Guiimartinho/open-power-profiler/hardware/README.md

# Hardware

The carrier board of the instrument: schematic, PCB layout and fabrication
outputs. The simulations of its circuits are a package of their own, in
[`../simulation/`](../simulation/README.md).

The instrument is two boards. A Raspberry Pi Pico 2, bought ready-made, is
the controller. It plugs into two rows of pin sockets on the carrier board
designed here, which holds everything else: power input, source meter, shunt
ladder, signal chain, side data and connectors. Sections 4.11 and 5 of the
[specification](../docs/specification.md) define the interface.

Rendered view of the carrier board, draft A2

The picture is a rendering from the KiCad files, with the Pico 2 on its
sockets. It is not a photograph: no board has been built.

## Status

Draft A2 with a reviewed layout, as of 2026-10-13. The KiCad project holds
the whole carrier board: the schematic with 428 parts on fifteen A4 pages
(the root sheet and fourteen sheets) and a four-layer board of
150 mm × 100 mm on which every connection is drawn. The board was placed by
a script and routed by an autorouter, which left 28 connections open. On
2026-10-10 its layout was reviewed with scripts: the open connections were
closed and the copper that an autorouter does not draw was drawn. Every
figure of the board in this guide is calculated from the drawn copper. On
the same day the circuits of the schematic were simulated from its netlist,
block by block; the central design figures of the specification come out
again ([Circuit Simulations](#circuit-simulations)). The simulations
raised four points, which the owner decided the same day: decisions D-95
to D-98 of the specification. Three of them are drawn since that day, as
changes of values, part numbers, fitted flags and texts: 10 nF at C32 to
C34 (D-95), the damper R14 and C5 fitted (D-98), and the text of the
position U9, which stays without a part (D-97). They changed no copper and
moved no part. The fourth is not drawn: a position for a capacitor at the
buffer U28 (D-96), which needs a footprint and copper. The simulations
were not run again, so their results describe the circuit before the
three changes
([Decisions That Follow the Simulations](#decisions-that-follow-the-simulations)).

On 2026-10-13 the owner opened the project in the KiCad editor, the
schematic and the board, and found both coherent. That was a look, not a
review item by item, and no edit was saved. The same day the footprints
and the placement were reviewed on a copy of the project, with scripts on
the board file, 3D renderings of every region of the board and the
datasheets. Five findings of that review were worked into the board, at
those points only and with no new routing: the pre-regulator U16 has the
land pattern of its own package, eleven vias were moved away from pads and
from under the wall of the shield can, reference texts stand at their own
parts, and the console header J1 has the names of its pins. The silkscreen
also carries the frames and names of the sixteen functional blocks now
([Review of Footprints and Placement](#review-of-footprints-and-placement-2026-10-13)).
Both rule checks report nothing on the present files (run on 2026-10-13).
Nobody has reviewed the board item by item in the KiCad editor, no board
is built, and nothing is measured.

Later that day the owner asked for the files that are needed to send the
board to fabrication. The fabrication outputs of draft A2 are filed in
[`fabrication/draft-a2/`](fabrication/draft-a2/README.md) for an order of
proof-of-concept boards. That is decision D-105 of the specification: the
items that the specification puts before an order are still open, boards
made from these files are draft A2 and not revision A, and those items
stay open
([Fabrication Outputs of Draft A2](#fabrication-outputs-of-draft-a2)).
No order is recorded: no board has been ordered or made as far as the
repository shows.

| What | State |
| --- | --- |
| Schematic | Every sheet drawn: 428 parts, 225 nets, 15 pages; not changed by the layout review. Three decisions of 2026-10-10 are drawn in it since that day, as changes of values, part numbers, fitted flags and texts: 10 nF at C32 to C34 (D-95), R14 and C5 fitted (D-98), the text of the position U9 (D-97). One is not drawn: the position for a capacitor at U28 (D-96). On 2026-10-13 one field changed and no connection: U16 on the Source Meter sheet, and its symbol in the project library, name the new project footprint |
| Electrical rules check | 0 errors, 0 warnings; run again on 2026-10-13, after the round that followed the review of footprints and placement |
| Netlist against datasheets | Checked independently, before the three decisions were drawn; no blocker and no major defect found |
| Symbols and footprints against libraries and datasheets | Compared on 2026-10-13: every footprint of the board equals its library footprint pad by pad, 55 of the 59 symbols of the parts are unchanged symbols of the KiCad library, and the four project symbols agree pin by pin with their datasheets ([list](#what-was-compared)). It closes no component check |
| Bill of materials | 151 lines for 370 parts, each line with a part number and a maker; three lines without stock on 2026-10-09; not changed by the layout review. Exported again on 2026-10-10: it holds 10 nF at C32 to C34 (D-95) and the two parts of the damper, R14 and C5 (D-98). Exported again on 2026-10-13: one line changed, the footprint of U16 |
| Component checks | 0 closed; every part is a candidate |
| Board, placement | 425 footprints placed by a script, all on the top side; 35 of them moved or turned in the layout review, none since. Reviewed on 2026-10-13 with scripts on the board file, 3D renderings and datasheets: no courtyard overlaps another, nothing stands under the module, 58 parts stand inside the shield can and none across its wall ([list](#what-was-compared)). Not reviewed item by item by a person in the KiCad editor |
| Board, routing | 984 of 984 connections, none open: 8.40 m of track in 3,743 segments, 694 vias, 42 copper zones. The round of 2026-10-13 routed nothing again: it moved eleven vias and added 27 short pieces of track, 15.9 mm in all, to the 3,716 segments that the board had (8.38 m), which are unchanged |
| Design rules check with schematic parity | 0 violations, 0 unconnected pads, 0 footprint errors, 0 differences between board and schematic, against a rule file that asks more than the one of the autorouted board; run again on 2026-10-13, after the round of that day |
| Layout review | Done on 2026-10-10 with scripts and checked by independent calculation |
| Look in the KiCad editor | On 2026-10-13 the owner opened the schematic and the board in the KiCad editor and found both coherent. A look, not a recorded review item by item; no edit was saved |
| Review of footprints and placement | Done on 2026-10-13 on a copy of the project, with scripts on the board file, 3D renderings of every region of the board and the datasheets. Five findings, each worked into the board the same day ([section](#review-of-footprints-and-placement-2026-10-13)) |
| Silkscreen | Since 2026-10-13: the frames and names of the sixteen functional blocks, the pin names of the console header J1, and 330 of the 425 reference texts visible, each at its own part; 95 are hidden, and every hidden reference is on the fabrication layer. Missing: the net names of the test points, the functions of the two jumpers and a frame for the serial number |
| 1 A path, copper only | 19.5 squares (10.4 mΩ at 40 °C) in source mode and 23.3 squares (12.3 mΩ at 40 °C) in ampere mode, against a limit of 30 squares; calculated from the drawn copper, again on 2026-10-13 with the same result |
| Surface leakage into the measured node | 5.1 nA against a budget of 10 nA; calculated from the drawn copper with the assumptions of section 10.3 of the specification, again on 2026-10-13 with the same result |
| Deviations from the words of section 10 | Seven, each recorded as a decision of the specification on 2026-10-10: D-87 to D-93 ([list](#decisions-of-the-layout-review-d-87-to-d-93)) |
| Open items of the layout | Eleven that need parts moved or another footprint, and five points that the layout review did not touch ([list](#open-items)). The round of 2026-10-13 worked on two of them, the vias at pads and the hidden reference texts; what it left is listed with it ([list](#still-open-after-the-round)) |
| Thermal check of the linear regulator | Open: the temperature rise of U18 at full dissipation is read on the first board (D-93) |
| Calculation scripts | In [`tools/board/`](../tools/board/README.md): they calculate the figures of the board again from the board file ([how](#reproducing-the-figures)) |
| Circuit simulations | Done on 2026-10-10 from the netlist of this schematic as it stood before the three drawn decisions, in [`../simulation/`](../simulation/README.md): 134 benches, 93 on the circuits of the board and 41 on the models; 1834 figures pass, 122 fail and 1206 carry no limit. Not run again since: the netlist snapshot holds the three changes, the results do not. The snapshot still matches the schematic on 2026-10-13; the round of that day did not change the circuit. Every active part is a model written from its datasheet; nothing is measured |
| Decisions that follow the simulations | Four, decided by the owner on 2026-10-10: D-95 to D-98. Drawn since that day: 10 nF at C32 to C34 of the rail monitor, the damper R14 and C5 fitted, and the text of the detector position U9, which stays without a part. Not drawn: a position for a capacitor at the buffer U28, which needs a footprint and copper ([list](#decisions-that-follow-the-simulations)) |
| PIO programs | Not written |
| Fabrication outputs | Filed on 2026-10-13 in [`fabrication/draft-a2/`](fabrication/draft-a2/README.md): eleven Gerber files of the four-layer board and two drill files, also as one archive, and two assembly files with the 360 surface-mount placements of the top side in 142 lines. Exported from the board file of this directory; the drill file and the coordinate frame were checked. No Gerber viewer has read the files back, and no manufacturer has reviewed them ([section](#fabrication-outputs-of-draft-a2)) |
| Order of proof-of-concept boards | Decided by the owner on 2026-10-13 (D-105): boards of draft A2 may be ordered with the items before an order still open; they are not revision A. The outputs are filed and the order is the owner's. None is recorded: no board has been ordered or made as far as the repository shows |
| Measurements | None: no board has been built |

What the draft has behind it:

- The schematic passes the electrical rules check of KiCad with no errors
  and no warnings. The netlist that KiCad exports equals the netlist the
  drawings were generated from (428 parts, 225 nets), and every symbol pin
  has a pad in its footprint (65 pairs of symbol and footprint). That
  comparison was made before the three decisions below were drawn; they
  changed fields of six parts and no connection.
- Three decisions that follow the simulations are drawn since 2026-10-10
  (D-95, D-97 and D-98), as changes of values, part numbers, fitted flags
  and texts on three sheets and on six footprints of the board. No wire,
  track, via, zone or pad changed, and no footprint moved. Both checks
  were run again on the changed files on 2026-10-12 and report nothing.
  The bill of materials, the PDF, the pictures of the three sheets and
  the two renderings of the board were exported again from them
  ([Decisions That Follow the Simulations](#decisions-that-follow-the-simulations)).
- The netlist was checked independently against the datasheets: symbol,
  footprint and ratings of every part type that is new in this draft, and
  six subsystems as a whole (power, source meter, ampere path, measuring
  chain, controller and logic, and the seams between the blocks). That
  check found no blocker and no major defect. It is not a component check:
  it closes no item of section 16 of the specification. Its notes are not
  filed in this repository, so the result can be read here but not
  inspected: it counts as a review, not as evidence.
- Every line of the bill of materials has a part number and a maker (151
  lines for 370 parts; section 17 of the specification).
- The board is fully connected: 984 of 984 connections. It passes the
  design rules check of KiCad with no rule violation, no unconnected pad
  and no difference between board and schematic ([Checks](#checks)).
- The layout was reviewed against the rules of section 10 of the
  specification: the 1 A path is drawn as pours, a guard surrounds the
  measured node, the Kelvin lines are drawn again, the 5 V rail is a pour
  and two layers carry ground fills. Each block was drawn with scripts and
  then calculated again by an independent check, and a final review of the
  whole board recorded 75 findings, of which 41 were open at its end
  ([Layout Review](#layout-review)).
- The figures of the board are calculated from the drawn copper: squares
  and resistance of a pour, surface leakage with an assumed sheet
  resistance, lengths of tracks and distances between copper. None is a
  measurement. The scripts that calculate the resistance of the 1 A path,
  the lengths of the pairs, the vias on the sense nets and the surface
  leakage are in [`tools/board/`](../tools/board/README.md), so those
  figures can be calculated again from the board file
  ([Reproducing the Figures](#reproducing-the-figures)).
- The seven points in which the board departs from the words of section 10
  of the specification are decisions of the specification, D-87 to D-93,
  accepted by the owner on 2026-10-10 on the recommendation of the layout
  review. Sections 10.3, 10.4, 10.6 and 10.8 of the specification say what
  the board has
  ([list](#decisions-of-the-layout-review-d-87-to-d-93)).
- The circuits of the schematic were simulated in ngspice from its
  netlist, block by block: a bench names parts by their reference
  designators and their elements are written from a snapshot of the
  netlist, so no part of the board is typed by hand. What stands around
  the parts is typed by the bench: sources, loads, cables, and in some
  benches a stand-in for a neighboring block. The central design figures
  of the specification come out again: the shunts and the burden, gain,
  zero and settling of the chain, the thresholds and the jump path, the
  drop of requirement R-07, the set-point and the head room of the
  source, the in-rush at the output, the order of the rails and the
  limits of the power input. The models are written from datasheets, and
  41 benches put them into the test circuits of those datasheets. The
  runs are those of 2026-10-10, on the circuit before the three drawn
  decisions ([Circuit Simulations](#circuit-simulations)).
- On 2026-10-13 the owner opened the project in the KiCad editor and found
  the schematic and the board coherent. It was the first time a person
  looked at the drawings there. It was a look: nothing was recorded item
  by item, and no edit was saved.
- The same day the footprints and the placement were reviewed on a copy of
  the project, with scripts on the board file, 3D renderings of every
  region of the board and the datasheets. Every footprint of the board
  equals the footprint of the same name in its library, the four project
  symbols agree pin by pin with their datasheets, and the terminal block,
  the USB-C receptacle, the socket strips and the 0.1 Ω shunt agree with
  the drawings of their makers. No courtyard overlaps another, and no part
  stands under the module. The five findings of that review are worked
  into the board: the land pattern of U16, vias at pads and under the wall
  of the shield can, reference texts, and the pin names of J1
  ([Review of Footprints and Placement](#review-of-footprints-and-placement-2026-10-13)).
- The fabrication outputs of the board are filed since 2026-10-13, for an
  order of proof-of-concept boards (D-105). Two things were checked on
  them: the drill file holds 787 plated holes, which are the 694 vias and
  the 93 holes of pads of the board, and every layer, the drill file and
  the placement file lie in one coordinate frame
  ([Fabrication Outputs of Draft A2](#fabrication-outputs-of-draft-a2)).
- The notes on the sheets were compared with the specification figure by
  figure and corrected where they differed, and the notes of the three
  sheets that the drawn decisions changed follow them. The six pictures of
  the board in [`doc/`](doc/README.md) were plotted again on 2026-10-13
  from the final board file, and the PDF was exported again that day. Its
  fifteen pages are the same as before: the one change of the schematic
  since 2026-10-10, the footprint field of U16, is hidden on its sheet.
  The pictures of the sheets are those of 2026-10-09 and 2026-10-10.

It is not a checked design, and it is not revision A. The owner decided on
2026-10-13 that proof-of-concept boards may be ordered from it as it
stands (D-105). Every point below holds for such boards too:

- Nothing has been built and nothing has been measured. Every figure in
  these documents is a datasheet value, a calculation, a simulation or an
  estimate; the specification says which.
- The parts are the candidates of the specification. No component check of
  [`docs/checks/`](../docs/checks/README.md) is closed, and the open checks
  of section 16 of the specification stand, the bench items among them.
- The layout review was done with scripts, and so was the review of
  footprints and placement of 2026-10-13. The owner opened the project in
  the KiCad editor that day and found it coherent, which was a look.
  Nobody has reviewed the board there item by item, as a person does
  before ordering boards.
- Eleven items of the layout are open because they need parts moved or
  another footprint, the loops of the converter capacitors among them, and
  five points of section 10 were not touched by the layout review. One of
  the eleven is done in part since 2026-10-13: nine vias were moved away
  from pads, and two still stand at one.
- The silkscreen is not finished. Since 2026-10-13 it has the frames and
  names of the functional blocks, the pin names of J1 and 330 of its 425
  reference texts at their own parts. 95 reference texts are hidden,
  those of the diodes D6, D11 and D17 among them, and the net names of
  the test points, the functions of the two jumpers and a frame for the
  serial number are missing.
- The temperature rise of the linear regulator U18 at its full dissipation
  is an open check of section 16 of the specification, to be read on the
  first board: the island of output copper on the top layer is smaller
  than the one the datasheet figure stands for (D-93).
- A simulation is not a measurement. Every active part in it is a model
  written from a datasheet, typical and at room temperature; the layout,
  leakage at the nanoampere level and temperature are not in it, and the
  range sequencer is a model of the firmware rules F-16 to F-18, because
  its program does not exist.
- One decision that follows the simulations is not drawn: a position for
  a capacitor at U28, which needs a footprint that the board does not
  have (D-96). Of the three that are drawn, the two that change the
  circuit, D-95 and D-98, are not simulated as drawn: the benches were
  not run again, and the results on file are those of the circuit before
  these changes
  ([Decisions That Follow the Simulations](#decisions-that-follow-the-simulations)).
- In fourteen places the simulation and the text of the specification
  differed. Twelve are corrected in the specification since 2026-10-10,
  two wait for the run of the benches on the drawn decisions, and seven
  questions are open in its section 16. One recommendation among them
  would change the hardware: one resistor in the divider of the 5 V
  monitor channel.
- The helpers that drew the layout are not in this repository. The board
  file is the record of what was drawn.
- The range logic and the sampling clock are programs for the PIO blocks of
  the controller. They are not written yet; until they are, the pin
  assignment of the controller is provisional.
- One position carries no part. It is marked "do not populate" and is
  left out of the bill of materials: a voltage detector at the enable pin
  of the boost converter (U9), drawn as the remedy for a bench item of
  section 16 (decision D-84). By decision D-97 it stays without a part,
  and since 2026-10-10 its text reads "Detector, ms time-out": the 803
  type with its time-out of 0.24 s is no longer the part meant for it.
  Draft A2 had drawn two more positions without parts, the damper on the
  module input (R14, C5); they are fitted since the same day (D-98).
- Three lines of the bill of materials had no stock at an authorized
  distributor on 2026-10-09: the 1.5 µH inductor of the pre-regulator
  (L2, Coilcraft XFL4020-152MEC; Würth 74438356015 fits the same pads)
  and the capacitors Samsung CL21A106KAYNNNE and CL31A226KAHNNNE. The
  first of the two capacitors is also C5 of the damper since D-98.
- The pre-regulator U16 stands on the land pattern of its own package
  since 2026-10-13, as a project footprint: a thermal land of
  1.58 mm × 2.85 mm, as the drawings of the manufacturer ask. Until then
  it stood on a library footprint for another package, with a thermal
  land of 1.70 mm × 3.30 mm. The finger lands that the drawing of the
  manufacturer shows at the two short ends of the package are not drawn.
- The KiCad installation that was used has no 3D model of five parts: the
  current limiters U3 and U4, the inductor L2, the frame SH1 of the
  shield can and the lever terminal block J4. The renderings show only
  their pads, and these parts were judged by numbers. For J4 the hole
  pattern, the housing and the side that the conductors enter from, the
  board edge, were compared with the datasheet of the manufacturer on
  2026-10-13.
- No drawing was found that shows the lower edge of the frame of the
  shield can: how the frame sits on its lands is not confirmed by a
  document of the maker.
- The standard packages (SOIC, SOT-23, TSSOP, MSOP and the chip sizes)
  were compared by the package code in the part number, not in each
  datasheet. The land pattern of every part against its datasheet is part
  of the component checks, of which none is closed.
- The fabrication outputs are as `kicad-cli` wrote them. No Gerber viewer
  has read them back, and no manufacturer has reviewed them. The two
  assembly files carry manufacturer part numbers only, with no check
  whether the assembler stocks a part, and their rotations are those of
  KiCad.

## Layout

| Path | Content |
| --- | --- |
| `kicad/` | KiCad 10 project: schematic sheets, board, design rules and library tables |
| `kicad/lib/` | Project symbol and footprint libraries |
| `doc/` | Pictures of every schematic sheet and of the board, the schematic as PDF, and the bill of materials of the draft as CSV |
| `fabrication/` | Fabrication outputs, one folder per draft or revision that has them: Gerber and drill files, bill of materials and placement for assembly. [`fabrication/draft-a2/`](fabrication/draft-a2/README.md) holds those of draft A2 since 2026-10-13, for proof-of-concept boards (D-105); `fabrication/rev-a/` is the folder that revision A will get |

The simulations are not in this directory. They are a package of their own
at the root of the repository, [`../simulation/`](../simulation/README.md),
by decision D-94: it reads a snapshot of the netlist of this schematic and
holds the models, the benches and their results.

## KiCad Project

Open `kicad/power-profiler-carrier.kicad_pro` with KiCad 10. To look at the
design without KiCad, see [`doc/`](doc/README.md): every sheet with a
description and the board as pictures, and
[`doc/schematic.pdf`](doc/schematic.pdf).

KiCad writes into the project when its editors open it. When the owner
opened the schematic editor on 2026-10-13, KiCad wrote its default `erc`
and `schematic` settings blocks into `power-profiler-carrier.kicad_pro`:
334 lines were added, and nothing was changed or removed. The severities
of the board checks and the net classes are as they were. KiCad 10 also
keeps a folder `.history/` beside the project, on the local disk; git
ignores it.

The board carries the name of the project: the silkscreen text at its
bottom edge reads "Open Power Profiler - Carrier Board   rev A2 draft",
and the title blocks of the board file and of the root page of the
schematic read "Open Power Profiler - Carrier Board". The schematic PDF and
the picture of its root page were exported again with that title. Later
on 2026-10-10 the PDF and the pictures of three sheets, Power Input,
Analog Rails and Rail Monitor, were exported once more, with the three
drawn decisions; the pictures of the other eleven sheets are those of
2026-10-09. The PDF was exported again on 2026-10-13: it carries the
fields of the symbols as data, and with them the footprint name of U16,
which changed on the Source Meter sheet. That field is hidden on the
sheet, and the fifteen pages are the same as in the export before.

### Schematic

| Page | Sheet | File | Content |
| --- | --- | --- | --- |
| 1 | Root | `power-profiler-carrier.kicad_sch` | One block per sheet and the wires between them |
| 2 | Controller | `controller.kicad_sch` | Raspberry Pi Pico 2 on its sockets, supply of the module, pull and series resistors of the SPI and acquisition lines, series resistors of the two status lines, reset button, console header |
| 3 | Power Input | `power_input.kicad_sch` | USB-C power connector, one current limiter per USB input, priority multiplexer that drives the 5 V rail |
| 4 | Logic Supplies | `logic_supplies.kicad_sch` | Supervisor of the 5 V rail, the two 3.3 V regulators, power LED, mounting holes, fiducials |
| 5 | Analog Rails | `analog_rails.kicad_sch` | +13.5 V boost, +12 V and −4 V rails with their clamps, 2.5 V reference |
| 6 | Rail Monitor | `rail_monitor.kicad_sch` | Four comparators that watch the analog rails and the reference: PWR_GOOD |
| 7 | Source Meter | `source_meter.kicad_sch` | Pre-regulator that tracks the output, linear regulator with its clamps, DAC and set-point amplifier |
| 8 | Path Switching | `path_switching.kicad_sch` | Source and ampere mode switches with their gate networks and interlock, VIN input and its protection |
| 9 | Shunt Ladder | `shunt_ladder.kicad_sch` | Four shunts, range switches with their drivers, ladder clamp, Kelvin multiplexer |
| 10 | Output Stage | `output_stage.kicad_sch` | Output switch with slow turn-on, DUT connectors and their suppressor, guard buffer |
| 11 | Signal Chain | `signal_chain.kicad_sch` | Instrumentation amplifier, pedestal, limiter on its own driver rail, filter, converter, shield can |
| 12 | Comparators | `comparators.kicad_sch` | Step up, over-current and jump thresholds |
| 13 | Side Data | `side_data.kicad_sch` | Two shift registers: status and logic inputs of every sample |
| 14 | Digital Inputs | `digital_inputs.kicad_sch` | Logic port, protection, series resistors and pull-downs, level translator |
| 15 | Monitors | `monitors.kicad_sch` | Eight slow channels and the temperature sensor |

Drawing conventions:

- Every page is A4.
- Connections inside a sheet are wires. Supply rails use power symbols.
- A signal that goes to another sheet ends on a hierarchical label, and the
  root sheet joins the sheets with wires.
- Reference designators are numbered as the annotation tool of KiCad does by
  default: one count per prefix (`R1`, `R2`, ... and `C1`, `C2`, ...), in the
  order of the sheets, and on a sheet by position (decision D-45).
- Each sheet carries notes with the design values of its block. In the
  notes, "range 0" to "range 3" are the four current ranges, so that they
  are not taken for resistors. On the Digital Inputs sheet, "D0" to "D7"
  are the logic inputs, named as on the logic port of the PPK2: they are
  not diodes.
- A part drawn with a cross is a position without a part.

Supply rails:

| Rail | Source | Feeds |
| --- | --- | --- |
| `+5V` | Priority multiplexer: the USB-C connector of the carrier through a 2.0 A limiter, or the USB connector of the Pico 2 through a jumper and a 0.76 A limiter | Every converter and regulator, the supervisor, and the Pico 2 through a diode |
| `+13V5` | Boost converter, running whenever `+5V` is present | +12 V_A regulator, control pin of the output regulator |
| `+12V_A` | Low-noise regulator | Amplifiers, multiplexer, gate drivers, buffers |
| `-4V_A` | Inverting charge pump with regulator | Amplifiers, multiplexer, buffers, minimum load of the output regulator |
| `+3V3_A` | Low-noise regulator | Converter, comparators, DAC, monitor, reference, buffer of the driver rail, tracking amplifier of the pre-regulator, temperature sensor |
| `+3V3_C` | Regulator | Logic of the carrier, rail monitor, power LED |
| `VREF` | 2.5 V reference, supplied from `+3V3_A` | Converter, DAC, monitor, thresholds, pedestal, driver rail |

A supervisor on `+5V` enables both 3.3 V regulators, the +12 V_A regulator,
the charge pump and, through a transistor, the pre-regulator: below 3.83 V
to 4.00 V on the rail (calculated) the carrier is off, with no firmware
involved (decision D-48). The power tree with its thresholds and its
start-up order is in section 3 of the specification.

The bill of materials is generated from the schematic, in which each of
its parts carries the fields `MPN` and `Manufacturer`: one line per part
number, 151 lines for 370 parts. The position without a part (U9), the
test points, the mounting holes, the fiducials and the solder jumpers are
not in it. The file was exported again on 2026-10-10, after the three
decisions were drawn. C32 to C34 moved to the line of the 10 nF C0G
capacitor (Murata GRM1885C1H103JA01D), and R14 and C5 joined the lines
of the 0.33 Ω resistor (Panasonic ERJ-6RQFR33V) and of the 10 µF 25 V
X5R capacitor (Samsung CL21A106KAYNNNE). All three part numbers were on
the list before, so it still has 151 lines; it has two parts more, 370
where it had 368. The list of this draft is filed as
[`doc/bom.csv`](doc/bom.csv); to make it again, from `kicad/`:

```sh
kicad-cli sch export bom --output ../doc/bom.csv --fields 'Reference,Value,Footprint,MPN,Manufacturer,${QUANTITY}' --group-by 'Value,Footprint,MPN,Manufacturer' --exclude-dnp power-profiler-carrier.kicad_sch
```

### Board

`power-profiler-carrier.kicad_pcb` is linked to the schematic: every
footprint has its nets and its symbol. All 984 connections are drawn. The
figures of this section are counted or calculated from the board file;
none is measured.

- Outline 150 mm × 100 mm with a corner radius of 3 mm and four M3 holes
  (decision D-85).
- Four copper layers, used as the table below says. All 425 footprints are
  on the top side. The schematic has 428 parts: the two sockets of the
  module (MP1, MP2) sit in the holes of the module footprint, and the cover
  of the shield can (MP3) snaps onto its frame, so these three have no
  footprint of their own.
- The stackup in the board setup is the build that section 10.1 of the
  specification assumes until a manufacturer is chosen: 1.6 mm, 35 µm
  outer and 17.5 µm inner copper, 0.2 mm of dielectric between each outer
  layer and the inner layer next to it, gold finish (ENIG).
- Back edge, on the left: the USB connector of the Pico 2, which lies along
  the top edge, and below it the USB-C power connector.
- Front edge, on the right, from the top: the logic port, the DUT pin header
  and the DUT lever terminal block, each with the names of its pins; the
  limits of VOUT and VIN are printed below the terminal block.
- The console header J1, below the module, has the names of its pins on
  the silkscreen since 2026-10-13: TX, RX and GND. The text beside it
  reads "PICO USB" over "DATA/POWER" and names the USB connector of the
  module.
- The areas of the sixteen functional blocks are on the silkscreen since
  2026-10-13, each as a frame with its name
  ([Block Frames on the Silkscreen](#block-frames-on-the-silkscreen)).
  Until then the same frames and names were on the documentation layer
  `User.Drawings`, which the board file and the plot commands call
  `Dwgs.User`; they are removed there. The areas follow section 10.1 of
  the specification: the switching converters in the left third, the
  front end right of center under the frame of a shield can, the 1 A
  branch of the ladder between the can and the terminal block.
- Net classes for the 1 A path, the supply inputs, the switch nodes, the
  rails, the sense and guard nets, the gate nodes and the clocked lines are
  defined in the project file, thirteen with the default class. The file
  `power-profiler-carrier.kicad_dru` adds the clearances that a net class
  cannot express ([Design rules check](#design-rules-check)). The classes
  are bound to the names of the nets: after a change to the schematic,
  check that the nets of the 1 A path still have their class.

Placement of the functional blocks

The picture is a plot of three layers of the board file, made again on
2026-10-13: the silkscreen with the frames and names of the blocks, the
fabrication layer with the outlines and the references of the parts, and
the courtyards.

#### Placement

The parts were placed by a script, from the netlist and from a table that
gives each part the pin it serves and its largest distance from it.
Connectors, mounting holes, fiducials and the frame of the shield can stand
at fixed coordinates. The result of the run that placed this board:

- Every part is inside the rectangle of its block, no courtyard overlaps
  another, and nothing stands under the controller module.
- Only the 58 parts of the front end are inside the frame of the shield
  can.
- 95.9 % of the 370 distances of the table are kept, taken as the copper
  gap between the two pads, and so are those of all 47 decoupling
  capacitors.

The layout review moved or turned 35 of the 425 footprints, 33 of them by
2.75 mm or less. Two moved farther: the test point of VOUT, TP38, by
11.2 mm onto the pour of VOUT, and the suppressor of VOUT, D21, by 8.6 mm.
No part was added or removed, and the round of 2026-10-13 moved none.

The reference designators of 95 parts are hidden on the silkscreen, where
no free place is left beside the part. They were 115 after the placing
run and 123 after the layout review; the round of 2026-10-13 showed 31 of
them again and hid three. Every hidden reference is on the fabrication
layer, which the picture above shows. That layer has the reference of
423 of the 425 footprints; the two that have none there are the solder
jumpers JP1 and JP2, whose references are visible on the silkscreen.

The placement was reviewed on 2026-10-13 with scripts on the board file,
3D renderings and datasheets
([Review of Footprints and Placement](#review-of-footprints-and-placement-2026-10-13)).
Nobody has reviewed it in the KiCad editor item by item, and several
[open items](#open-items) of the layout are placement changes.

#### Routing

The board was first routed automatically with FreeRouting 2.5.0, through a
Specctra export of the placed board and an import of the session file
(decision D-86), in several runs that each continued from the board of the
run before. That autorouted board connected 956 of the 984 connections and
left 28 open, 25 of which broke a function: the 5 V rail was in pieces,
neither mode had a complete current path, and one Kelvin sense line of the
0.1 Ω shunt had no track. Its power nets were tracks of 0.4 mm and 0.5 mm.

The layout review of 2026-10-10 continued from that board. It closed the 28
connections and drew the copper that an autorouter does not draw
([Layout Review](#layout-review)). On 2026-10-13 a round at single points
followed: eleven vias were moved, each with a short piece of track, and
U16 got other lands
([Review of Footprints and Placement](#review-of-footprints-and-placement-2026-10-13)).
The board in its three states:

| Item | Autorouted board | After the layout review of 2026-10-10 | Now, after the round of 2026-10-13 |
| --- | --- | --- | --- |
| Connections | 956 of 984, 28 open | 984 of 984, none open | 984 of 984, none open |
| Tracks | 7.83 m in 3,228 segments | 8.38 m in 3,716 segments | 8.40 m in 3,743 segments |
| Vias | 499, of which 26 of 0.8 mm with a 0.4 mm hole | 694: 594 of 0.6 mm with a 0.3 mm hole and 100 of 0.8 mm with a 0.4 mm hole; 336 of them on ground | The same counts; eleven of the vias stand at another place |
| Copper zones | 1, the ground plane | 42: the pours of the 1 A path, the pours of the converters, the 5 V rail, the guard, the ground fills | The same 42 |
| Ground plane | One piece | One piece of 14,205 mm², no track on its layer | One piece of 14,205 mm², no track on its layer |
| Ground fills | None | 10,891 mm² on the second inner layer and 12,108 mm² on the bottom layer, stitched to the plane with 41 added vias | 10,891 mm² on the second inner layer and 12,106 mm² on the bottom layer, filled again around the moved vias |
| 5 V rail | Tracks of 0.4 mm | A pour of 1,623 mm² on the second inner layer, in three pieces | The same pour, 1,622 mm² in three pieces |
| Reference designators hidden on the silkscreen | 115 | 123 | 95 |

The layers as they are used now:

| Layer | What it carries |
| --- | --- |
| `F.Cu`, top | All parts; the pours of the 1 A path and of the converters; the Kelvin lines; the guard ring and its pour; 3.77 m of track |
| `In1.Cu`, first inner layer | The ground plane: one piece, no track. The clearances of vias and through-hole pads open 787 mm² of it in all (593 mm² on the autorouted board, which had 499 vias) |
| `In2.Cu`, second inner layer | The pour of the 5 V rail; 2.84 m of track, among them rail trunks, 41 mm of the ladder output and 64.8 mm of the guard; a ground fill, which those tracks cut into 80 pieces |
| `B.Cu`, bottom | 1.79 m of track; the second layer of the supply band of the 1 A path; the output island of the linear regulator; the two pieces of the 1 A path that have no room on top; the output pour of the pre-regulator; four guard pours under the measured node; a ground fill |

The four copper layers

The picture shows the four copper layers side by side, plotted from the
board file: top, ground plane, second inner layer, bottom. Two details of
the top layer are in the next section: the measured node under the shield
can ([`board-front-end.png`](doc/images/board-front-end.png)) and the 1 A
path ([`board-1a-path.png`](doc/images/board-1a-path.png)). The rendered
views are in [`doc/`](doc/README.md); in the top view the gold line around
the front end is the guard under open solder mask.

#### Design Rules Check

The design rules check of KiCad, with schematic parity, reports on this
board 0 rule violations, 0 unconnected pads, 0 footprint errors and 0
differences between board and schematic. The commands are under
[Checks](#checks).

The rule file was rewritten in the layout review and has thirteen rules
now. It asks more than the file the autorouter ran against, so the result
above is not the same statement as "0 violations" on the autorouted board.
In plain words:

- Copper of different nets keeps 0.15 mm, except from pad to pad inside a
  footprint.
- The larger spacings (1 A path, switch nodes, measured node, gate nodes,
  VIN) still leave out a track that touches the courtyard of a footprint,
  because at the pins of a part the pad pitch decides. That exemption now
  applies on the top layer only. Before, it also freed copper on the other
  layers under a part, although every part is on the top side.
- The measured node keeps 0.5 mm from foreign nets on the bottom layer too,
  and there the rule also covers the ladder output.
- The copper fills of other nets keep 1.0 mm from the measured node on the
  two outer layers. On the inner layers a via of the measured node opens
  the ground plane by the normal clearance and not by a hole of 2.6 mm.
- The pours of the measured node keep 1.0 mm from ground and rail copper
  on the outer layers, pads included: a ground pad beside such a pour is a
  leakage path into the node.
- Gate nodes keep 0.5 mm from other nets on both outer layers.
- The VIN input keeps 1.0 mm from other nets on the outer layers and 0.5 mm
  on the inner layers. Section 10.4 of the specification says 1.0 mm from
  every other net.
- The guard may run 0.2 mm beside the measured node: it is driven to the
  potential of that node.

The rewritten rule file is decision D-87, the first of the
[decisions of the layout review](#decisions-of-the-layout-review-d-87-to-d-93).
Two things it does not check: no rule counts the vias on a sense net or on
a guarded net, and no rule spaces the measured node from other copper on
the inner layers, where 41 mm of the ladder output run with the ground fill
0.15 mm beside them. Both were checked by calculation instead.

The project ignores five checks of KiCad, the same five as on the
autorouted board: a footprint without a courtyard, a track end that is not
centered on a via, the tuning profiles, the footprint filters of the
symbols, and the component type of a footprint against its pads.

### Layout Review

The layout was reviewed on 2026-10-10 with scripts that work on the KiCad
board file, block by block. Each block was drawn against the rules of
section 10 of the specification and then checked by an independent check
that calculated every rule again. After that the whole board went through a
final review by rule group, with each finding checked by a second reviewer.
A repair round followed for the leakage paths into the measured node that
this review found, and a last pass calculated every finding again on the
final board.

The final review recorded 75 findings. On the final board of that review
15 of them are fixed, 16 are improved, 41 are open and 3 are not defects.
These counts are those of 2026-10-10. The round of 2026-10-13 worked on
two of the open ones, the vias at pads that get solder paste and the
hidden reference texts
([Review of Footprints and Placement](#review-of-footprints-and-placement-2026-10-13)).
The sections below group the findings: the results by rule, the seven
decisions that the review led to, the open items, and what the review did
not touch.

What the review is and is not:

- It is a drawn and calculated layout. Every figure below is calculated
  from the drawn copper with scripts; the level of evidence is a
  calculation, in a few places with stated assumptions.
- It is not a look at the board by a person. The owner opened the project
  in the KiCad editor three days later, on 2026-10-13, and found it
  coherent; nobody has reviewed the board there item by item.
- Nothing is built and nothing is measured. Every part is still a
  candidate.
- The scripts that calculate the figures are in this repository
  ([Reproducing the Figures](#reproducing-the-figures)). The helpers that
  drew the layout are not.

#### Reproducing the Figures

The package [`tools/board/`](../tools/board/README.md) calculates the
figures of the layout from the board file: the resistance of the copper of
a net between pads, a path on one layer alone, the lengths of the two lines
of a pair along their center lines, the vias on the sense and guarded nets,
and the surface leakage into the measured node. What is specific to this
board (the pieces of the 1 A path, the three pairs, the nets of the
measured node, the assumed voltages, the rectangle of the shield can) is in
`tools/board/carrier.toml`. The package is tested on small synthetic
boards with answers known by hand, without KiCad and without hardware.

Three steps, each described in the
[README of the package](../tools/board/README.md):

1. Install the package into an environment of its own, from `tools/board/`.
2. Dump the board file to JSON with `tools/board/kicad/dump_board.py`. This
   step runs under the Python that KiCad installs, because it reads the
   board with KiCad's own module. Fill the zones and save the board first.
3. Run `board-figures report` on the dump.

From the root of the repository:

```sh
"$KICAD_PYTHON" tools/board/kicad/dump_board.py hardware/kicad/power-profiler-carrier.kicad_pcb tools/board/board.json
cd tools/board
python -m venv .venv
.venv/Scripts/python -m pip install -e ".[dev]"
.venv/Scripts/board-figures report board.json
```

`KICAD_PYTHON` stands for the path of the Python interpreter of the KiCad
installation. On Linux and macOS the folder of the environment is
`.venv/bin/` in place of `.venv/Scripts/`. The report reads
`carrier.toml` from the working directory, which is why it runs in
`tools/board/`. On the board in this directory the report prints:

| Figure | Report |
| --- | --- |
| 1 A path, source mode | 19.5 squares, 10.4 mΩ at 40 °C, with its seven pieces |
| 1 A path, ampere mode | 23.3 squares, 12.3 mΩ at 40 °C, with its eight pieces |
| Surface leakage, top layer | 4.46 nA, of which 0.73 nA inside the shield can |
| Surface leakage, bottom layer | 0.67 nA, of which 0.00 nA under the can |
| Kelvin pair of range 3 | 46.31 mm and 45.42 mm, difference 0.89 mm |
| Kelvin pair of range 2 | 28.35 mm and 27.78 mm, difference 0.56 mm |
| Pair from the multiplexer to the amplifier | 17.01 mm and 17.89 mm, difference 0.88 mm |
| Sense and guarded nets | 10 of 11 without a via |

These are the figures of the board as it is since the round of 2026-10-13,
which moved eleven vias and changed the lands of U16. They are the same
as on the board of the layout review.

The report also gives the share of the track length at the class width,
the tracks near the mounting holes and the ground vias at the lands of the
shield can. The other figures of this guide (the loops of the converters,
the 5 V rail, the copper of the reference, distances between copper) are
calculated with the commands `squares` and `path` of the package, one net
at a time, or were calculated in the review and are not part of the report.

The limits of the calculation:

- The resistances are calculated on a grid of 0.1 mm. On a grid of 0.05 mm
  the two sums read about 2 % higher: 19.9 squares and 23.8 squares.
  Compare figures made with the same grid only.
- A via counts 1.7 squares for each step from one layer to the next. That
  overstates a via, so the figure errs to the high side.
- The resistances count copper only: the transistors, the shunt, the fuse
  and the terminal are not in them, nor are solder and the heating of the
  copper by its own current.
- The leakage figure is converged at its grid of 0.04 mm. It rests on an
  assumed sheet resistance of 10¹¹ Ω per square and on assumed voltages.
  It leaves out the solder mask, flux residue, moisture and dust, the
  leakage through the laminate to the inner layers, and the leakage of the
  parts themselves. A real surface can be orders of magnitude off the
  assumed value in either direction: the figure ranks layouts and shows
  where the current would come from, and it is not an error budget.
- Every figure compares one layout with another. None predicts what a
  bench will read, and a measurement replaces it.

The helpers that drew the layout (the routing and merging scripts of the
review) are not in this repository; the board file is their result. The
simulations of the circuits are filed and can be run again
([Circuit Simulations](#circuit-simulations)).

#### Results by Rule

The column "Autorouted board" gives the figure of the board before the
review where one was calculated. Where it says "at the final review", the
figure is that of the board after the blocks were drawn and before the
repair round.

The column "Now" was calculated on the board of the layout review. The
round of 2026-10-13 moved eleven vias and gave U16 other lands. The
figures that the report of `tools/board/` gives were calculated again on
the board after that round and are unchanged: the 1 A path, the leakage,
the pairs, the vias on the sense nets, the track widths, the mounting
holes and the vias at the lands of the can. The other rows are those of
2026-10-10. Among them the rows of the pre-regulator were calculated on
the lands of its earlier footprint; the new lands end 0.10 mm nearer to
the center of the part, and the thermal land is 0.06 mm narrower on each
side and 0.225 mm shorter at each end.

| Rule | Limit in the specification | Autorouted board | Now |
| --- | --- | --- | --- |
| 1 A path in source mode, output of the linear regulator to the VOUT terminal | 30 squares of 35 µm copper (10.4) | 397 squares, about 211 mΩ | 19.5 squares, 10.4 mΩ at 40 °C |
| 1 A path in ampere mode, VIN terminal to the VOUT terminal | 30 squares of 35 µm copper (10.4) | 217 squares, about 116 mΩ | 23.3 squares, 12.3 mΩ at 40 °C |
| Surface leakage into the measured node | Leakage budget of 10 nA (4.3, 10.3) | Not calculated; about 20 nA at the final review (top layer 11 nA, bottom layer 9 nA) | 5.1 nA: top layer 4.46 nA, bottom layer 0.67 nA |
| Sense and guarded nets without a via | No via (10.3) | Not counted; one sense line of the 0.1 Ω shunt had no track | 10 of 11 on the top layer without a via; the eleventh keeps two vias and 1.9 mm on the second inner layer |
| Kelvin pair of range 3, 0.1 Ω shunt to the multiplexer | Tracks of 0.2 mm at a gap of 0.2 mm, one layer, equal within 1 mm, no via (10.3) | One of the two lines open | 46.3 mm and 45.4 mm, 0.9 mm apart in length; side by side at 0.2 mm over 83 % of the run; one line has the two vias |
| Kelvin pair of range 2, 1 Ω shunt to the multiplexer | As above | Not calculated | 28.4 mm and 27.8 mm, 0.6 mm apart in length; top layer, no via; not side by side |
| Pair from the multiplexer to the amplifier | As above | Not calculated | 17.0 mm and 17.9 mm, 0.9 mm apart in length; side by side over about 4 mm only |
| Taps of range 0 (1 kΩ) and range 1 (33 Ω) | Sensed at the pads, the tap leaving the pad as its own track (10.3) | Not calculated | Each tap leaves its pad as its own track, then runs through a via and 12 mm and 10 mm on the second inner layer; not pairs |
| Guard | A closed track of 0.5 mm on the top layer, no solder mask over it (10.3) | None | One piece of copper: three arcs on the top layer, joined through 11 vias on the other layers; inside the can 109 mm at 0.5 mm, 24 mm at 0.25 mm and 7 mm at 0.15 mm; solder mask open over 160 of 190 mm (84 %); a guard pour of 227 mm² |
| Ground copper beside the pours of the measured node, outside the can | 1.0 mm (10.3) | Not calculated; 0.15 mm at the final review | None within 1.0 mm; the ground pad of the VOUT suppressor is 1.55 mm away |
| Gate node of the output switch to VOUT copper | 2 mm except at the gate pins (10.3) | Not calculated; 0.56 mm at the final review | 2.0 mm or more except at the two gate pins |
| Test point of VOUT, TP38 | 3 mm or more from any other pad (10.7) | Not calculated; 1.50 mm at the final review | On the VOUT pour, 3.03 mm from the nearest pad |
| Ground via at each land of the shield can | One beside each land (10.3) | Not counted | All 32 lands have a ground via within 1.5 mm |
| Pre-regulator, switch nodes and ground pad | Short pours from pad to pad; six vias in the power ground pad (10.5) | Tracks | Both switch nodes are pours without a via; six vias in the pad |
| Pre-regulator, feedback line | 20 mm or less (10.5) | Not calculated | 16.4 mm |
| Pre-regulator, copper from the output capacitors to the bead | 15 mΩ or less (10.5) | Not calculated | 13.4 squares, 7.1 mΩ, on the bottom layer through groups of vias |
| Pre-regulator, loops of its five capacitors | 5 mm or less on the top layer (10.5) | Not calculated | 8.2 mm to 17.1 mm: not kept |
| Pre-regulator, inductor to the switch pins | Within 3 mm (10.5) | Not calculated | 4.5 mm from its second pair of switch pins: not kept |
| Boost converter, loop of switch pin, diode, output capacitor and ground pin | Within 5 mm (10.5) | Not calculated | 6.8 mm through the 10 µF capacitor and 10.3 mm through the 100 nF capacitor: not kept |
| Boost converter, output to the filter resistor of the +12 V regulator | One track of 25 mm or more (10.5) | Not calculated | One track of 28.8 mm |
| Charge pump, capacitors to their pins | Within 2 mm (10.5) | Not calculated; two of its connections were open | Flying capacitor and supply sides 0.9 mm to 1.3 mm; the ground sides of two capacitors 3.4 mm and 4.4 mm: not kept |
| +12 V regulator | Output sense pin routed to the pad of the output capacitor; a guard track around the copper of the SET pin (10.5) | Not checked | Sense pin routed to the pad; +12 V copper faces 75 % of the contour of the SET copper and is open at the pins |
| 5 V rail, bulk capacitor to the input capacitors of the pre-regulator | 10 mΩ, a target of the layout review; the specification gives no figure (10.1) | Tracks of 0.4 mm, the rail in pieces | 2.7 mΩ and 3.0 mΩ |
| 5 V rail, bulk capacitor to the input capacitor of the boost converter | 25 mΩ, a target of the layout review; the specification gives no figure (10.1) | Tracks of 0.4 mm, the rail in pieces | 3.6 mΩ |
| Reference | The output pin is the star point; the branches share no track (10.5) | Not checked | Ten branches that share no track beyond the star copper; that copper, 5.7 mm long, is common to several: 2.2 mΩ between the branch of the ADC and the pedestal divider |
| Track widths | The width of the net class | Rails, guard nets and gate drivers 0.25 mm or less; power nets 0.4 mm and 0.5 mm | Share of the track length at the class width or wider: rails (0.4 mm) 62 %, gate drives (0.3 mm) 71 %, power input nets (1.0 mm) 34 %, sense nets (0.2 mm) 100 % |
| Thermal reliefs | Only on the ground pads of through-hole parts; none on a pad of the 1 A path (10.4, 10.6) | Not checked; 21 such pads joined solid into the plane at the final review | Reliefs on the through-hole ground pads of the connectors, the module sockets and the reset switch, in the plane and in the fills; the pads of the 1 A path joined solid |
| Mounting holes | No track on an outer layer within 4.0 mm of the center (10.1) | Not checked | Kept |

#### The 1 A Path

The 1 A path on the top layer

The picture is the top layer from the linear regulator at the bottom left,
along the supply band to the shunt branch, the output switch and the
terminal block on the right. The path is drawn as pours on the top layer.
The supply band, 38 mm from the source pair to the shunt branch, is doubled
on the bottom layer through groups of four to eight vias of 0.8 mm with a
0.4 mm hole. The linear regulator U18 stands on an island of output copper:
291 mm² on the bottom layer and 102 mm² on the top layer, joined by 22
vias.

The pieces, in squares of 35 µm copper, calculated from the drawn copper:

| Piece | Source mode | Ampere mode |
| --- | --- | --- |
| Output of the linear regulator to the source pair | 2.2 | |
| Common source of the source pair | 0.4 | |
| VIN terminal to the fuse | | 3.5 |
| Fuse to the ampere pair | | 8.0 |
| Common source of the ampere pair | | 0.3 |
| Supply node | 6.5 | 1.0 |
| Range 3 transistor to the 0.1 Ω shunt | 1.3 | 1.3 |
| Ladder output, from the shunt to the output switch | 5.6 | 5.6 |
| Common source of the output pair | 0.6 | 0.6 |
| VOUT to the terminal | 2.9 | 2.9 |
| Sum | 19.5 | 23.3 |
| Resistance at 40 °C | 10.4 mΩ | 12.3 mΩ |

The pieces are printed to one decimal. The pieces of ampere mode add to
23.25 squares before that rounding, which is 23.3 squares.

The figures count copper only: the transistors, the shunt, the fuse and
the contacts are not in them. They end at the poles of the terminal block,
where R-06 takes the path drop. The pin header is fed from the terminal
block through two tracks of 1.0 mm, 10.2 mΩ on VOUT and 11.2 mΩ on VIN
(calculated): a load on the pin header sees about 21 mΩ more copper than a
load on the terminal block.

The tracks of the 1 A net classes that remain on the board are taps and
links, not the path. In the last step of the review 1,069 tracks of the
board were widened toward the width of their net class where the copper
around them left room, and the 41 track ends that entered 19 pads wider
than the pad were necked down to the pad.

#### The Measured Node

The measured node under the shield can

The picture is the top layer under the shield can in red, with the
openings of the solder mask in pink: the guard ring, the guard pour, the
Kelvin lines from the multiplexer to the shunts, and the lane of the
range 3 pair outside the can.

Surface leakage. The figure of 5.1 nA is calculated with the assumptions
that section 10.3 of the specification uses: 10¹¹ Ω per square on a clean
surface, 5 V to ground and logic, 7 V to the +12 V rail and to gate nodes,
9 V to the −4 V rail. Solder mask, cleanliness and humidity are not
modeled. Of the 4.46 nA on the top layer, 0.73 nA are inside the shield can
and 3.73 nA outside; of the 0.67 nA on the bottom layer, 0.00 nA are under
the can. The largest shares:

| From | Share |
| --- | --- |
| Gate of the output pair | 1.35 nA |
| Ground | 1.32 nA |
| Copper of the VIN terminal | 0.98 nA |
| Gate of the range 3 transistor | 0.62 nA |
| +12 V at pin 14 of the multiplexer | 0.47 nA |
| −4 V at pin 2 of the guard buffer | 0.26 nA |

Almost all of it is the pitch of pads: the gate beside the source in the
transistor package, the poles of the two DUT connectors, neighboring pins
of the multiplexer and of the guard buffer. No track can change that; what
is left is another footprint or cleaning. An estimate made before the board
was drawn gave 1.3 nA to 2.9 nA; section 10.3 of the specification now
carries the figure calculated from the board and names that estimate.

Sense lines. Ten of the eleven sense and guarded nets are on the top layer
without a via. The eleventh is the high-side sense line of the 0.1 Ω shunt:
with the pin order of the multiplexer and the pad order of the
four-terminal shunt, the two lines of that pair have to cross once, and no
rotation of a part changes that. The lengths in the table are taken along
the center lines from pad edge to pad edge. The pair of range 2 is equal in
length but not side by side, because the pair of range 3 runs between its
two lines under the multiplexer. The pair to the amplifier is side by side
over about 4 mm only, because its pins are on opposite sides of both
packages.

Guard. The guard is the buffered ladder output and is one piece of copper.
On the top layer it is three arcs around the measured node inside the can.
They are cut where the measured node itself leaves through the wall: the
ladder output, the supply node and the range 3 pair. A guard track runs on
both sides of each exit, and along both sides of the range 3 pair outside
the can as far as the shunt. The arcs are joined through 11 vias, with
12.8 mm of track on the bottom layer and 64.8 mm on the second inner layer,
of which 53 mm are the feed of the monitor. Four guard pours on the bottom
layer surround the via pads of the measured node. The solder mask stays
closed over the guard at the six wall crossings and between pads on
purpose, and no bare guard lies within 0.3 mm of a land of the can. The
free top copper inside the ring is a guard pour, under solder mask except
at the ring. Inside the ring there is no ground pour, but 29 pads of 10
foreign nets stand there, the supply, address and enable pins of the
multiplexer and their parts, and 18 vias.

Off the top layer. The ladder output has no track on the bottom layer any
more (37 mm at the final review). It has 41 mm on the second inner layer:
the two taps and the load track of the 1 Ω shunt, with the inner ground
fill 0.15 mm beside them, which is laminate and not a surface. Its six via
pads on the bottom layer stand in guard pours; the nearest foreign copper
to one of them is 0.81 mm away.

#### Decisions of the Layout Review (D-87 to D-93)

The reviewed board departs in seven points from what section 10 of the
specification said before the review. The owner accepted the
recommendation of the layout review on all seven on 2026-10-10. They are
recorded in the decision log of the specification (section 15) as D-87 to
D-93, and sections 10.3, 10.4, 10.6 and 10.8 of the specification now
describe the board as it is drawn. The log has 105 decisions. The last
twelve are not of the layout: D-94 places the circuit simulations, D-95
to D-98 are the decisions that followed them, D-99 to D-101 bring the
text in line with the simulations, D-102 settles the license of the
simulation folder, D-103 and D-104 are decisions of 2026-10-12 on
the software, and D-105 files the fabrication outputs of this draft for
an order of proof-of-concept boards
([Fabrication Outputs of Draft A2](#fabrication-outputs-of-draft-a2)).

Each point below quotes the sentence that section 10 carried before the
review, says what the board has and why, and names the decision. The
figures in the reasons are calculated from the drawn copper; a decision
accepts a drawn layout, not a measured one.

1. **The rule file (D-87).** `kicad/power-profiler-carrier.kicad_dru` was
   rewritten, as [Design Rules Check](#design-rules-check) says rule by
   rule. Section 10.4 said of the VIN copper that it "keeps 1.0 mm from
   every other net"; the rule file asks 1.0 mm on the outer layers and
   0.5 mm on the inner layers. Reason: an inner layer has no surface that
   joins the two nets, and the larger spacing there only opens the ground
   plane. The other changes make the file stricter, or let the guard run
   0.2 mm beside the node it guards. A custom rule that matches replaces
   the clearance of a zone and of a net class, and the old exemption near
   pins had hidden 32 places where the measured node or the VIN input
   stood too close to other copper. The decision: the rule file states
   every spacing that the layout needs. The exemption near pins applies on
   the top layer only; the 0.5 mm of the measured node apply on the bottom
   layer too, there also to the ladder output; gate nodes keep 0.5 mm on
   both outer layers; the VIN input keeps 1.0 mm on the outer layers and
   0.5 mm on the inner layers; copper fills keep 1.0 mm from the measured
   node on the outer layers; the pours of the measured node keep 1.0 mm
   from ground and rail copper, pads included; the guard may run 0.2 mm
   beside the measured node.
2. **Vias on one sense line (D-88).** Section 10.3 said "No via on a
   sense net or on a guarded net." The high-side sense line of the 0.1 Ω
   shunt R110 has two, with 1.9 mm on the second inner layer at the shunt.
   Reason: the pin order of the multiplexer against the pad order of the
   four-terminal shunt forces the two lines of the pair to cross once, and
   no rotation of a part changes that. The decision: that line keeps its
   two vias and its 1.9 mm on the second inner layer, and its two via pads
   on the bottom layer stand in a guard pour. It is the one sense net with
   a via.
3. **Kelvin pairs (D-89).** Section 10.3 asked for "a tightly coupled pair
   from each shunt to the multiplexer U24 and from there to the amplifier
   U27: tracks of 0.2 mm with a gap of 0.2 mm, on one layer, equal in
   length within 1 mm, without a via." The lengths are equal within 1 mm
   in the three pairs. But the taps of ranges 0 and 1 run through a via
   each and on the second inner layer, the pair of range 2 is not side by
   side, and the pair to the amplifier is side by side over a quarter of
   its length. Reason: the pin order of the multiplexer nests the pairs
   under its package, so only the innermost pair can run side by side,
   and the two pins of a pair are on opposite sides of the multiplexer and
   of the amplifier. The decision: the pair of R110 runs side by side at
   0.2 mm; the pair of R107 and the pair from U24 to U27 are equal in
   length within 1 mm and run side by side only where the pins allow; the
   taps of R101 and R104 leave their pads as tracks of their own and run
   through one via each on the second inner layer.
4. **The guard is not a closed ring on one layer (D-90).** Section 10.3
   said "It is a closed track of 0.5 mm on the top layer" and "The guard
   is on the top layer only." The guard is open at the three exits of the
   measured node, its arcs are joined on the other layers, parts of it are
   0.25 mm and 0.15 mm wide, and guard pours exist on the bottom layer.
   Reason: the measured node has to leave the ring on the top layer, the
   bottom pours shield the via pads of the node from the ground fill, and
   bare guard beside a soldered land of the can would bridge to ground at
   assembly. The decision: the guard is one piece of copper, open on the
   top layer at the three places where the measured node leaves the shield
   can, with a guard track on both sides of each exit and of the range 3
   pair outside the can as far as the shunt. Its arcs are joined through
   vias with tracks on the bottom layer and on the second inner layer, and
   guard pours on the bottom layer surround the via pads of the measured
   node. The solder mask is closed over the guard at the wall crossings
   and between pads.
5. **Foreign nets inside the ring (D-91).** Section 10.3 said "no ground
   pour and no foreign net inside the ring." There is no ground pour, but
   the supply, address and enable pins of the multiplexer and their parts
   are inside. Reason: the pins of the multiplexer are inside by
   necessity, and moving their parts outside would lead their nets across
   the guard on the top layer. Their share of the calculated leakage is
   0.47 nA, at pin 14 of the multiplexer. The decision: the supply,
   address and enable pins of U24 and the parts at those pins stand inside
   the guard, and no ground pour lies inside it.
6. **Width and layer of the 1 A pours (D-92).** Section 10.4 asked for
   "pours on the top layer, 4 mm to 8 mm wide". The sums are under
   30 squares, but pieces are narrower: 1.2 mm on top at the source pair,
   where the bottom band is 4.9 mm, and 2.0 mm to 2.9 mm at the poles of
   the terminal block and at test points. Two pieces run on the bottom
   layer because parts stand in the way on top: the output of the linear
   regulator to the source pair, and the fuse to the ampere pair. Clearing
   them is a change of placement. The decision: the 1 A path is judged by
   its resistance, 30 squares or less in either mode (the drawn path has
   19.5 squares and 23.3 squares). Its pours are 4 mm to 8 mm wide where
   the parts leave room and narrower at pins, test points and connector
   poles, and the two pieces named above run on the bottom layer through
   groups of vias.
7. **Top island of the linear regulator (D-93).** Section 10.6 asked for
   "an island of output copper of at least 15 mm × 15 mm on the top layer
   and the same on the bottom layer". The bottom layer has 291 mm²; the
   top layer has 102 mm². Reason: parts stand around the regulator on the
   top layer. The decision: the island under U18 is 291 mm² on the bottom
   layer, joined by 22 vias to 102 mm² on the top layer. The datasheet
   figure of 65 K/W is for 225 mm² of top copper, so the temperature rise
   of U18 at its full dissipation is an open check of section 16 of the
   specification, to be read on the first board
   ([Close the Open Checks](#5-close-the-open-checks)).

Three things that the decisions do not do. They do not close an
[open item](#open-items): those are places where the board does not keep a
rule that still stands. They do not replace the review of the board by a
person in the KiCad editor, item by item. And they rest on calculations:
where a decision quotes a leakage or a resistance, a measurement on the
first board replaces the figure.

#### Open Items

These need parts moved or another footprint, and the review did not do
that. Every figure is calculated from the drawn copper. Each item says
what would close it.

- **Loops of the converter capacitors.** Pre-regulator: the loops of its
  five capacitors close on the top layer only over 8.2 mm to 17.1 mm
  (limit 5 mm), because their ground pads face away from the converter;
  each has a ground via 0.15 mm to 0.20 mm from its pad into the plane.
  Boost converter: 6.8 mm and 10.3 mm (limit 5 mm). Charge pump: the ground
  sides of two capacitors are 3.4 mm and 4.4 mm from the pin (limit 2 mm).
  To close: turn or place the capacitors again so that their ground pads
  face the ground pad of the converter. The other way is a decision that
  the return runs through the vias and the plane, with the ripple measured
  on the phase 1 prototype.
- **Inductor of the pre-regulator.** 4.5 mm from its second pair of switch
  pins (limit 3 mm). To close: turn or move the inductor so that its pad
  faces those pins.
- **Temperature sensor U39.** 5.1 mm from pad to pad and 7.7 mm from
  center to center from the linear regulator (limit 5 mm). To close: move
  it 0.2 mm toward the regulator, or have section 10.6 say between which
  points the 5 mm are taken.
- **Suppressor of VOUT, D21.** Its cathode copper is 93 mm² (1 cm² asked),
  and it stands 8.6 mm from the VOUT pole, where section 10.4 describes it
  between the poles at 4.3 mm. It was moved away from the poles to keep
  ground 1.0 mm from the VOUT pour. To close: enlarge the VOUT pour by
  7 mm², and have section 10.4 describe the part where it stands, or place
  it again.
- **Ladder clamps Q10 and Q11.** 21 mm² and 28 mm² of supply-node copper
  lie within 5 mm of their drains (1 cm² asked), and the strip to one
  clamp is 0.6 mm wide. To close: more copper at the drains, which needs a
  resistor and a gate track moved, or a sentence in section 10.6 that the
  1 cm² is the whole supply pour.
- **Drain pad of the ampere pair on the VIN side.** The pad of that
  transistor lies in no top pour: the whole current of ampere mode enters
  through four vias of 0.6 mm with a 0.3 mm hole in the pad. To close:
  move the parts that stand between the pour and the pad, and use vias of
  0.8 mm with a 0.4 mm hole. It is the piece from the fuse to the ampere
  pair, which decision D-92 lets run on the bottom layer.
- **Openings of the ground plane.** Where the clearances of a group of
  vias merge, the plane opens: up to 4.7 mm × 2.3 mm under the island of
  the linear regulator. With 694 vias instead of 499 the plane has 787 mm²
  of openings in all, against 593 mm² on the autorouted board. To close: a
  via pitch of 1.5 mm in the groups keeps webs of plane between the vias.
- **Star of the reference.** The branches should leave the output pad
  itself; two parts stand in the way, and 5.7 mm of copper with 2.2 mΩ are
  common to the branch of the ADC and the pedestal divider. To close: move
  one of the two parts, or record the common 2.2 mΩ as a decision.
- **Distance of the +12 V regulator.** It is 22 mm, courtyard to
  courtyard, from the diode and the capacitor of the boost converter;
  25 mm are asked and are kept from center to center only. To close: move
  the regulator, or have section 10.1 say that the 25 mm are from center to
  center.
- **Vias in or at pads that get solder paste.** The final review counted
  4 via holes on a pad edge and 14 via rings on a pad, and via holes in
  the drain pads of two transistors of the 1 A path. Done in part on
  2026-10-13: the nine vias whose hole reached into a pad or stood within
  0.05 mm of one were moved, and their holes stand 0.25 mm or more from
  the pad now
  ([finding 4](#findings-and-what-was-done)). Open: two vias that were
  left where no free place exists beside them, at pin 6 of U12 (the edge
  of the hole is at the edge of the pad) and at pad 1 of R67 (0.02 mm);
  five more that stand 0.07 mm to 0.10 mm from a pad; and the via holes
  in the drain pads of the two transistors, which that round did not
  touch. To close: move the vias clear of the pads, or accept them in
  writing with a line in the assembly notes (holes filled and capped, or
  a stencil that allows for them).
- **Pads entered by a wider track.** 19 pads were entered by a track wider
  than the pad. The 41 track ends were necked down in the last step of the
  review; the item stays on this list until a person has looked at those
  pads.

Smaller findings of the final review stay open beside these, among them:
the pour of the 5 V rail is in three pieces and the three 3.3 V regulators
hang on two single vias; the six vias in the power ground pad of the
pre-regulator are of 0.6 mm with a 0.3 mm hole, where section 10.1 gives
0.8 mm with a 0.4 mm hole for power; and five tracks have an acute corner.

#### Not Touched by the Review

The layout review left these points of section 10 of the specification as
they were on the autorouted board. One of them changed afterwards: the
round of 2026-10-13 worked on the reference texts of the silkscreen. The
others are as they were:

- 32 of the 40 signal test points have no probe ground within 5 mm
  (section 10.7).
- The net names of the test points and the function of the two solder
  jumpers are not on the silkscreen (section 10.2), and there is no frame
  for a hand-written serial number (section 10.7). Reference designators
  are hidden on the silkscreen: 123 after the layout review, 95 since the
  round of 2026-10-13, those of the diodes D6, D11 and D17 among them
  ([finding 2](#findings-and-what-was-done)).
- The three acquisition lines enter the shield can at three places on two
  layers instead of through one opening (section 10.1).
- 21 nets cross the wall of the can below the ground plane, where
  section 10.3 lets tracks cross only on the top layer. The second inner
  layer carries 2.84 m of track, so its ground fill is in 80 pieces.
- The two resistor pairs of the set-point path do not stand side by side
  (section 10.1).

### Circuit Simulations

On 2026-10-10 the circuits of this schematic were simulated in ngspice,
block by block. The work is in [`../simulation/`](../simulation/README.md),
a package of its own at the root of the repository (decision D-94). A
bench names parts of the schematic by their reference designators, and the
package writes their elements from `simulation/netlist/carrier.json`, a
snapshot of the netlist that KiCad exports: 428 parts with their values
and nets. No part of the board is typed by hand. What stands around the
parts is typed by the bench and named in its notes: sources, loads,
cables, and in some benches a stand-in for a neighboring block of the
board.

The snapshot and the results are not of the same state. The snapshot was
written again after the three decisions were drawn and holds them: 10 nF
at C32 to C34, R14 and C5 with their part numbers, the new text of U9.
On 2026-10-13 `circuit-sim netlist --check` says that it matches the
netlist of the schematic in this directory; the round of that day did not
change the circuit. The benches were not run
again. Every result below is of the run of 2026-10-10, on the circuit
before these changes, and the benches of the power input still leave R14
and C5 out.

Everything in this section is simulated. No board is built and nothing is
measured. A figure that passes says that the simulated circuit keeps its
limit with the models named beside the result; it does not say that a
built board will. Every active part is a model written for this project
from its datasheet, a typical part at room temperature. 41 benches put
these models into the test circuits of their datasheets; the multiplexer
U24, the gate drivers U20, U22 and U23, the BAV199 diode pairs and the
fit of the clamp transistors Q10 and Q11 have no such bench. The models
of the manufacturers may not be copied into the repository; where a copy
was present they gave a second value.

| Block | Sheets of the schematic | Benches | Pass | Fail | No limit |
| --- | --- | --- | --- | --- | --- |
| [Shunt ladder](../simulation/results/ladder/README.md) | Shunt Ladder | 2 | 20 | 0 | 6 |
| [Signal chain](../simulation/results/signal_chain/README.md) | Signal Chain | 11 | 113 | 8 | 111 |
| [Range control logic](../simulation/results/range_logic/README.md) | Comparators, with Shunt Ladder, Signal Chain and the output switch in the loop | 12 | 143 | 6 | 122 |
| [Source meter](../simulation/results/source_meter/README.md) | Source Meter | 12 | 176 | 3 | 247 |
| [Output stage](../simulation/results/output_stage/README.md) | Output Stage | 6 | 151 | 6 | 142 |
| [Path switching](../simulation/results/path_switching/README.md) | Path Switching | 15 | 288 | 19 | 235 |
| [Power input and logic supplies](../simulation/results/power_input/README.md) | Power Input, Logic Supplies | 13 | 190 | 27 | 113 |
| [Analog rails and rail monitor](../simulation/results/analog_rails/README.md) | Analog Rails, Rail Monitor | 10 | 105 | 25 | 108 |
| [Digital lines and monitors](../simulation/results/digital/README.md) | Controller, Side Data, Digital Inputs, Monitors | 10 | 145 | 11 | 49 |
| [Whole measuring path](../simulation/results/system/README.md) | Shunt Ladder, Signal Chain and Comparators as one circuit | 2 | 25 | 0 | 3 |
| Circuits of the board | Ten blocks | 93 | 1356 | 105 | 1136 |
| [Models against their datasheets](../simulation/results/models/README.md) | | 41 | 478 | 17 | 70 |
| All | | 134 | 1834 | 122 | 1206 |

A figure that fails is kept as it is. The
[simulation guide](../simulation/README.md#reading-the-failures) says what
the 122 are, block by block, and gives every statement below with the
bench that shows it.

What the simulations reproduce of this draft, each value beside the one
that the specification states. It is a second calculation with models,
not a measurement:

| Circuit | Simulated | Specification |
| --- | --- | --- |
| Shunts seen by the amplifier | 1 kΩ, 31.95 Ω, 999 mΩ, 99.99 mΩ | 1 kΩ, 31.95 Ω, 0.999 Ω, 0.1 Ω |
| Burden of range 3 at 1 A, typical parts | 104.3 mV | 105 mV to 107 mV (calculated) |
| Gain of the chain and code at zero current | 19.93 and 1313 | 19.93 and about 1313 |
| Settling after a jump to range 3, to 0.1 % of the range and to one code | 45.37 µs and 65.22 µs | About 45 µs and 65 µs |
| Thresholds at the shunt: step up, over-current, jump | 90.95 mV, 115 mV, 151.2 mV | 91 mV, 115 mV, 151 mV |
| Jump threshold to range 3 conducting, nominal and worst delays | 360.8 ns and 480.3 ns | 0.35 µs and 0.51 µs; target 0.55 µs |
| Drop on a step from 1 µA to 500 mA with 1 µF, nominal and worst case (R-07) | 301.9 mV and 388.2 mV; 400.3 mV with the amplifier at half the bandwidth of its model, an assumption | 312 mV and 422 mV; limit 500 mV |
| The same with 10 µF | 168.3 mV and 179.2 mV; 180.8 mV with the amplifier at half its bandwidth | 169 mV and 186 mV; limit 250 mV |
| Output of the source at codes 616 and 3893, and its ceiling | 799.5 mV, 5 V, 5.259 V | 0.80 V, 5.00 V, 5.26 V |
| In-rush into 2200 µF when the output switch closes | 856.1 mA | 0.85 A |
| Drop at 1 A from the feeding point to the output terminal, with 20 mΩ of copper and contacts, ampere and source mode (R-06) | 155.7 mV and 141.7 mV | 158 mV and 144 mV; limit 200 mV |
| Over-voltage detector of VIN, trip and release | 5.465 V and 5.345 V | 5.46 V and 5.35 V |
| +13.5 V rail and −4 V_A at the tolerance limits | 13.02 V to 14.06 V; −3.913 V to −4.041 V | 13.0 V to 14.1 V; −3.91 V to −4.05 V |
| Current limits of the module input and of the USB-C input | 758.5 mA and 2.006 A | 0.76 A and 2.0 A |
| Resistance from the USB-C receptacle to the 5 V rail, typical and largest | 125.9 mΩ and 170.1 mΩ | 0.126 Ω and 0.170 Ω |

#### Decisions That Follow the Simulations

The simulations raised four points for a decision before boards are
ordered. The owner decided them on 2026-10-10, on the recommendation of
the simulations: decisions D-95 to D-98 of the specification. Three of
them are drawn since that day, D-95, D-97 and D-98, as changes of values,
part numbers, fitted flags and texts. Nothing else changed with them: the
wires of the schematic, and the tracks, vias, zones, pads and the position
of every footprint of the board, stayed as they were. The schematic and the
board in `kicad/`, the PDF, the pictures of the three sheets, the two
renderings and the bill of materials in `doc/`, and the netlist snapshot
of the simulations hold the three decisions. D-96 is not drawn: it needs
a footprint and copper.

What the drawn state rests on, as of 2026-10-13:

- The electrical rules check reports no message, and the design rules
  check with schematic parity reports 0 violations, 0 unconnected pads,
  0 footprint errors and 0 differences between board and schematic
  ([Checks](#checks)).
- `circuit-sim netlist --check` says that the netlist snapshot of the
  simulations matches the netlist of the schematic.
- The three decisions changed no copper. Copper changed three days later,
  in the round of 2026-10-13, which has nothing to do with them: eleven
  vias were moved and U16 got other lands. The figures of the 1 A path
  and of the leakage were calculated again after that round and are
  unchanged
  ([Review of Footprints and Placement](#review-of-footprints-and-placement-2026-10-13)).
- The simulations were not run again. The second column of the table
  gives the reasons for the decisions, from the run of 2026-10-10. The
  circuit of that run had 1 nF and no damper, as it was drawn then. Two
  cases in it anticipate the drawn state, because a bench set them on
  purpose: one crossing of a rail with 10 nF, and the data cable plugged
  again with the damper. Nothing else is simulated with the new parts:
  not the fast crossings and the edges of PWR_GOOD at power-up and at
  power-off with 10 nF, and no other bench of the power input with the
  damper, because those benches still leave R14 and C5 out. Bringing the
  benches in line with the snapshot and running the blocks that the
  changes touch is the first item of [Still to Do](#still-to-do).
- Nothing is built and nothing is measured. The owner opened the project
  in the KiCad editor on 2026-10-13 and found it coherent; nobody has
  reviewed the board there item by item.

| Decision | What the simulation shows | What changes here | State |
| --- | --- | --- | --- |
| D-95: the capacitors C32 to C34 of the rail monitor are 10 nF, not 1 nF (changes the value of D-54) | With 1 nF, the value drawn until this decision, and a comparator at its least hysteresis of 1 mV, an edge of PWR_GOOD moves its own threshold and a rail that crosses at 20 V/s or 400 V/s gives a burst of edges. With 10 nF and 1 pF the threshold moves by 525 µV, where 1 nF gives 3.149 mV to 3.606 mV; the one run made with 10 nF, at 2 V/s, shows one edge. The capacitance between the pins of the package, 0.5 pF to 1 pF, is an assumption | A value and a part number on three capacitors: the schematic, the board, the bill of materials, no copper | Drawn on 2026-10-10: C32, C33 and C34 are `10n 50V C0G`, Murata GRM1885C1H103JA01D, on their 0603 pads, and the note of the Rail Monitor sheet states 10 nF with the time constants of about 0.09 ms, 0.25 ms and 0.36 ms (calculated). Not simulated again: the crossings at 20 V/s and at 400 V/s and the edges of PWR_GOOD at power-up and at power-off have no run with 10 nF |
| D-96: a position for a capacitor from the non-inverting input of the buffer of the driver rail, U28, to ground; its value is chosen on the bench, and the position may stay empty | 41.92° of phase margin as drawn, not the 54° that the specification stated, because R126 (10 kΩ) works against the input capacitance of the amplifier. The loop is stable and a load step does not ring. The model of the manufacturer gives 68.99°, with input capacitances that are not those of its datasheet. No run with the capacitor exists | One position more on the Signal Chain sheet and one footprint more on the board, so the board changes | Not drawn: it needs a footprint and copper, and with them a new run of the checks and of the board figures |
| D-97: the position U9 at the boost converter stays without a part, and the 803 type with its time-out of 0.24 s is no longer the part meant for it; a remedy, if the test of phase 1 asks for one, is a detector with a time-out of milliseconds (changes D-84) | As drawn the boost converter starts in one go from an input limited to 0.67 A to 0.85 A. With a detector of 0.24 s the start would be stopped and, with 1 mA of load, repeated four times in the 1.1 s of the run without completing; with 0.1 mA the second attempt completes it. The result rests on a model of the converter below 2.7 V, where its datasheet says nothing, on a source with a flat current limit and on the assumed load | No copper. The text of the position, in the schematic and in the value of its footprint on the board | Drawn on 2026-10-10: the position reads "Detector, ms time-out" in the schematic and on the board, where it read "803 type, 3.08 V", and the note of the Analog Rails sheet follows. U9 stays without a part |
| D-98: the damper R14 (0.33 Ω) with C5 (10 µF) on the module input is fitted (changes D-84) | When the data cable is plugged again on a port at 5.5 V behind a short cable while USB-C supplies the rail, input 2 of the multiplexer U5 reaches 5.941 V with a limiter of typical reaction and 6.002 V with one assumed to react in 15 µs, against a rating of 6.0 V. With the damper fitted, its capacitor at half its value, the peak is 5.502 V in the runs made, after gaps of 2 ms to 2.6 ms; the damped input falls far less in those gaps, and the longer gap that matches was not run. The recharge pulse at a change of input was not simulated with the damper fitted; without it that pulse is 4.103 A through U5, against a pulse rating of 4 A | Two parts with their part numbers in the schematic, on the board and in the bill of materials, on pads that exist | Drawn on 2026-10-10: R14 is `0.33R 1%`, Panasonic ERJ-6RQFR33V, and C5 is `10u 25V X5R`, Samsung CL21A106KAYNNNE, both on pads of size 0805 and no longer marked "do not populate"; both are in the bill of materials, and the note of the Power Input sheet follows. Not simulated again: the benches of the power input still leave the two parts out |

#### Where the Text Differs, and What Stays for the Bench

In fourteen places the simulation and the text of the specification
differed: the time for which the over-current comparator stays high, the
ladder clamp in a short circuit, the capacitor advised at the VIN
terminals, the times at power-off, the opening time of the output switch
at 0.8 V, and others. They are listed, with their figures and their
state, in the
[simulation guide](../simulation/README.md#where-the-simulation-and-the-text-differed).
Twelve are corrected in the specification since 2026-10-10, three of them
by decisions: the trip counts its time in range 3 only (D-99), the advice
on a capacitor at the VIN terminals is limited to what was simulated
(D-100), and the range of a logic input is 0 V to 5.5 V (D-101). None of
the corrections changes a part. The times at power-off and the figures of
the power input wait for the run of the benches on the drawn decisions,
and seven questions are open in section 16 of the specification. The
fourteen are not every difference: the guide also names the figures that
fail against a rating of a datasheet, most of them in a fault case.

Some questions about this hardware stay for the bench, whatever the
simulations say:

- The linear range of the amplifier U27 near the −4 V rail with the output
  below 0.2 V: two readings of its datasheet end it at 130 mV or at
  214 mV across the shunt. It is an open check of section 16.
- The loop of the pre-regulator U16 at its low end, and the linear
  regulator U18 at light load with 22 µF: the models extrapolate there.
- A supply that reverses or jumps to 20 V while the ampere pair is closed:
  a transistor of the pair then has to block 34.44 V to 65.74 V against a
  rating of 30 V. Whether a part survives is a pulse test.
- The clamp levels of the rail diodes D8 and D9, 296.4 mV and −292.8 mV
  with the largest forward voltage of the datasheet, and 394.2 mV and
  −391.4 mV at −40 °C, against pin ratings of 0.3 V.
- Leakage at the nanoampere level, the multiplexer U24 at +12 V and −4 V,
  the programs of the controller, coupling through the copper and
  temperature. No model here gives a figure for any of them.

### Review of Footprints and Placement (2026-10-13)

Two things happened to the drawings on 2026-10-13.

The owner opened the project in the KiCad editor, the schematic and the
board, and found both coherent. It was the first time a person looked at
the drawings there. It was a look and not a review: nothing was recorded
item by item, and no edit was saved. When the schematic editor opened,
KiCad wrote its default settings into the project file
([KiCad Project](#kicad-project)).

And the footprints and the placement were reviewed, on a copy of the
project. The review had three sources: measurements by scripts from the
board file, 3D renderings of every region of the board, read one by one,
and the datasheets and drawings of the makers. It led to five findings.
The owner asked for all five to be worked into the board, at those points
only and with no new routing, and for the frames and names of the
functional blocks on the silkscreen. Both were done the same day.

What the review is and is not:

- It is a comparison of the drawings with their libraries and with the
  documents of the makers, and a set of distances calculated from the
  board file. The level of evidence is a comparison or a calculation.
- It is not a review in the KiCad editor, and nothing was measured on a
  built board: no board exists.
- It is not a component check. No record is filed in
  [`docs/checks/`](../docs/checks/README.md), and every part is still a
  candidate.
- Five parts have no 3D model in the KiCad 10 installation that was used:
  U3, U4, L2, the frame SH1 of the shield can and the terminal block J4.
  The renderings do not show their bodies, so these five were judged by
  numbers.
- The scripts of the review and of the round are not in this repository.
  The board file is the record of what was drawn.

#### What Was Compared

Footprints and symbols:

- At the review all 425 footprints of the board equaled the footprint of
  the same name in their library, pad by pad: 423 from the library that
  KiCad 10 installs and the two project footprints of that day. Since the
  round U16 stands on a third project footprint, so the board has 422
  footprints of the KiCad library and three of the project.
- Of the 59 symbols that the parts of the schematic use, power symbols
  not counted, 55 are symbols of the KiCad library with unchanged pins.
- The other four are the symbols of the project library. Each agrees pin
  by pin with the datasheet of Texas Instruments: `ADS8860xDGS` with
  SBAS569B, `MUX509xPW` with SBAS758C, `TPS2116DRL` with SLVSFG1A and
  `TPS63020DSJ` with SLVS916I.
- Three part types are drawn with a symbol of the KiCad library that is
  not their own, and each symbol agrees with the datasheet of the part
  that is fitted. The ESD arrays TPD4E1U06DBVR use the symbol `SRV05-4`
  (SLVSBQ9D): pin 5 is "NC" on the part and is left open. The current
  limiters TPS259621DDAR use the symbol `TPS2596xx` (SLVSET8A): pin 8 is
  OVCSEL and has 402 kΩ to ground. The diode pairs BAV199 use the symbol
  of a series double diode: its pinning was read in the datasheet of
  Nexperia, while the bill of materials names the part of Diodes
  Incorporated.
- The symbol of the transistors CSD17577Q3A of the 1 A path agrees with
  the top view of the datasheet: pins 1 to 3 source, pin 4 gate, pins 5
  to 8 drain.
- The standard packages (SOIC, SOT-23, TSSOP, MSOP and the chip sizes)
  were compared by the package code in the part number, not in each
  datasheet.

Parts against the drawings and datasheets of their makers. Each agrees
with its footprint; one point is open, at the frame of the shield can:

| Part, with the document that was read | What was found |
| --- | --- |
| J4, lever terminal block WAGO 2601-1104; datasheet, version of 29.04.2026 | The hole pattern: a pitch of 3.5 mm, two rows 5 mm apart, holes of 1.2 mm. The housing is 14.5 mm × 15.5 mm, and the conductors enter from the side of the board edge. The tips of the levers overhang the edge by 0.6 mm at a height of 12 mm |
| J2, USB-C receptacle GCT USB4125; drawing, revision A6 | The mouth of the receptacle is flush with the board edge. The suffix 0190 of the part number means shell stakes of 1.90 mm, which is right for a board of 1.6 mm |
| MP1 and MP2, socket strips Würth 61302011821 | 8.5 mm high. The recommended hole is 1.02 mm; the board has holes of 1.0 mm. With the body of the pin headers of the module, 2.5 mm, the module stands 11 mm above the carrier |
| C11, capacitor Würth 865060343004 | 6.3 mm × 5.5 mm |
| Resistor arrays Bourns CAY16-J4 | 3.2 mm × 1.6 mm, with a pitch of 0.8 mm |
| R110, shunt Ohmite LVK12 | The land pattern of the maker (1.75 mm, 1.10 mm, 1.00 mm and 0.30 mm) equals the footprint. Both current terminals are on one long side and both sense terminals on the other, as the symbol and the footprint have it |
| SH1, frame of the shield can Laird BMIS-210; item page of 2009, a copy at a distributor | 44.02 mm × 30.50 mm × 3.00 mm, from sheet of 0.20 mm. No drawing was found that shows the lower edge of the frame |

Placement, calculated from the board file:

- Every part is on the top side, and no courtyard overlaps another.
- No pads of two different parts are closer than 0.45 mm, and the
  smallest gap between the bodies of two fitted parts is 0.62 mm.
- No part stands under the module, and no part but the connectors stands
  within 2 mm of the board edge.
- 58 parts stand inside the shield can and none across its wall. The
  tallest is 1.75 mm high, under a frame of 3.0 mm.
- Bare guard copper keeps 0.30 mm from the lands of the frame and 0.80 mm
  from its wall line: decision D-90 holds.
- The pin names that are printed at J3, J4 and J5 agree with the nets of
  their pins.

Assembly, counted from the board file. 364 footprints are surface-mount
placements: 361 parts and the three fiducials; the position U9, which
carries no part, is not counted. Six footprints are through-hole: J1, J3,
J4, J5, the reset button SW1 and the module footprint U1, whose holes
take the two socket strips. Eleven parts have no visible leads or have
terminations under the body, and need reflow or hot air: Q4, Q5, Q8, Q9,
Q14, Q15, Q16, U5, U11, U16 and U18. The frame of the can goes on last.

#### Findings and What Was Done

1. **Land pattern of the pre-regulator U16.** The TPS63020DSJR stood on a
   footprint of the KiCad library that is drawn for another package, the
   DE14 package of Linear Technology: a thermal land of 1.70 mm × 3.30 mm
   and lands of 0.70 mm × 0.25 mm at ±1.45 mm. It now has the land
   pattern of its own package, the DSJ package of Texas Instruments
   (R-PVSON-N14), from the drawings 4208212-3/C, 4208549-3/G and
   4210895-2/E in the datasheet SLVS916I: a thermal land of
   1.58 mm × 2.85 mm, fourteen lands of 0.60 mm × 0.24 mm at ±1.40 mm, and
   eight paste openings of 0.60 mm × 0.50 mm, which cover 53 % of the
   thermal land. The six vias under the part are all inside the smaller
   land. It is a new project footprint,
   `PowerProfiler:Texas_R-PVSON-N14_3x4mm_P0.5mm_EP1.58x2.85mm`
   ([Libraries](#libraries)). The Source Meter sheet, the symbol
   `TPS63020DSJ` of the project library, the board and one line of the
   bill of materials name it. Not drawn: the finger lands that the
   drawing of Texas Instruments shows at the two short ends of the
   package.
2. **Reference texts on the silkscreen.** 302 texts were visible and 123
   hidden. Visible texts stood at another part of the same package (D10
   at U39, D19 at Q7, D18 at Q3) or far from their own part (U21 and D17
   by 7 mm, U16 and U18 by 5 mm). Now 330 are visible and 95 hidden: 61
   texts were moved to their own part, 31 hidden ones are shown again and
   three were hidden. One of the three is D17: its text stood 7 mm away,
   at TP32, and no place beside D17 is free. A text stands only where its
   own part is the nearest part it could be taken for. The 95 hidden
   texts are those of 52 resistors, 36 capacitors, four test points (TP7,
   TP17, TP36 and TP44) and three diodes (D6, D11 and D17). Every hidden
   reference is on the fabrication layer, which the
   [placement picture](doc/images/board-placement.png) shows.
3. **Console header J1.** It had no pin names, and the text "USB
   DATA/POWER" stood beside it. Now its pins read TX, RX and GND: pin 1
   is GP0, the transmit line of UART0, pin 2 is GP1, its receive line,
   and pin 3 is ground. The text reads "PICO USB" over "DATA/POWER".
4. **Via holes at pads.** Solder can drain into a via hole that reaches a
   pad. Five vias had the edge of their hole inside a pad (pad 1 of R84,
   pin 1 of U14, pin 6 of U27, pad 2 of D7 and pad 2 of C78), and four
   more stood within 0.05 mm of one (pad 1 of Q2, of R53, of R48 and of
   R49). These nine vias were moved by 0.2 mm to 1.6 mm, each with a
   short piece of track on the layers that it joins; their holes now
   stand 0.25 mm or more from the pad. Two were left as they were,
   because no free place exists beside them: at pin 6 of U12 the edge of
   the hole is at the edge of the pad, and at pad 1 of R67 it is 0.02 mm
   away. Five more stand 0.07 mm to 0.10 mm from a pad (pad 1 of C34, pad
   2 of C72, pin 1 of Q8, pad 2 of R118 and pin 1 of U21) and were not
   part of the round.
5. **Vias under the wall of the shield can.** Two tented vias stood under
   the wall line of the can: one of `+3V3_A` at the left wall and one of
   `AMP_RAW` at the top wall. Both were moved inside, the first to
   0.66 mm and the second to 0.80 mm from the wall line. Only the two
   ground vias in the corner lands of the frame are under the wall now.
   Tracks of thirteen nets cross under the wall on the top layer, between
   the lands and under solder mask, as before.

No part was added, removed or moved in the round, and no connection of
the schematic changed. Nothing was routed again either. The 3,716 track
segments that the board had before the round are all there unchanged. 27
short pieces of track were added at the eleven moved vias, 15.9 mm in
all: 15 pieces on the top layer, 5 on the second inner layer and 7 on the
bottom layer. The other 683 vias stand where they stood, and the outline
of every copper zone is the same.

#### Block Frames on the Silkscreen

The owner asked for the blocks on the board with their names, as the
placement picture shows them. The silkscreen now carries the frames and
the names of the sixteen placement blocks: Controller, Monitors, Side
data, Logic inputs, Reference, Comparators, Power input, Pre-regulator,
Analog rails, Source meter, Front end, Gate drivers, 1 A branch, Output
switch, Mode switches and VIN entry.

- The lines are 0.15 mm wide. A line is cut wherever a pad, an opening of
  the solder mask, a part or a text is in the way, so between 53 % and
  93 % of each frame is drawn, in 141 straight pieces in all.
- The names are 1.2 mm high, and 1.0 mm where 1.2 mm did not fit, which
  is the case for five of them. Three stand upright: Source meter, 1 A
  branch and VIN entry.
- Until that day the same frames and names were on the documentation
  layer of the board, `User.Drawings`. They were removed there: the
  silkscreen is the one place now.

The rendered [top view](doc/images/board-top.jpg) shows the frames as
they would be printed.

#### Figures After the Round

All figures are counted or calculated from the board file. Nothing is
measured.

| Figure | Before the round | After the round |
| --- | --- | --- |
| Connections | 984 of 984 | 984 of 984 |
| Tracks | 8.38 m in 3,716 segments | 8.40 m in 3,743 segments |
| Tracks on the top layer | 3.76 m | 3.77 m |
| Tracks on the second inner layer | 2.84 m | 2.84 m |
| Tracks on the bottom layer | 1.79 m | 1.79 m |
| Vias | 694 | 694, of which eleven stand at another place |
| 1 A path, source mode | 19.5 squares | 19.5 squares |
| 1 A path, ampere mode | 23.3 squares | 23.3 squares |
| Surface leakage into the measured node | 5.1 nA | 5.1 nA: 4.46 nA on the top layer, of which 0.73 nA inside the can, and 0.67 nA on the bottom layer |
| Ground fill of the bottom layer | 12,108 mm² | 12,106 mm² |
| Pour of the 5 V rail | 1,623 mm² | 1,622 mm² |
| Reference texts on the silkscreen | 302 visible, 123 hidden | 330 visible, 95 hidden |
| Project footprints on the board | 2 | 3 |

The ground plane and the ground fill of the second inner layer have the
area that they had, 14,205 mm² and 10,891 mm². The report of the package
in [`tools/board/`](../tools/board/README.md) prints the same figures on
the board after the round as before it
([Reproducing the Figures](#reproducing-the-figures)). The other figures
of the layout review in this guide are those of 2026-10-10.

#### Checks After the Round

Run on 2026-10-13 on the files of this directory
([Checks](#checks)):

- Electrical rules check: no message.
- Design rules check with schematic parity: 0 violations, 0 unconnected
  pads, 0 footprint errors.
- `circuit-sim netlist --check`: the netlist snapshot of the simulations
  still matches the schematic. The simulations were not run again: the
  circuit did not change.
- The bill of materials was exported again. One line changed, the
  footprint of U16.
- The six pictures of the board in [`doc/`](doc/README.md) were plotted
  again from the final board file: the two renderings, the copper layers,
  the front end, the 1 A path and the placement.
- The schematic PDF was exported again. Its fifteen pages are the same as
  before: the one field that changed is hidden on its sheet.
- The Hardware workflow was not started.

#### Still Open After the Round

- A review of the board item by item in the KiCad editor. The look of
  2026-10-13 is not that review. It is a condition of revision A; the
  proof-of-concept boards of draft A2 may be ordered without it (D-105).
- 95 reference texts are hidden on the silkscreen, among them those of
  the diodes D6, D11 and D17.
- Two vias still stand at a pad: at pin 6 of U12 and at pad 1 of R67.
- The lower edge of the frame of the shield can is not confirmed in a
  drawing of the maker.
- The finger lands of U16 are not drawn.

Everything else that was open before the round is open as it was, because
the round did not touch it:

- The [open items](#open-items) that need parts moved: the capacitor
  loops of the converters, the temperature sensor U39, the suppressor
  D21, the ladder clamps and the others.
- The probe grounds at the test points, the net names of the test points,
  the functions of the jumpers and the frame for the serial number
  ([Not Touched by the Review](#not-touched-by-the-review)).
- The thermal check of decision D-93.
- Decision D-96, which is not drawn, and the benches, which were not run
  on the drawn decisions D-95 and D-98
  ([Still to Do](#still-to-do)).

### Fabrication Outputs of Draft A2

On 2026-10-13, after the round above, the owner asked for the Gerber
files, the bill of materials and the rest that is needed to send the
board to fabrication at JLCPCB. The outputs were exported the same day
from the board file of this directory, with `kicad-cli` of KiCad 10.0.0,
into [`fabrication/draft-a2/`](fabrication/draft-a2/README.md). They are
the first content of `fabrication/`.

This is decision D-105 of the specification. The fabrication outputs of
draft A2 are filed for an order of proof-of-concept boards while the
items that section 16 lists under "Before the board is ordered" are still
open. Boards made from these files are draft A2, as their silkscreen says
("rev A2 draft"), and not revision A. The open items were named to the
owner before the request; none of them is closed by it, and they remain
conditions of revision A. That is why the folder is `draft-a2/`, beside
the `rev-a/` that revision A will get.

What the repository records: the outputs are filed. It records no order.
No board has been ordered or made as far as the repository shows.

| File in `fabrication/draft-a2/` | Content |
| --- | --- |
| `open-power-profiler-carrier-a2-gerbers.zip` | The eleven Gerber files and the two drill files in one archive, ready to upload |
| `gerbers/` | The same thirteen files one by one. The eleven Gerber files of the four-layer board are the four copper layers, the two solder masks, the two paste layers, the two silkscreens and the outline. Beside them, for reference: the drill maps, the drill report and the job file |
| `jlcpcb-bom.csv` and `jlcpcb-cpl.csv` | The parts for machine assembly and their positions and rotations, in the column layout of JLCPCB: the 360 surface-mount placements of the top side in 142 lines |
| `README.md` | The order data of the bare board, what the two assembly files hold and lack, how the files were made, and the checks |

The board has four copper layers; eleven is the number of Gerber files.
The bottom paste layer is empty, and the bottom silkscreen has no print:
every part is on the top side.

What the assembly files hold. The 360 placements are the 361
surface-mount parts of the board without the frame SH1 of the shield can;
the three fiducials are not in the files. Fitted by hand, and not in the
files: the two socket strips at U1, the pin headers J1, J3 and J5, the
terminal block J4, the reset button SW1, and the frame SH1 with its
cover, which goes on last. The position U9 stays empty (D-97). The full
bill of materials, with the parts fitted by hand, is
[`doc/bom.csv`](doc/bom.csv).

Checked on the outputs on 2026-10-13:

- The drill file holds 787 plated holes, which are the 694 vias and the
  93 holes of pads of the board, and no unplated hole.
- Every layer, the drill file and the placement file lie in one
  coordinate frame.
- The electrical rules check and the design rules check with schematic
  parity report nothing on the files that the outputs were made from
  ([Checks](#checks)).

Not done:

- No Gerber viewer has read the files back, and the positions and
  rotations were not laid over the copper in a viewer.
- No manufacturer has reviewed the files.
- The column of LCSC part numbers in the assembly bill of materials is
  empty. The project knows manufacturer part numbers only, and whether
  the assembler stocks a part was not checked.
- The rotations are those of KiCad. They were not converted to the zero
  from which the assembler counts.

The smallest features of the board against the limits of the
manufacturer. The values are taken from the board file, and the limits
from the capabilities page of JLCPCB as it was read on 2026-10-13; the
manufacturer's own check of the files stays the judge:

| Item | Board | Limit |
| --- | --- | --- |
| Smallest track | 0.15 mm | 0.09 mm |
| Smallest clearance | 0.127 mm between pads, 0.15 mm elsewhere | 0.09 mm |
| Smallest via | 0.6 mm with a hole of 0.3 mm, a ring of 0.15 mm | 0.25 mm with a hole of 0.15 mm |
| Slots | Four of 0.6 mm × 1.2 mm | 0.35 mm |
| Silkscreen | Lines of 0.15 mm, text 1.0 mm high | Both at the limit |

What the order still needs from the owner; the
[README of the folder](fabrication/draft-a2/README.md) has the detail:

- The surface finish ENIG in the order form. The guard copper around the
  measured node is bare by design, and a tin finish would leave it with
  an uneven surface.
- A word on the order number that the manufacturer prints on the
  silkscreen: where to put it, or to leave it out. No place is reserved
  for it.
- The rotation of every part with a polarity, checked in the preview of
  the assembler before the order is confirmed.
- The parts matched by their manufacturer part numbers, because the files
  carry no part numbers of the assembler.
- Five thermal pads hold open vias (U11, U16, U18, Q5 and Q8): they are
  covered vias, not filled ones, and part of the solder under these parts
  can drain into them.

The outputs are those of the board file as it stood on 2026-10-13. After
any change of the board they are exported again; the commands are in the
README of the folder.

### Connectors

Someone who faces the front edge reads the pins from left to right in the
order of the Nordic PPK2 (Figure 4 of its user guide, v1.0.1).

| Connector | Type | Pins |
| --- | --- | --- |
| DUT, pin header | 1×4, 2.54 mm, straight | GND, VIN, VOUT, GND |
| DUT, terminal block | Lever-operated, 3.5 mm (candidate: WAGO 2601-1104) | GND, VIN, VOUT, GND |
| Logic port | 1×10, 2.54 mm, straight | VCC, GND, D7 down to D0 |

The carrier also has the USB-C power connector at the back edge (power
only) and a 3-pin console header, J1 (TX, RX and GND at 3.3 V). The
silkscreen names its three pins since 2026-10-13.

The two DUT connectors carry the same nets. VOUT delivers 0.8 V to 5.0 V in
source mode. VIN is the external supply of ampere mode: 0.8 V to 5.0 V in
use, and −20 V to +20 V withstood while the ampere switch is open
(simulated; decision D-60). The VCC pin of the logic port is used only when
the solder jumper beside the level translator (JP2) is moved: as built,
the logic inputs follow the output voltage of the instrument, and they are
valid for logic levels of 1.65 V to 5.5 V (R-10). The limits of every
terminal are in section 4.9 of the specification.

### Libraries

| Library | Item | Description |
| --- | --- | --- |
| `PowerProfiler` | Symbol `ADS8860xDGS` | 16-bit converter, from the datasheet SBAS569B |
| `PowerProfiler` | Symbol `MUX509xPW` | Dual 4:1 multiplexer, from the datasheet SBAS758C |
| `PowerProfiler` | Symbol `TPS63020DSJ` | Buck-boost converter, from the datasheet SLVS916I; since 2026-10-13 it names the project footprint of its package |
| `PowerProfiler` | Symbol `TPS2116DRL` | Priority power multiplexer, with the pin numbers of the KiCad symbol `Power_Management:TPS2116DRL`; its second output pin is passive |
| `PowerProfiler` | Footprint `TerminalBlock_WAGO_2601-1104_1x04_P3.50mm_Horizontal_Pad1.9mm` | Lever terminal block: the library footprint with pads of 1.9 mm × 2.3 mm |
| `PowerProfiler` | Footprint `RaspberryPi_Pico_Common_THT_NoKeepout` | Controller module: the library footprint without its antenna keep-out |
| `PowerProfiler` | Footprint `Texas_R-PVSON-N14_3x4mm_P0.5mm_EP1.58x2.85mm` | Pre-regulator U16, since 2026-10-13: the land pattern of the DSJ package of Texas Instruments (R-PVSON-N14), from the drawings 4208212-3/C, 4208549-3/G and 4210895-2/E in the datasheet SLVS916I. The finger lands at the two short ends of the package are not drawn |
| `PowerRails` | Power symbols | One symbol per supply rail of the table above, and the ground symbol |

The symbols are in `kicad/lib/PowerProfiler.kicad_sym` and
`kicad/lib/PowerRails.kicad_sym`, the three footprints in
`kicad/lib/PowerProfiler.pretty`: the terminal block and the module by
decision D-85, the land pattern of U16 since the round of 2026-10-13
([finding 1](#findings-and-what-was-done)). Every other symbol and
footprint, the symbol of the Pico 2 among them, comes from the library that
KiCad 10 installs. On 2026-10-13 the footprints of the board and the
symbols of the schematic were compared with these libraries
([What Was Compared](#what-was-compared)).

### Controller Module

The carrier takes a Raspberry Pi Pico 2 with its pin headers fitted, on two
1×20 pin sockets 17.78 mm apart (MP1, MP2). The sockets are soldered
into the holes of the module footprint (U1) and the module is plugged
into them; an RP2350 of stepping A3 or A4 is preferred (decision D-82). A
Pico 2 W fits the same sockets, but the firmware does not support it. The
pin map is in section 5 of the specification; every GPIO of the headers is
in use.

- Either USB connector powers the whole instrument, and USB-C is used
  whenever it is present. Each input has its own current limiter, and
  neither connector is fed back from the other. Cut the solder jumper on
  the Controller sheet (JP1) to keep the carrier off the USB port of the
  computer.
- With the data cable alone the instrument stays inside what a default USB
  port offers: the input current allowed is 0.45 A, about 1.5 W at the
  output (estimate). The whole current curve of R-08 needs a USB-C source
  that offers 1.5 A or more (section 4.1 of the specification, decision
  D-49).
- Every line that the module drives, except the console output, has a
  resistor to a rail on the carrier, and series resistors limit what a pin
  can push into an input whose supply is absent. With the module in reset,
  in its boot loader or out of its sockets every switch is open and the
  pre-regulator is off (section 5).
- Firmware is loaded through the USB connector of the Pico 2: hold its
  BOOTSEL button and press the reset button of the carrier.

### Checks

Run them from `kicad/`. The Hardware workflow runs the same commands when it
is started, by hand only (decision D-22). It fails on any error of the
electrical rules check, on any rule violation of the board (warnings
count), on any footprint error and, since the layout review, on any
unconnected pad. The results below are from local runs.

```sh
kicad-cli sch erc --severity-all power-profiler-carrier.kicad_sch
kicad-cli pcb drc --schematic-parity --severity-all power-profiler-carrier.kicad_pcb
```

Results on the files of this draft, with KiCad 10.0.0 on 2026-10-13, after
the round that followed the review of footprints and placement. The runs
of 2026-10-10 on the reviewed board and of 2026-10-12 after the three
drawn decisions gave the same four results:

| Check | Result |
| --- | --- |
| Electrical rules check | 0 errors, 0 warnings |
| Design rules check, rule violations | 0 |
| Design rules check, footprint errors (difference between board and schematic) | 0 |
| Design rules check, unconnected pads | 0 |

The design rules check compares the board with its rules and with the
schematic. Before a board is ordered it must report no rule violation, no
difference between board and schematic and no unconnected pad. It reports
that now, against the rule file that the layout review rewrote
([Design Rules Check](#design-rules-check) says what the file asks and
which five checks the project ignores). On the autorouted board the same
check listed 28 unconnected items. The six footprints whose fields
changed with the three drawn decisions agree with their symbols, and so
does U16 on its new footprint: the check reports no difference between
board and schematic.

Two more results of 2026-10-13, on the same files. The command
`circuit-sim netlist --check` says that the netlist snapshot of the
simulations still matches the schematic. And the bill of materials,
exported again, differs from the one before in one line, the footprint of
U16. The Hardware workflow was not started.

Three corrections stood behind the result of the autorouted board. The
autorouter had left five pairs of vias
0.493 mm to 0.499 mm apart; each pair was moved apart by less than 0.01 mm.
The pattern that binds one net to its net class was corrected. And the
stackup of the board file was set to the build of section 10.1 of the
specification.

Both checks were run with `kicad-cli`. The owner opened the project in the
KiCad editor on 2026-10-13, looked at the schematic and the board and
saved no edit. The checks above ran on the files as they are since that
day, the project file with the settings that KiCad wrote into it among
them. The checks say that the files are consistent and
that the copper keeps the rules of the rule file. They do not say that the
layout is good: a rule file holds spacings, not the length of a converter
loop, the squares of a pour or the leakage into a node. Those were
calculated in the [layout review](#layout-review), and what that review
left open is listed there.

### Still to Do

This is the hardware part of the next steps that the
[README](../README.md#project-status) of the repository puts in order:
first what is left of the decisions that follow the simulations (item 1
here), then the decisions of the owner that are still open and the order
of proof-of-concept boards, which is decided (item 2), then
the board (items 3 and 4), then the software, which the
[firmware guide](../firmware/README.md) and the
[host guide](../host/README.md) list. The checks that need parts or a
bench (item 5) and the work that waits for firmware (item 6) belong to the
phases that follow.

Eight steps of the earlier lists are done. The 28 connections that the
autorouter had left open were closed in the layout review of 2026-10-10;
this guide no longer carries their list and their map. The seven
deviations of the reviewed board are decided
([D-87 to D-93](#decisions-of-the-layout-review-d-87-to-d-93)). The
scripts that calculate the figures of the board are filed in
[`tools/board/`](../tools/board/README.md). The simulations of the
circuits are filed in [`../simulation/`](../simulation/README.md), made
again from the netlist of the schematic as it stood on 2026-10-10; this
guide no longer carries the list of what had to be filed. The four points
that the simulations raised are decided
([D-95 to D-98](#decisions-that-follow-the-simulations)). Three of
those four decisions are drawn, D-95, D-97 and D-98. And on 2026-10-13
the footprints and the placement were reviewed, and the five findings of
that review were worked into the board
([Review of Footprints and Placement](#review-of-footprints-and-placement-2026-10-13)).
That review is not the review of item 3: it was not made in the KiCad
editor. Last, the question whether proof-of-concept boards are ordered on
this state is decided (D-105), and the fabrication outputs of draft A2
are filed
([Fabrication Outputs of Draft A2](#fabrication-outputs-of-draft-a2)).
The order itself is the owner's and is not recorded here.

#### 1. Finish the Decisions That Follow the Simulations

Three of the four decisions are drawn since 2026-10-10. Done, in the
files of `kicad/` and `doc/`:

- D-95, Rail Monitor sheet: C32, C33 and C34 are 10 nF, with the part
  number of the new value in their fields. The pads stayed: the board
  changed only in the fields of three footprints.
- D-98, Power Input sheet: R14 (0.33 Ω) and C5 (10 µF) are no longer
  marked "do not populate" and carry their part numbers. Their pads were
  on the board.
- D-97, Analog Rails sheet: U9 stays without a part, and its value reads
  "Detector, ms time-out" where it read "803 type, 3.08 V". A part is
  named only if the test of phase 1 asks for a remedy.
- The notes of the three sheets; the electrical rules check and the
  design rules check with schematic parity, which report nothing; the
  bill of materials, the PDF, the pictures of the three sheets and the
  two renderings of `doc/`, exported again.
- The netlist snapshot of the simulations, written again from the
  changed schematic.

Open:

- D-96, Signal Chain sheet: a position for a capacitor from the
  non-inverting input of U28, the node of R126, to ground, and its
  footprint on the board. It is the one change of copper: the board has
  425 footprints, and this is one more. The position may stay without a
  part; its value is chosen on the bench. After it come both checks, the
  bill of materials, the PDF and the pictures of `doc/` exported again,
  the snapshot written again, and the figures of the layout that the new
  footprint touches
  ([Reproducing the Figures](#reproducing-the-figures)).
- The simulations of the three drawn decisions. The benches were not run
  again: their results still describe the circuit before the changes.
  First the benches have to be brought in line with the new snapshot:
  the bench of the rail monitor names its cases by the value that was
  drawn before, and the benches of the power input leave R14 and C5 out.
  Then the blocks that the changes touch have to be run again, the rail
  monitor with the power-up and the power-off and the input from the
  module. The
  [simulation guide](../simulation/README.md#when-the-schematic-changes)
  says which benches hold the changed parts.

#### 2. Decide What Is Still Open

- Seven questions that the corrections of the specification leave are
  the owner's: section 16 of the specification gives each with its
  options and one recommendation. Two concern this hardware: the divider
  of the 5 V monitor channel, which is at full scale from about 5.44 V of
  the rail with its resistors at their limits (recommended: one resistor
  changed with the next change of the schematic), and a withstand
  voltage of the logic inputs beyond 0 V to 5.5 V (recommended: none for
  revision A).
- Decided on 2026-10-13: proof-of-concept boards of draft A2 may be
  ordered on this state (D-105). The fabrication outputs are filed, and
  the order is the owner's. What it still needs from the owner: the
  surface finish ENIG in the order form, a word on the mark of the order
  number, the rotations checked in the preview of the assembler, and the
  parts matched by their manufacturer part numbers
  ([Fabrication Outputs of Draft A2](#fabrication-outputs-of-draft-a2)).
  No order is recorded. Items 3 to 5 stand as they are: the decision
  closes none of them, and they remain conditions of revision A.

#### 3. Review the Board in KiCad

- Done on 2026-10-13: the owner opened the project in the KiCad editor and
  found the schematic and the board coherent. That was a look. Nothing
  was recorded item by item, and no edit was saved.
- Open: a person reviews the board in the KiCad editor item by item. It
  is a condition of revision A; the proof-of-concept boards of draft A2
  may be ordered without it (D-105). Every check so far ran from the
  command line, and every figure comes from a script.
- That review reads the placement and the copper against the rules of
  section 10 of the specification, and compares a 1:1 print with the
  module on its sockets, the USB-C connector, the terminal block, the frame
  of the can and one of the 1 A transistors (section 10.8). The review of
  2026-10-13 compared the terminal block, the USB-C receptacle, the
  socket strips and the frame of the can with the documents of their
  makers, by numbers
  ([What Was Compared](#what-was-compared)); the print against the parts
  in hand is not done.

#### 4. Close the Open Items and Finish the Silkscreen

- The [open items](#open-items) that the owner wants closed are placement
  changes with a local redraw: the capacitors of the three converters and
  the inductor of the pre-regulator, the temperature sensor, the suppressor
  of VOUT, the ladder clamps, the drain pad of the ampere pair, the star of
  the reference, the via groups over the ground plane, the vias at pasted
  pads. Of those vias nine were moved on 2026-10-13; two still stand at a
  pad, at pin 6 of U12 and at pad 1 of R67.
- The points that the layout review
  [did not touch](#not-touched-by-the-review): probe grounds at the test
  points, the net names of the test points and the functions of the
  jumpers on the silkscreen, a frame for the serial number, one opening
  for the acquisition lines, the resistor pairs of the set-point path.
- The silkscreen after the round of 2026-10-13. Done: the frames and
  names of the functional blocks, the pin names of J1, and the reference
  texts at their own parts. Open: the 95 reference texts that are hidden,
  those of the diodes D6, D11 and D17 among them.
- What the review of 2026-10-13 left beside these: the lower edge of the
  frame of the shield can, which no drawing of the maker confirms, and
  the finger lands of U16, which are not drawn
  ([list](#still-open-after-the-round)).
- Calculate again, after each change, the figures that the change touches
  ([Reproducing the Figures](#reproducing-the-figures)), and run both
  checks. A renamed net or a renumbered part also changes
  `tools/board/carrier.toml`. Revision A can be ordered only when the
  design rules check reports no violation, no difference between board and
  schematic and no unconnected pad, and when a person has reviewed it.
  The outputs of draft A2 were filed with the three counts at zero and
  without that review (D-105).

#### 5. Close the Open Checks

Section 16 of the specification, tracked in
[`docs/checks/`](../docs/checks/README.md):

- Close the component checks, part by part, each with the comparison of
  pin numbers and land pattern with the datasheet. None is closed.
- Before revision A is ordered, without a carrier board (proof-of-concept
  boards of draft A2 may be ordered ahead of these, D-105): the risk
  prototypes of phase 1 (reaction of the range sequencer, pre-regulator
  with its tracking amplifier, start of the boost converter from a supply
  limited to 0.7 A),
  the linear range of the amplifier near full scale with the output below
  0.2 V, and on loose parts the leakage of the VOUT suppressor, the leakage
  of the range and clamp transistors and the on-resistance of the
  multiplexer.
- Find stock for the three lines of the bill of materials that had none,
  and order the parts with long lead times first.
- On the first board, before a DUT is connected: every gate at or below
  0.3 V in the states that section 16 lists, then the gate ramp of the
  output switch and the in-rush with a capacitor in place of the DUT.
- On the first board, the thermal check of decision D-93: the temperature
  rise of the linear regulator U18 at its full dissipation. Its island of
  output copper is 291 mm² on the bottom layer and 102 mm² on the top
  layer, and the datasheet figure of 65 K/W is for 225 mm² of top copper,
  so the figure has to be read on the board.
- On the bench, what the four decisions leave to check: one edge of
  PWR_GOOD per event at start and at stop with 10 nF (D-95); the step
  response of the driver rail with the position at U28 empty and with a
  capacitor in it, whose value is chosen there (D-96); the start of the
  boost converter from a supply limited to 0.7 A, which says whether a
  detector with a time-out of milliseconds is needed at U9 (D-97); the
  data cable plugged again with the damper fitted, and the recharge
  pulse at a change of input, which was not simulated (D-98).
- Measure what the simulations leave to the bench
  ([list](#where-the-text-differs-and-what-stays-for-the-bench)).

#### 6. With the Firmware

- Write the PIO programs of the range sequencer, of the over-current trip
  (a program of its own in PIO 2, D-104) and of the acquisition, and
  test them in an emulator. Until they exist the pin assignment of the
  controller is provisional, and a change of it changes the Controller
  sheet and the board.
- The firmware rules that guard hardware (F-1 to F-36, section 6.6 of the
  specification) are part of this design: several limits of the carrier
  hold only with them. None is implemented; the
  [firmware guide](../firmware/README.md) says what exists.

#### After Every Change

- Plot the pictures of `doc/` again after every change to the schematic or
  the board; the commands are at the end of [`doc/README.md`](doc/README.md).
  Export the bill of materials again after a change to the schematic.
- After a change to the schematic, check that the nets of the 1 A path
  still have their net class, and run both checks.
- After a change to the schematic, export its netlist, write the snapshot
  of the simulations again and run the benches of the blocks that the
  change touches. The results describe the netlist of the snapshot from
  which they were run, and no check compares the two by itself: the
  [simulation guide](../simulation/README.md#when-the-schematic-changes)
  has the steps. For the change of 2026-10-10 the snapshot is written
  and the benches are not run yet.
- After the project was open in the KiCad editor, look at what KiCad
  wrote into `kicad/power-profiler-carrier.kicad_pro` before the change
  is recorded: the editors add settings blocks to the project file
  ([KiCad Project](#kicad-project)).
- After a change to the board, export the fabrication outputs again: the
  files in `fabrication/draft-a2/` are those of the board file of
  2026-10-13, and they no longer match a board that changed. The commands
  are in the [README of that folder](fabrication/draft-a2/README.md).

## Design References

In the [specification](../docs/specification.md):

- Section 3: system architecture and power tree.
- Section 4: analog hardware design, from the power input to the error
  budget, and the controller module.
- Section 5: pin map.
- Section 6.6: firmware rules that guard hardware.
- Section 10: PCB and mechanical guidelines. Section 10.8 has the state
  of the board after the layout review and after the round of
  2026-10-13, and what stands before the fabrication of revision A.
- Section 15: decisions, D-23 onwards for the drafts, D-47 to D-86 for
  draft A2, D-87 to D-93 for its layout review, D-94 for the place of
  the circuit simulations, D-95 to D-98 for the decisions that followed
  them (D-95, D-97 and D-98 are drawn, D-96 is not), D-99 to D-101 for
  the text brought in line with the simulations, D-102 for the license
  of the simulation folder, D-103 and D-104 for the software, of which
  the second makes the over-current trip a program of its own in PIO 2
  and changes no pin, and D-105 for the fabrication outputs of draft A2,
  filed for an order of proof-of-concept boards with the items before an
  order still open.
- Section 16: open checks. The first item of "Before the board is
  ordered" says what is drawn of the four decisions and what is open,
  and the end of the section has the open points of the circuit
  simulations. By D-105 the items of that list are conditions of
  revision A, and proof-of-concept boards of draft A2 may be ordered
  before them.
- Section 17: bill of materials summary, with the parts that the drawn
  decisions fitted or changed.

## Revisions

Board revisions are named with letters. Drafts A0, A1 and A2 are review
drafts; A2 is the one in this directory. Revision A is the carrier board
of phase 5, fabricated when the open checks that precede it are closed,
and revision B corrects the issues found on it (phase 7). Draft A2 is the
first state with fabrication outputs: by decision D-105 proof-of-concept
boards may be made from it before revision A, and such boards are
draft A2, as their silkscreen says. Fabrication outputs are stored per
draft or revision: `fabrication/draft-a2/` exists, and
`fabrication/rev-a/` is the folder that revision A will get.

- Draft A1 changed, against draft A0, the controller (a Raspberry Pi Pico 2
  in place of the ESP32-S3 development board and of the programmable logic
  device), the connectors of the DUT, the reference designators and the
  board (decisions D-39 to D-46).
- Draft A2 is draft A1 after a review of every part and every block, which
  recorded 432 findings, six of them blockers. The power input has a
  current limiter per USB input and a priority multiplexer in place of the
  fuse and the diode OR-ing, and a supervisor of the 5 V rail gives the
  carrier one off state. Four comparators make PWR_GOOD, the pre-regulator
  follows the output of the linear regulator, the switches of the path
  close slowly behind gate networks, the two mode switches cannot be closed
  together, and VIN withstands −20 V to +20 V. Clamps, pull resistors and
  series resistors protect the ladder, the terminals, the converter input
  and the lines of the controller. The schematic grew from 278 parts on
  13 pages to 428 parts on 15 and was numbered again, and every line of
  the bill of materials has a part number. Where the specification asked
  for more than an instrument of this class delivers, the requirement was
  restated (R-04, R-06 to R-10 and R-14). The board grew from
  130 mm × 100 mm to 150 mm × 100 mm and is placed and routed
  automatically, where draft A1 had placed footprints and no tracks
  (decisions D-47 to D-86).
- The layout of draft A2 was reviewed on 2026-10-10. The autorouted board
  had 956 of its 984 connections and 28 open. The review closed them and
  drew the pours of the 1 A path, the guard, the Kelvin lines, the pour of
  the 5 V rail and the ground fills, with scripts and with an independent
  check of every rule. The schematic and the bill of materials did not
  change, and the draft keeps its name. The board departs from the words
  that section 10 of the specification had in seven points; the owner
  accepted them the same day, and they are decisions D-87 to D-93. The
  review left a list of open items ([Layout Review](#layout-review)). The
  scripts that calculate its figures are in
  [`tools/board/`](../tools/board/README.md), and the silkscreen and both
  title blocks carry the name "Open Power Profiler - Carrier Board".
- The circuits of draft A2 were simulated on 2026-10-10, from the netlist
  of its schematic. The central design figures come out again
  ([Circuit Simulations](#circuit-simulations)). The simulations are in
  [`../simulation/`](../simulation/README.md) by decision D-94. They
  raised four points, which the owner decided the same day (D-95 to
  D-98). In fourteen places the simulations differed from the text of
  the specification; twelve are corrected there, and none of the
  corrections changes a part.
- Three of those four decisions were drawn into draft A2 on 2026-10-10,
  after the simulations: 10 nF at C32 to C34 (D-95), R14 and C5 fitted
  (D-98), and the text of the position U9 (D-97). Values, part numbers,
  fitted flags and texts changed, in the schematic and on six footprints
  of the board. No copper changed, no part was added or moved, and the
  draft keeps its name. The bill of materials went from 368 to 370 parts
  on its 151 lines. The simulations were not run again on the changed
  circuit, and D-96, a position for a capacitor at U28, is not drawn.
- On 2026-10-13 the owner opened draft A2 in the KiCad editor and found
  it coherent, and the footprints and the placement were reviewed with
  scripts on the board file, 3D renderings and the datasheets. Five
  findings of that review were worked into the board the same day: U16
  on the land pattern of its own package, a third project footprint;
  nine vias moved away from pads and two from under the wall of the
  shield can; reference texts at their own parts, 330 visible and 95
  hidden; and pin names at J1. The silkscreen got the frames and names of
  the sixteen functional blocks, which were on a documentation layer
  before. No part was added or moved, the circuit did not change, and the
  draft keeps its name. The figures of the 1 A path and of the leakage
  are unchanged
  ([Review of Footprints and Placement](#review-of-footprints-and-placement-2026-10-13)).
- The fabrication outputs of draft A2 were exported on 2026-10-13, after
  that round, and filed in `fabrication/draft-a2/` for an order of
  proof-of-concept boards: eleven Gerber files of the four-layer board,
  two drill files and two assembly files. The owner asked for them with
  the items before an order still open, which is decision D-105. Boards
  made from them are draft A2 and not revision A. No order is recorded
  ([Fabrication Outputs of Draft A2](#fabrication-outputs-of-draft-a2)).

## License

Copyright (c) 2026 Luiz Guilherme Ito.

The design files in this directory are licensed under the CERN Open Hardware
Licence Version 2 - Permissive (CERN-OHL-P v2). See [LICENSE](LICENSE). They
are provided without any warranty, as stated in section 5 of the license.
