Guiimartinho/open-power-profiler/docs/specification.md

# System Specification: Open Power Profiler (Raspberry Pi Pico 2)

Target Performance: 100 kSPS Sampling Rate | Range: 100 nA to 1 A | Dual-Mode:
Source Meter & Ampere Meter.

## 1. Purpose, Scope & How to Use This Document

Goal: an open-source instrument in the class of the Nordic PPK2, built around
the RP2350 microcontroller of the Raspberry Pi Pico 2. The project started on
the ESP32-S3; decision D-39 changed the controller. It was inspired by
<https://github.com/Gedankenn/power_profiller> (ESP32 + INA226 over I2C, about
50 Hz, single range, WiFi dashboard). That design is the starting idea only;
this specification replaces its architecture.

The instrument is built from two boards. The controller is a Raspberry Pi
Pico 2, bought ready-made. The instrument's own electronics are on a carrier
board, designed in this project, that the Pico 2 plugs into through its two
pin headers (sections 4.11 and 5).

This is the architecture and planning baseline. It fixes the structure, the
interfaces, the budgets and the order of work. It does not replace the
schematic, the simulations or the bench measurements.

- Work phase by phase (section 13). A phase is finished only when its exit
  criteria are met with recorded measurements, filed as a report in
  [`reports/`](reports/).
- Part numbers marked "candidate" are proposals that no check record has
  accepted. Section 16 lists what must be confirmed before the schematic is
  frozen; each check is filed as a record in [`checks/`](checks/). No value
  in this document has been measured: each figure is a datasheet value, a
  calculation, a simulation or an estimate, and says which. The figures of
  the board that are marked "calculated from the drawn copper" are
  produced by the scripts in [`../tools/board/`](../tools/board/)
  (section 16).
- The figures marked "simulated" were taken from simulations made while
  draft A2 was designed, with circuits typed by hand, whose files are not
  filed. On 2026-10-10 the circuits were simulated again, from the netlist
  of the final schematic: the package, the models, the benches and their
  results are in [`../simulation/`](../simulation/) (D-94), and a reader
  can run them again. Those simulations give the central design figures
  of this document again, block by block; their result pages show the
  distance from the value stated here beside every figure. A figure that
  this document takes from them is marked "simulated on 2026-10-10". They
  raised
  four points for a decision before boards are ordered, which the project
  owner decided on 2026-10-10: decisions D-95 to D-98, with the sections
  that they change. In fourteen places the simulations differed from a
  figure or a rule that this document stated, or showed something that
  it did not state. Twelve of them are corrected in the text since
  2026-10-10, three of them by decisions D-99 to D-101; two wait for the
  run of the benches on the drawn decisions; and the questions that the
  corrections leave are listed as open at the end of section 16. A
  simulation is not a measurement: every active
  part in it is a model written from a datasheet, a typical part at room
  temperature.
- The schematic in [`../hardware/kicad/`](../hardware/kicad/) is draft A2. Every
  sheet is drawn, 14 below the root sheet (D-83), so the design can be reviewed
  as a whole. It passes the electrical rules check, and an independent review of
  its netlist against the datasheets found no defect that blocks the draft; that
  review closes no check of section 16. Its parts are the candidates of this
  document, no check of section 16 is closed (D-37), and nothing has been built
  or measured.
- Three decisions of 2026-10-10 that follow the circuit simulations are
  drawn since the same day, as changes of values and of fitted parts
  that move no copper: 10 nF at the capacitors C32 to C34 of the rail
  monitor (D-95), the damper R14 with C5 fitted (D-98), and the text of
  the position U9, which stays without a part (D-97). The schematic, the
  board, the bill of materials and the netlist snapshot of the
  simulations hold them, and the electrical rules check and the design
  rules check report nothing. A fourth is not drawn: the position for a
  capacitor at the input of the buffer U28 (D-96), which needs a
  footprint and copper. The circuit simulations were not run again:
  their results are those of the circuit before these changes
  (section 16).
- The board of the draft was placed by a generator and routed automatically
  (D-86), which left 28 of its 984 connections open. Its layout was reviewed
  on 2026-10-10, with scripts and checked by independent calculation: every
  connection is closed, the design rules check reports nothing, and the
  copper that an autorouter does not draw is drawn. Two figures, both
  calculated from the drawn copper and not measured: the copper of the 1 A
  path has 19.5 squares (10.4 mΩ at 40 °C) in source mode and 23.3 squares
  (12.3 mΩ) in ampere mode, against the limit of 30 squares, and the surface
  leakage into the measured node is 5.1 nA on a clean board, against the
  10 nA of the budget. Seven points in which the drawn board departs from
  section 10 are recorded as decisions (D-87 to D-93). On 2026-10-13 the
  project owner opened the schematic and the board in the KiCad editor
  and found both coherent, which was a look and not a review item by
  item. The same day the footprints and the placement were reviewed with
  scripts on the board file, 3D renderings and the datasheets, and five
  findings of that review were worked into the board: the land pattern of
  U16, vias at pads and under the wall of the shield can, reference texts
  of the silkscreen and the pin names of J1. The two figures above are
  unchanged by that round. Nobody has reviewed the board item by item in
  the KiCad editor, and some open items need parts moved: section 10.8
  gives the state, and [`../hardware/README.md`](../hardware/README.md)
  the detail. It is a review draft and not revision A.
- The fabrication outputs of draft A2 are filed since 2026-10-13 in
  [`../hardware/fabrication/draft-a2/`](../hardware/fabrication/draft-a2/)
  for an order of proof-of-concept boards (D-105): eleven Gerber files of
  the four-layer board, two drill files and two assembly files. The
  project owner asked for them while the items that section 16 lists
  under "Before the board is ordered" were still open. Boards made from
  these files are draft A2 and not revision A; those items stay open and
  remain conditions of revision A. No order is recorded: no board has
  been ordered or made as far as the repository shows.
- Names that look alike: R0 to R3 are the four current ranges and D0 to D7
  the logic inputs, as on the PPK2. The parts of the drawings are numbered
  as KiCad numbers them (D-45), so the drawings also hold resistors R1 to
  R3 and diodes D1 to D7. Where this document means one of those parts, it
  says so or gives the value of the part.
- The firmware in [`../firmware/`](../firmware/) builds for the Pico 2 with
  the Pico SDK since 2026-10-12. Its hardware-independent code was not
  affected by D-39; no adapter and no PIO program is written yet
  (section 6).
- Every deviation from this document is recorded as a new entry in the
  decision log (section 15), with the reason.

Out of scope for the first hardware revision: galvanic isolation, voltages
above 5 V, currents above 1 A, four-quadrant (sinking) operation, WiFi
streaming and battery emulation.

## 2. Requirements

| ID | Item | Requirement |
| --- | --- | --- |
| R-01 | Sampling rate | 100 kSPS delivered to the host, hardware-timed |
| R-02 | Data integrity | Zero lost samples in a 10 minute capture; any loss is reported |
| R-03 | Current range | 100 nA to 1 A, automatic range switching |
| R-04 | Resolution | 100 nA or better in the lowest range at full bandwidth; RMS noise in that range at most 5 nA in ampere mode from a quiet supply and at most 40 nA in source mode (D-59) |
| R-05 | Accuracy | ±1 % of reading ±0.1 % of range after calibration (target) |
| R-06 | Burden voltage | Shunt drop 100 mV maximum; total path drop 200 mV at 1 A (D-64) |
| R-07 | Range change | On a 1 µA to 500 mA step the instrument adds at most 0.5 V of drop between its supply node and VOUT with 1 µF (effective) at the output terminals, more than 0.2 V for at most 1 µs, and at most 0.25 V with 10 µF; no oscillation between ranges (D-65) |
| R-08 | Source mode | 0.8 V to 5.0 V in 1.3 mV steps; output current, design figure: 1.0 A up to 2.0 V, falling in a straight line to 0.6 A at 5.0 V (0.83 A at 3.3 V); beyond that curve the output may sag by up to 0.6 V and an overload is reported (D-56) |
| R-09 | Ampere mode | External supply 0.8 V to 5.0 V passed through the shunts; the VIN terminal withstands −20 V to +20 V while the ampere switch is open (D-60) |
| R-10 | Digital inputs | 8 channels, 1.65 V to 5.5 V logic at the supply of the level translator, sampled with the current (D-79) |
| R-11 | Host link | Native USB Full-Speed, CDC ACM, binary protocol |
| R-12 | Calibration | Per-range gain and offset stored on the device |
| R-13 | Protection | Over-current trip, reverse polarity, over-voltage, thermal |
| R-14 | Power input | USB-C 5 V on the carrier board, or the USB connector of the controller alone; input current limited to what the source in use offers (0.45 A, 1.4 A or 1.7 A); operation with 4.25 V or more on the 5 V rail (D-49) |
| R-15 | Host software | Capture, live view, statistics, export, on Windows/Linux/macOS |
| R-16 | Openness | Sources published: firmware and host software under MIT, hardware under CERN-OHL-P v2 |
| R-17 | Software quality | Automated tests with coverage gates, static analysis and continuous integration for firmware and host software (section 18) |

Seven requirements carry the figure that the architecture delivers, each
with the decision that set it. None of the figures is a measurement: each
is a datasheet value, a calculation, a simulation or an estimate, as
stated, and section 11 holds the test that has to confirm it. The yardstick
is the PPK2 User Guide v1.0.1.

- R-04 (D-59). The 100 nA resolution holds in both modes; the noise figure
  depends on the mode. From a quiet supply the signal chain alone gives
  about 2.1 nA RMS in R0, the lowest range (simulated with typical
  datasheet figures). In source mode the output noise of the linear
  regulator (125 nV/√Hz, a typical datasheet figure without a maximum)
  stands across the 1 kΩ shunt above 1.6 kHz, the corner of the shunt with
  the 100 nF at VOUT: 26 nA to 27 nA RMS at full bandwidth, 1.1 nA after a
  mean of 100 samples (simulated). The limit of 40 nA leaves room for a
  figure that is typical only. The PPK2 states a resolution of 0.2 µA in
  its lowest range and measurement down to about 200 nA.
- R-06 (D-64). At 1 A the current passes five switch transistors, the
  0.1 Ω shunt, copper, two contacts and, in ampere mode, the fuse of the
  VIN terminal. From the VIN terminal to the VOUT terminal that is 158 mV
  with typical parts and 181 mV at the bounds; from the regulator output
  144 mV and 161 mV (calculated from the on-resistance of the datasheet at
  50 °C; the tolerance of the fuse and 20 mΩ to 25 mΩ for copper and
  contacts are allowances without a source). The shunt limit of 100 mV is
  unchanged. The PPK2 guide states no burden voltage.
- R-07 (D-65). The requirement is the drop that the instrument adds between
  its supply node and VOUT. The jump comparator acts at 151 mV across the
  ladder and range 3 conducts 0.35 µs later (0.20 µs to 0.51 µs,
  section 4.4); until then the capacitor at the DUT supplies the step.
  Simulated drop: 312 mV nominal and 422 mV in the worst case with 1 µF,
  169 mV and 186 mV with 10 µF. The limits hold only if the range sequencer
  reacts within 100 ns (rule F-16 of section 6.6), which phase 1 measures
  (section 13). A limit of 0.2 V would need about 8 µF behind the shunts,
  whose leakage and charging current would be measured as DUT current. The
  PPK2 guide states no limit for a range change.
- R-08 (D-56). The curve follows from the dropout voltage of the linear
  regulator and from the 5.5 V at which the output of the pre-regulator
  ends (section 4.2). At the tolerance limits the head room exceeds the
  dropout limit by 2 mV at 5.0 V and 0.6 A, 15 mV at 3.3 V, 25 mV at 2.0 V
  and 85 mV at 0.8 V (calculated; the dropout limit is interpolated
  between the two points the datasheet guarantees). Typical parts deliver
  1 A at every set-point (calculated). The curve is a design figure until
  the test of section 11 has confirmed it on the first boards. It needs
  4.3 W at the input with typical parts and 4.9 W at the limits. The PPK2
  states 600 mA in source mode and a rated power of 5 W; the curve is at
  or above it at every voltage.
- R-09 (D-60). The range in use is that of the PPK2. The withstand figure
  holds while the ampere switch is open: without a request, with a request
  that hardware refuses, and without supply. Both transistors of the pair
  block, and less than 1 mA flows at the terminal (simulated). A detector
  refuses to close the switch above 5.46 V (5.41 V to 5.51 V, calculated).
  While the switch is closed the supply has to stay between 0.8 V and
  5.0 V. Above 22 V the suppressor of the terminal is lost; the fuse does
  not protect it (section 4.9). The PPK2 guide states no withstand
  voltage.
- R-10 (D-79). The level translator is specified from 1.65 V (datasheet
  value). With the supply jumper as built its supply is up to 10 mV below
  the output voltage, so the logic channels are valid for an output of
  1.67 V or more (calculated). The PPK2 states 1.65 V to 5.5 V for its
  logic port.
- R-14 (D-49). The budget is an input current for each source (section 4.1):
  0.45 A through the carrier on the USB port of a computer or on a USB-C
  source that advertises the default current, 1.4 A on a 1.5 A source and
  1.7 A on a 3 A source. Current limiters hold each input below 0.67 A to
  0.85 A and 1.81 A to 2.17 A (calculated from datasheet limits). The 5 V
  rail may fall to 4.25 V, which the −4 V rail still regulates from
  (calculated on typical curves); below 3.9 V a supervisor switches the
  carrier off. From 4.5 V at the receptacle, the lower limit of the PPK2
  supply, the instrument delivers 5 V at 0.6 A with 4.34 V on the rail
  (calculated). 5 V at 1 A needs 6.7 W to 7.6 W at the input and a 3 A
  source.

## 3. System Architecture

```text
USB-C 5 V ────► limiter ─┐
                         ├► multiplexer ─► 5 V rail ─► supplies of the carrier
Pico 2 VBUS ──► limiter ─┘

5 V rail ──► pre-regulator ──► LDO (source mode) ◄── DAC ◄── SPI
                                    │
VIN (ampere mode) ──► protection ──►├── mode switch
                                    │
                         shunt ladder + range FETs ◄── range logic
                                    │         │ Kelvin sense   ▲
                         output switch     in-amp ──┬──► comparators
                                    │               └──► ADC ──► Pico 2
                                  VOUT ──► DUT          D0..D7 ──► level shift
```

Everything in the diagram except the controller is on the carrier board. The
controller is a Raspberry Pi Pico 2 on sockets. Its USB connector carries the
measurement stream and the commands, and firmware is loaded through it. It
is also the second power input of the instrument (Power Tree, below).

Design principles:

- Timing belongs to hardware. The sampling clock and the up-range reaction
  never depend on firmware latency: both are state machines in the PIO
  blocks of the controller, which run from the system clock whatever the
  processors do (D-40).
- Protection has three levels, and each fault is assigned to one of them.
  Firmware may request, hardware may refuse (D-43).
  - Hardware, with no program involved: an over-voltage on VIN holds the
    ampere switch open through one transistor (D-43), and a source-mode
    request holds it open through a second one, so the two mode switches
    cannot be closed together (D-62). A supervisor switches the supplies of
    the carrier and the pre-regulator off when the 5 V rail collapses
    (D-48). Each USB input has a current limiter (D-47). Fuses, clamps and
    the limits inside the regulators belong here too, and so do the pull
    resistors that open every switch when the pins of the controller are
    released (section 4.11).
  - State machines of the PIO: the up-range path and the over-current trip.
    They work with both processors halted, as long as the analog rails are
    valid. PWR_GOOD reports that 3V3_A, +12 V_A, −4 V_A and the reference
    are present and that the supervisor of the 5 V rail has released the
    carrier.
  - Firmware, guarded by the hardware watchdog of the RP2350 (D-81):
    everything else. Section 6.6 lists the firmware rules that protect
    hardware.
- The device sends raw data. Conversion to amperes happens on the host with
  the calibration table, which keeps the real-time path short.
- Every sample carries its own context (range, validity, fault, logic bits),
  so a capture can be interpreted without side channels.

### Power Tree

The carrier board has its own USB-C power connector, and the Pico 2 has its
USB connector. Each of the two inputs passes a current limiter, and a
priority power multiplexer connects one of them to the 5 V rail of the
carrier (D-47). Either cable therefore powers the whole instrument; USB-C
is used whenever it is present. A diode feeds the VSYS pin of the Pico 2
from the 5 V rail. Sections 4.1 and 4.11 have the details.

```text
USB-C VBUS ──────────────► limiter 2.0 A ──► damper ──┐ input 1 (priority)
(carrier)                  clamp 5.45 V               ├─► multiplexer ─► 5 V rail
Pico 2 VBUS ─► jumper ───► limiter 0.76 A ─► damper ──┘ input 2
(pin 40)                   clamp 5.45 V

5 V rail ─┬─► diode ──► VSYS of the Pico 2 (pin 39)
          ├─► supervisor, 3.9 V and 0.3 s ──► 5V_OK
          ├─► boost (runs from the rail itself) ──► +13.5 V
          │        ├─► 0.47 Ω ─► LDO [5V_OK] ─► +12 V_A (in-amp, mux, gate
          │        │                            drivers, buffers)
          │        └─► VCONTROL of the output LDO
          ├─► 2.2 Ω ─► inverter with regulator [5V_OK] ─► −4 V_A (in-amp, mux,
          │                                    buffers, minimum load)
          ├─► low-noise LDO [5V_OK] ─► 3V3_A (ADC, comparators, DAC, monitor)
          │        ├─► 10 Ω ─► reference ─► VREF 2.5 V (ADC, DAC, monitor,
          │        │                        thresholds)
          │        └─► buffer ─► VDRV = 1.091 × VREF (ADC driver and its clamp)
          ├─► LDO [5V_OK] ─► 3V3_C (carrier logic, rail monitor)
          └─► buck-boost, tracking [SMU_ON and 5V_OK] ─► V_PRE ─► LDO IN
                   V_PRE = output of the LDO + 0.45 V to 0.64 V

[5V_OK]: enabled by the supervisor of the 5 V rail
```

Input stage:

- Each limiter is an electronic fuse (candidate: TPS259621, U4 at the USB-C
  connector and U3 behind the jumper of the Pico 2). It withstands 21 V at
  its input, limits the current and clamps its output at 5.28 V to 5.61 V when
  the input rises above 5.54 V to 5.83 V (datasheet values). The limit is 2.0 A
  on USB-C and 0.76 A on the input of the controller module, the Pico 2
  (calculated from the datasheet equation).
- The multiplexer (candidate: TPS2116, U5) blocks reverse current on both
  inputs, so neither connector is fed back from the rail (1 nA typical,
  datasheet value). It selects USB-C while the output of that limiter is above
  2.15 V to 2.59 V (calculated), which is below every other threshold of the
  rail: the input changes only while the carrier is held off.
- The 5 V rail carries about 74 µF, of which 47 µF is an electrolytic
  capacitor (C11); about 62 µF remain at 5 V (estimate from the bias
  curves of the ceramic parts).
- The damper at input 2 in the drawing above is decision D-98. It is
  fitted in the schematic since 2026-10-10; draft A2 had drawn its two
  positions without parts (section 4.1).

Supervisor (D-48). A voltage supervisor on the 5 V rail (candidate:
TPS3808G01, U6) drives the open-drain signal 5V_OK:

- 5V_OK falls when the rail passes 3.83 V to 4.00 V and returns 0.18 s to 0.42 s
  after the rail is back above 4.12 V at most (calculated from datasheet limits
  and the 0.1 % divider R21, R22; nominal 3.91 V and 0.30 s).
- 5V_OK enables the two 3.3 V regulators, the +12 V_A regulator and the
  charge pump of −4 V_A, the last one through the divider R27,
  R28. Through a transistor it also gates the enable of the
  pre-regulator (section 4.11). The carrier has one off state, and it is
  reached without firmware.
- The boost converter is not gated. It runs from the rail itself, so
  +13.5 V and with it the VCONTROL pin of the output LDO are present while
  the supervisor holds everything else off.

Analog rails (D-51):

- The boost converter (candidate: LMR62014, U10) makes +13.5 V from the 5 V
  rail, 13.0 V to 14.1 V with the tolerances (calculated). Its inductor L1
  is 10 µH with a saturation current of 3 A (datasheet value), and 10 µF in 1210
  stands on its output (C27).
- R37, 0.47 Ω, and C29, 10 µF, stand between the boost output and the
  regulator of +12 V_A (candidate: LT3042, U13). R38 sets 12.0 V; C30
  at the same pin sets the noise and the slow approach of the last volt (step 6
  of the table below).
- The charge pump of −4 V_A (candidate: LM27761, U11) takes the 5 V rail
  through R30, 2.2 Ω, with C21, 22 µF. Its feedback resistors R34 and
  R36 are 0.1 % parts: the rail is −3.91 V to −4.05 V (calculated).
- The two 3.3 V regulators are of one type (candidate: LP5907): U7 for 3V3_C
  and U8 for 3V3_A.

Order of the rails at power-up (simulated, with datasheet delays):

| Step | Rail | Time |
| --- | --- | --- |
| 1 | 5 V rail | Ramp of 1.7 ms, about 1 ms after the limiter has turned on |
| 2 | +13.5 V | With the 5 V rail; charged about 3 ms after the start |
| 3 | Hold-off | 0.18 s to 0.42 s; only the 5 V rail and +13.5 V are present |
| 4 | 3V3_C and 3V3_A | 0.04 ms after 5V_OK |
| 5 | −4 V_A | 0.3 ms after 5V_OK |
| 6 | +12 V_A | Above 9.85 V after 8 ms to 17 ms; settles in about 0.8 s |
| 7 | VREF | Above 2.245 V after 24 ms; within 0.1 % after about 80 ms |
| 8 | PWR_GOOD | High about 24 ms after 5V_OK, 0.2 s to 0.46 s after power |
| 9 | V_PRE | When firmware raises SMU_ON (F-28, section 4.2) |

- No rail of a 12 V part is present before the 3.3 V rails, and the
  reference is never present without the rail of its loads: it is supplied
  from 3V3_A through R31, and the diode D7 keeps VREF within one Schottky
  drop of 3V3_A while the rails fall (D-53).
- Schottky diodes clamp −4 V_A to ground (D8) and ground to +12 V_A
  (D9), so that neither rail can be pulled to the wrong polarity
  through its loads while the other one is absent: −4 V_A stays below
  +0.24 V and +12 V_A above −0.23 V (simulated, D-52).
- At power-off, or when the supervisor trips, 3V3_C is below 3.0 V after
  0.02 ms, PWR_GOOD is below 0.8 V after 0.3 ms, 3V3_A is below 1.0 V
  after 4 ms to 6 ms and +12 V_A is below 3.6 V after about 14 ms
  (simulated). For about 10 ms +12 V_A is therefore still above 3.6 V
  while 3V3_A is below 1 V; the series resistors and clamps between the
  12 V parts and the 3.3 V parts bound the current in that interval
  (section 4.5).

Rail monitor (D-54). Four open-drain comparators in one package (candidate:
MCP6569, U14) share the line PWR_GOOD, which R51 pulls up to 3V3_C and
R52 pulls down to ground. Both thresholds of the monitor are fractions
of 3V3_C (R41, R43, R44). A 10 nF capacitor from each threshold node and
from the sense node of −4 V_A to ground (C32 to C34, D-95) keeps an edge
of the line from moving its own threshold: in the package every output
pin is the neighbor of an inverting input. The value was 1 nF until D-95,
and the drawings hold 10 nF since 2026-10-10. With 10 nF the three nodes
follow their dividers with time constants of about 0.09 ms, 0.25 ms and
0.36 ms (calculated from the resistor values, each node alone; a tenth of
that with 1 nF). The figures of this document for the edges of PWR_GOOD
at power-up and at power-off were simulated with 1 nF; the run with
10 nF is open (section 16). PWR_GOOD is low when any of
these holds (calculated from the resistor values; the bands include the
tolerances and the drift of the parts):

| Rail | PWR_GOOD low when | Band |
| --- | --- | --- |
| 3V3_A | Below 2.97 V (90 % of 3V3_C) | 2.89 V to 3.05 V |
| +12 V_A | Below 9.85 V | 9.25 V to 10.48 V |
| −4 V_A | Above −2.57 V | −2.29 V to −2.86 V |
| VREF | Below 2.245 V | 2.14 V to 2.35 V |
| 3V3_C | Absent (no pull-up) | — |
| 5 V rail | 5V_OK low: every rail above is off | 3.83 V to 4.00 V |

- The flag reports presence, not tolerance. Firmware checks the tolerance of +12
  V_A, −4 V_A and the 5 V rail with the monitor converter (F-12, section 4.11).
- PWR_GOOD does not watch the level of 3V3_C: its thresholds and its
  pull-up follow that rail, so a 3V3_C that stands low still reads as
  good. Only a missing 3V3_C is detected.
- The line can show a burst of edges for up to about 1 ms while a slow rail
  crosses its threshold (estimate; the hysteresis of the comparators is 1 mV to
  5 mV, datasheet value). Firmware therefore counts PWR_GOOD as valid only after
  10 ms of uninterrupted high (F-2).
- PWR_GOOD goes to GP28 of the controller through R4 and to a side
  bit of every sample (section 4.7). TP17 is its test point.

## 4. Analog Hardware Design

### 4.1 Power Input

- The power connector is on the carrier board, separate from the USB
  connector of the Pico 2. That one is a micro-USB receptacle without CC
  pins, good for what a default USB port offers. Its VBUS pin (pin 40)
  feeds the second input of the multiplexer through a solder jumper
  (JP1, closed as built) and a current limiter, so the data cable
  alone is enough while the DUT draws little. USB-C is used whenever it
  is present (D-47).
- USB-C receptacle (J2) as a sink, power only: 5.1 kΩ pull-down on CC1 and
  CC2 (R7, R11). Both CC voltages are read through the monitor ADC to
  classify the source. An ESD array (candidate: TPD4E1U06, U2) sits on the
  two CC pins (D-50); its leakage of 10 nA at most (datasheet value at 2.5 V)
  moves a CC reading by 51 µV (calculated), against windows that are 90 mV
  apart.
- 4.7 µF (C2), 100 nF and a transient suppressor with a stand-off
  voltage of 10 V (D2) are at the connector, ahead of every current
  limit. There is no fuse: a short of one of these parts is limited by
  the source alone.

Input stage (D-47):

- Limiter of the USB-C input: an electronic fuse (candidate: TPS259621, U4).
  Input rated 21 V absolute; current limit 2.0 A, set by R15 (1.81 A to 2.17
  A with the tolerances, calculated from datasheet limits); output clamped at
  5.28 V to 5.61 V once the input is above 5.54 V to 5.83 V (datasheet values;
  R12 selects that level). The enable divider R9, R10 turns it on at
  2.92 V to 3.09 V and off at 2.67 V to 2.87 V at the connector (calculated).
  C4 sets the output ramp to 13 V/ms after a turn-on delay of about 0.25 ms
  (datasheet, typical).
- Damper: 2 × 22 µF behind 0.33 Ω (C9, C10, R20) and 1 µF at
  the output of that limiter, which is input 1 of the multiplexer.
- Limiter of the module input: the same part (U3) with a limit of 0.76 A,
  set by R13 (0.67 A to 0.85 A with the tolerances, calculated). It has the
  same enable thresholds, no ramp capacitor and a turn-on delay of about 0.08 ms
  (datasheet, typical). 1 µF and 100 kΩ (R17) are at its output, input 2 of
  the multiplexer; the resistor defines that node when the jumper is open.
- Damper of the module input (D-98): 10 µF behind 0.33 Ω (C5, R14) at
  the output of that limiter. D-84 had left the two positions without
  parts; they are fitted in the schematic since 2026-10-10.
- A Schottky diode lies across each limiter, anode on its output (D4,
  D3). When a cable is pulled it returns the charge behind the limiter, so
  that the output stays within 0.3 V of the input, which is the rating of the
  part (datasheet). It does so for the milliamperes of an unplug, not for an
  input that is shorted while the rail is charged.
- Multiplexer (candidate: TPS2116, U5) in priority mode: inputs rated 6 V
  absolute and 5.5 V in operation, reverse current 1 nA typical, soft start of
  1.7 ms after a delay of 1 ms (datasheet values). The divider R18, R19
  puts the priority threshold at 2.15 V to 2.59 V on input 1 (calculated), and
  C8 delays it by 0.19 ms. Its status output SRC_ST is open while USB-C
  supplies the rail and low while the input of the module does.
- Path from either connector to the 5 V rail: 0.126 Ω typical and 0.170 Ω at
  most (calculated from the datasheet on-resistances up to 85 °C; contacts and
  copper not counted). At 1.7 A the limiter dissipates 0.33 W and the
  multiplexer 0.16 W, a rise of 18 K each (calculated).
- Not reported to the controller: the limiters regulate the current in an
  overload and switch off only in thermal shutdown, with another attempt after
  cooling (datasheet). Their fault outputs are not connected; firmware learns of
  such an event through the 5 V rail and PWR_GOOD only.

Limits of the USB-C input:

- Supply range in operation: 4.5 V to 5.5 V at the connector, the range
  that the PPK2 states for its USB supply.
- A continuous input up to 10 V is tolerated: the limiter then regulates the
  rail at its clamp level and cycles thermally under load. From 11.1 V the
  suppressor conducts (datasheet value), and a source that delivers amperes
  destroys it.
- A source between 5.5 V and 5.83 V can reach the rail without being
  clamped in the worst unit. The charge pump of −4 V_A is rated for 5.8 V
  and the low-noise regulators for 6 V; the charge pump sits behind 2.2 Ω
  and 22 µF, which take the edges (section 16).
- Hot plug of a live cable: the connector node peaks at up to 11.4 V with
  a 5.25 V source and 12.2 V with 5.5 V, because the ceramic capacitor
  loses capacitance with voltage; the suppressor conducts for
  microseconds. Behind the limiter the voltage stays at 5.51 V or below
  and the rail never rises above the source (simulated with behavioral
  models of the parts).
- A contact that opens and closes again: the inputs of the multiplexer
  come within 25 mV to 85 mV of their 6 V rating in the worst simulated
  corners, with a 5.5 V source and a short cable. No rating is passed,
  but the margin is smaller than the uncertainty of the models. The
  module input therefore has a second damper, R14 with C5, fitted by
  D-98. The simulations of 2026-10-10 give a margin of the same size and
  one case beyond it: while USB-C supplies the rail, a contact that closes
  2 ms to 2.6 ms after it opened takes input 2 to 5.941 V with a limiter
  of typical reaction and to 6.002 V with one that reacts in 15 µs, which
  is an assumption (a 5.5 V port behind a short cable). With the damper,
  its capacitor at half its value, the same gaps give 5.502 V. In those
  gaps the damped input has fallen far less than the undamped one, and
  the longer gap that matches was not run. The measurement stays an open
  check. The recharge pulse at a change of input was not simulated with
  the damper fitted; without it that pulse is 4.103 A through the
  multiplexer, against a pulse rating of 4 A (simulated on 2026-10-10;
  section 16).
- In-rush on a computer port with the single cable: after the spike of the
  module itself the carrier draws 0.71 A to 0.87 A and the port stays at 4.94 V
  or above (simulated, port behind a 1 A switch). The charge drawn above 100 mA
  is 0.44 mC to 0.96 mC, of which the module alone draws 0.12 mC (simulated),
  more than the 50 µC of the USB in-rush test, which is not met.
- The boost converter has no under-voltage lock-out and no soft start
  (datasheet). On the module input the limiter delivers less than the converter
  asks for while its output charges; whether it starts cleanly there is an open
  check (section 16). The position at its enable pin (U9, D-84) stays
  without a part (D-97). The 3.08 V detector of the 803 type for which it
  was drawn has a time-out of 0.24 s and is no longer the part meant for
  it: as drawn the converter starts in one go on an input limited to
  0.67 A to 0.85 A, and with that part fitted the rail falls to the level
  of the detector, which stops the converter for its time-out. With 1 mA
  drawn from the +13.5 V rail in that time, which is an assumption, the
  next attempt starts from an output that has lost its charge (simulated
  on 2026-10-10 with a source of flat current limit; below 2.7 V the
  converter is outside its datasheet). A remedy, if the test of phase 1
  asks for one, is a detector with a time-out of milliseconds.

Thresholds of the 5 V rail, from the top:

| Level | What happens | Evidence |
| --- | --- | --- |
| 5.28 V to 5.61 V | Output of a limiter while it clamps a higher input | Datasheet |
| 5.50 V | Highest rail in operation | Supply range |
| 4.25 V | Firmware opens the output switch after 10 ms (F-14) | D-49 |
| 4.12 V | Highest release level of the supervisor | Calculated |
| 3.83 V to 4.00 V | Supervisor: 5V_OK low, supplies of the carrier off | Calculated |
| 2.92 V to 3.09 V | A limiter turns on (at its connector side) | Calculated |
| 2.67 V to 2.87 V | A limiter turns off | Calculated |
| 2.36 V to 2.58 V | Internal under-voltage lock-out of a limiter | Datasheet |
| 2.15 V to 2.59 V | The multiplexer leaves USB-C for the module input | Calculated |

The order is the design: the supervisor sheds the load first, while a
source in current limit can still recharge the rail through a limiter that
never turned off, and the multiplexer changes its input only after the
carrier has been off since 3.83 V. In an estimate of a load step beyond
what the source delivers (6.3 W on a source limited to 0.75 A to 1.6 A,
96 cases) the rail reaches a minimum of 2.99 V to 3.97 V, VSYS of the
module stays at 3.46 V or above and the controller is not reset.

Power budget (D-49). The curve of R-08 needs 4.3 W typical and 4.9 W with every
part at its limit on the 5 V rail: 0.99 A at 5.0 V and 1.16 A at 4.25 V. 5 V at
1 A, which typical parts deliver beyond that curve, needs 6.7 W to 7.6 W
(calculated, section 4.2). A default USB port does not deliver either, so the
budget follows the source. It is an input current through the carrier, which
firmware computes with a model of the input from the rail voltage and the output
that it reads (F-14):

| Source in use | CC voltage | Input current allowed | Hardware limit | At the output |
| --- | --- | --- | --- | --- |
| Input of the module | Any | 0.45 A | 0.67 A to 0.85 A | About 1.5 W (estimate) |
| USB-C, default port | Below 0.61 V | 0.45 A | 1.81 A to 2.17 A | About 1.5 W (estimate) |
| USB-C, 1.5 A | 0.70 V to 1.16 V | 1.4 A | 1.81 A to 2.17 A | The whole curve of R-08; 5 V at 1 A with typical parts and 5.0 V on the rail |
| USB-C, 3 A | 1.31 V to 2.04 V | 1.7 A | 1.81 A to 2.17 A | The whole curve of R-08; 5 V at 1 A while the rail is above 4.5 V |

- The two entries for 5 V at 1 A are calculated: 6.7 W at 5.0 V is
  1.34 A, and 7.6 W at 1.7 A is 4.47 V.
- With no USB-C source both CC voltages read near zero, and the budget is that
  of a default USB port. A budget above the default is granted only while USB-C
  supplies the rail, whatever CC reads (F-14).
- The firmware limit of the rail is 4.25 V. The charge pump of −4 V_A
  needs 4.19 V on the rail at its deepest set-point (calculated on
  typical curves, with 0.1 % feedback resistors; section 16). The limit
  is read through a divider of 1 % resistors, so a reading of 4.25 V is a
  rail of 4.20 V to 4.30 V before calibration (calculated).
- Compared with the PPK2: its user guide states a USB supply of 4.5 V to
  5.5 V and recommends a second supply that delivers 1 A or more when the
  DUT draws more than 400 mA. With 4.5 V at the USB-C connector this
  instrument delivers 5 V at 0.6 A with 4.34 V on the rail at the largest
  path resistance (calculated), which leaves 85 mV for contacts and
  copper. 5 V at 1 A needs about 4.53 V at the connector (calculated).

What firmware reads:

- CC1 and CC2 on two channels of the monitor converter, at 100 SPS. The class
  changes only after three consecutive samples in the same window, so a lower
  advertisement is followed within 60 ms; a reading above 2.04 V is invalid
  (F-13).
- The 5 V rail on one channel, whose scale also tells which input supplies the
  rail (D-80). The divider is R142 over R151; SRC_ST adds R143 in
  parallel with the lower resistor while the input of the module supplies. The
  channel reads 0.4545 × the rail on USB-C (1.93 V to 2.50 V for 4.25 V to 5.50
  V) and 0.2524 × the rail on the module input (1.07 V to 1.39 V); the threshold
  between the two is 1.67 V (calculated). A reading below it that would mean a
  rail above 5.7 V is inconsistent and is treated as a rail below the limit
  (F-11).
- PWR_GOOD (sections 3 and 4.11).
- The monitor converter runs from 3V3_A. While the supervisor holds the
  carrier off, firmware reads none of these channels and sees only
  PWR_GOOD low.

Enforcement:

- Firmware averages the input current of the budget and the rail voltage over 10
  ms. Above the budget, or with the 5 V rail below 4.25 V, it opens the output
  switch and reports a power-limit fault (F-14).
- Hardware, without firmware: the two limiters (0.76 A and 2.0 A) and the
  supervisor, which switches the supplies of the carrier and the pre-regulator
  off below 3.83 V to 4.00 V. The pre-regulator is off within 0.1 ms of the rail
  passing that level (estimate from typical datasheet delays). The carrier comes
  back 0.2 s to 0.45 s after the rail has recovered; the controller and the USB
  link stay up and report the loss of the carrier supply (F-7). Any dip of the
  rail below that level for more than about 30 µs has the same effect.
- Samples are marked as not valid for 5 ms when the input in use changes or the
  rail steps by more than 0.3 V (F-35).
- The USB configuration descriptor declares 500 mA (F-14).

When a cable is pulled or plugged:

- USB-C pulled, data cable in: the rail falls, the supervisor switches the
  carrier off and the DUT loses its supply. The multiplexer changes to the
  module input when the output of the USB-C limiter has decayed to 2.15 V to
  2.59 V, up to about 0.2 s later at idle (estimate). It does so without soft
  start, because the rail is above 1 V (datasheet); the recharge is a pulse of
  several amperes for some microseconds, until the limiter of the module input
  acts (simulated). The carrier restarts after the delay of the supervisor: the
  output is off for about 0.3 s to 0.7 s (estimate), or longer, because the
  priority input has no hysteresis. The controller keeps running throughout and
  reports the loss of PWR_GOOD.
- USB-C plugged while the module input supplies: the multiplexer opens the
  module input and closes USB-C when the rail has fallen to that input. The rail
  dips to 4.0 V to 4.5 V (simulated: 4.54 V with the typical ramp of the
  limiter, 4.28 V with the slowest ramp inside its datasheet limits, 4.02 V
  with a ramp slower still and a cold bulk capacitor), against a highest
  supervisor threshold of 4.00 V: the carrier keeps running, with little
  margin (section 16).
- Data cable pulled, USB-C in: nothing changes on the rail. The Pico 2
  stays supplied through its VSYS pin; the host link is lost.
- USB-C pulled, no data cable: the instrument is off. The VBUS pins of
  the connector follow the damper down through the diode D4 and are below
  0.8 V about 0.4 s after the unplug (estimate).
- A USB-C source that stands between about 3 V and 4.1 V keeps the
  instrument off although the computer port is good, because USB-C has
  priority from 2.59 V at most and the carrier needs up to 4.12 V. The
  remedy is to unplug it; firmware cannot read the cause.

For bring-up: test points on the USB-C input (TP1), on both inputs of the
multiplexer (TP2, TP4), on the 5 V rail (TP6), on SRC_ST (TP5)
and on 5V_OK (TP9). TP3 shows the current of the USB-C input, 0.297 V
per ampere behind 10 kΩ (calculated from the datasheet gain). With TP9 held
to ground only the 5 V rail and +13.5 V are up.

### 4.2 Source Meter Block (SMU)

- Main Regulator: LT3080 (candidate, U18; 1.1 A, low noise, output
  follows the SET pin down to 0 V). The MIC29302 is not suitable: its minimum
  output is about 1.24 V, above the 0.8 V requirement.
  - IN pin from the tracking pre-regulator (D-30, D-55); VCONTROL pin from
    the +13.5 V output of the boost converter, ahead of the +12 V_A
    regulator, so its load-dependent current stays off the clean rail
    (D-31). Feeding both pins from one rail 1.5 V above the output would
    dissipate 1.5 W, too much for the DFN package.
  - Dissipation on the current curve of R-08 (calculated; 40 °C ambient, 64 K/W
    to 68 K/W from the datasheet): highest at 0.8 V and 1.0 A, 0.82 W typical
    and 1.02 W worst case, junction 93 °C and 110 °C; lowest at 5.0 V and 0.6 A,
    0.34 W and 0.45 W.
  - Short circuit: the pre-regulator follows the collapsed output down to about
    0.8 V (simulated 0.84 V), so the regulator takes 1.5 W to 2.0 W with its
    control current counted (calculated) and not the full input voltage times
    its current limit. The over-current trip of section 4.4 opens the output
    switch. In a short that lasts ahead of that switch the regulator runs at its
    own thermal limit, which its datasheet allows for an indefinite time.
  - Clamps (D-57). The datasheet rates the IN pin and the VCONTROL pin at −0.3 V
    relative to the output. D11, a Schottky diode from the output to the IN
    pin, holds the IN pin 0.15 V to 0.18 V below the output while the
    pre-regulator is disabled and the output is alive (simulated). One diode of
    D10 sits in the VCONTROL feed behind R61 (10 Ω), with C47 (1 µF) at
    the pin: at power-off the capacitor keeps the pin at least 0.88 V above the
    output while the +13.5 V rail falls (simulated). D12, a Schottky diode
    from ground to the output, holds the output at about −0.2 V (estimate) in
    the states in which the minimum load would pull it below ground: VCONTROL
    absent while −4 V_A is present, or the SET pin driven below ground.
  - Minimum load: R69, 1.3 kΩ in 0805 from the regulator output to −4 V_A,
    draws 3.7 mA at 0.8 V and 6.9 mA at 5.0 V (calculated). The datasheet asks
    for 0.5 mA at 10 V and 1 mA at 25 V; the rest absorbs the leakage of D11,
    up to 2 mA at 100 °C (datasheet value), which flows into the output where
    the regulator cannot take it away. The resistor sits before the shunts, so
    it is not measured. Without −4 V_A a 0.8 V set-point gives 0.8 V with a
    typical regulator and 0.87 V to 1.17 V at the limits (calculated); PWR_GOOD
    watches that rail (section 4.11) and firmware opens the output on its loss
    (F-7).
  - Output capacitor at the regulator, before the shunts: C53, 22 µF (13.6 µF
    at 5 V, typical bias curve of the maker), with C54 (100 nF). It sets how
    fast a released output falls: 0.7 V/ms to 0.8 V/ms at 5 V (calculated), slow
    enough that the pre-regulator returns 0.12 W to 0.20 W to the 5 V rail for
    about 5 ms (simulated). That is less than the instrument takes from the rail
    in source mode without load (0.54 W to 0.60 W, estimate); the condition is
    0.25 W or more and is an open check of section 16. After the shunts keep the
    capacitance on VOUT at or below 100 nF (C0G, C71), because its charging
    current is measured as DUT current.
  - Noise: in source mode the noise of the regulator, divided by the shunt, is
    measured as current. In R0 that is 26 nA to 27 nA RMS at full bandwidth with
    a typical regulator, against about 2.1 nA from a quiet external supply in
    ampere mode (both simulated with typical datasheet figures). Section 11
    states the pass level of R-04 per mode (D-59).
- Pre-regulator: buck-boost converter (candidate: TPS63020, U16) from the 5 V
  rail with L2 (1.5 µH), in forced PWM at 2.4 MHz (datasheet value). The
  tracking is analog, with no firmware in the loop, and it follows the output of
  the linear regulator, not the set-point (D-55). A difference amplifier (U19
  with the 0.1 % resistors R63 to R68) drives the feedback pin
  with 0.200 × V_PRE + 0.146 × VREF − 0.191 × V_LDO, where V_LDO is the output
  of the linear regulator, and the converter holds that at its 0.5 V reference
  (calculated):

  ```text
  V_PRE = 0.672 V + 0.956 × V_LDO
  ```

  - Reason for following the output: the linear regulator cannot sink
    current. When the set-point falls with a light load, or a DUT holds the
    output up, the output stays high; a pre-regulator that followed the
    set-point would pull the IN pin volts below the output. With this law
    the IN pin stays at least 0.44 V above the output on a full-scale
    set-point step down (simulated).
  - Sense path: R65 (6.65 kΩ) and C55 (100 nF), with R64 (93.1 kΩ) as
    their load, are a low-pass of 0.62 ms (calculated), and one diode of
    D13 lies across R65. The pre-regulator therefore follows a rise of
    the output at once and a fall slowly. The slow fall keeps the
    converter from returning the charge of its output capacitors to the
    5 V rail when a short circuit empties the regulator output; the fast
    rise does the same when a charged DUT lifts the output.
  - Loop: C52 (10 pF) across the feedback resistor R63 gives the
    amplifier a phase margin of 73° to 77° (simulated with the model of its
    maker). The loop of the converter with this amplifier shows 55° or
    more (simulated with a behavioral model whose compensation is an
    assumption): a risk prototype settles it before revision A is ordered
    (sections 13 and 16; proof-of-concept boards of draft A2 may be
    ordered ahead of it, D-105).
  - Range: the converter output covers 1.2 V to 5.5 V and its over-voltage
    protection starts between 5.5 V and 7 V (datasheet values). The law reaches
    5.5 V at an output of 5.05 V (calculated), which limits the set-point to
    5.0 V; firmware enforces 0.80 V to 5.00 V (F-30).
  - Output: C42, C45 and C50 (three times 22 µF, 38 µF left at 5.5 V by
    the typical bias curve) and the bleeder R62 (1 kΩ). A converter in
    forced PWM that is enabled with its output capacitors charged above
    its target returns that charge to the 5 V rail, and the input stage of
    section 4.1 cannot absorb it. The bleeder empties the capacitors in
    about 0.2 s after the converter is disabled (calculated; no rise of
    the 5 V rail after 100 ms off in simulation).
  - Filter toward the regulator: the ferrite bead FB1 (1.6 mΩ maximum,
    datasheet value), C46 (10 µF) and the damper C43 (22 µF) in series
    with R59 (0.33 Ω) at the IN pin. The source impedance at the IN pin is
    0.27 Ω to 0.37 Ω with the damper (simulated). The LDO rejects the remaining
    ripple. The copper from the converter capacitors to the bead is held to
    15 mΩ or less (section 10): every 10 mΩ more costs 6 mV of headroom at
    0.6 A.
- Enable: the enable pin of the pre-regulator has R53 (1 kΩ) to ground and is
  driven by the controller line SMU_ON through Q1, whose gate is the output
  5V_OK of the supervisor of section 4.1 (D-48). The converter runs only while
  the controller asks for it and the 5 V rail is valid, so a collapsing rail
  sheds the source without firmware. With the rail at 4.25 V the pin still
  reaches 2.36 V, and 1.96 V at the lowest supervisor threshold (calculated; the
  gate threshold of the transistor is an estimate), against a threshold of 1.2 V
  (datasheet value). After its hold-off of 180 ms to 420 ms (datasheet values)
  the supervisor enables the converter again if the controller still asks for
  it; the bleeder has emptied the capacitors by then. The linear regulator has
  no enable: with the pre-regulator off it runs from VCONTROL alone, follows the
  set-point and supplies only the milliamperes of its control path (simulated).
- Voltage Control (DAC): MCP4921-E/SN (U15, 12-bit, SPI) at gain 2, with its
  reference input in buffered mode on VREF / 2 = 1.25 V from the divider R55,
  R56 (2.00 kΩ, 0.1 %) (D-58). Its output spans 0 V to 2.5 V. A buffer
  amplifier with gain 2.1 (U17, R57, R58), powered from +12 V_A and
  −4 V_A, drives the SET pin through R60 (1 kΩ). The output is the SET drive
  plus about 10 mV, the SET pin current in that resistor (datasheet value):
  0.03 V to 5.26 V in 1.28 mV steps, nominal codes 616 for 0.80 V and 3893 for
  5.00 V (calculated; code 0 gives 30.96 mV, because the swing of the DAC
  ends above ground, simulated on 2026-10-10). R60 also limits the current of the
  clamp between the SET pin and the output of the regulator when a DUT
  holds the output above the set-point: 3.453 mA with 5.0 V on a set-point
  of 0.80 V, against 10 mA at the most (simulated on 2026-10-10; datasheet
  value).
  - Ceiling: the DAC cannot deliver more than twice its reference input,
    so no SPI frame can command more than 5.26 V nominal and 5.39 V at
    the tolerance limits (calculated); a wrong gain bit halves the output.
    The ceiling is below the 5.5 V that the level translator of
    section 4.8 accepts. The DAC and its reference run from 3V3_A and
    VREF, so the range does not depend on the 5 V rail.
  - Set-point filter: R54 (10 kΩ) with C41 (1 µF), 10 ms. After a
    full-scale step the set-point moves at 0.52 V/ms at most (calculated).
    A set-point step then makes the pre-regulator return at most 0.27 W
    to the 5 V rail for some milliseconds (calculated bound; 0.06 W
    simulated), and a DUT of up to 2300 µF cannot reach the over-current
    trip through a set-point step (calculated).
  - Temperature: the two resistor pairs R55, R56 and R57, R58 are
    25 ppm/K parts; if a pair drifts apart the output moves by up to 5 mV per
    pair at 5 V over 40 K (calculated). The parts of a pair are placed side by
    side. The set-point calibration uses nine points or more at room temperature
    (F-30).
  - After a hold-off of the supervisor the DAC wakes with a high-impedance
    output and C41 still holds 44 % to 70 % of the last value (calculated).
    Firmware writes the DAC before anything else when PWR_GOOD returns (F-3).
- Output current (R-08, D-56): 1.0 A up to 2.0 V, falling in a straight line to
  0.6 A at 5.0 V. The limit is the headroom at the IN pin: the converter ends at
  5.5 V, and the dropout of the regulator rises with the current. Its datasheet
  guarantees two points, 200 mV at 100 mA and 500 mV at 1.1 A; the need in
  between is taken on the straight line 170 mV + 0.300 Ω × I, which is an
  estimate. All other figures of the table are calculated; the margin counts
  every tolerance, 25 ppm/K over 40 K, and the line and load regulation of the
  converter.

| Output | Current of the curve | V_PRE, nominal | Headroom, nominal | Dropout need | Margin, worst case |
| --- | --- | --- | --- | --- | --- |
| 0.8 V | 1.00 A | 1.437 V | 637 mV | 470 mV | 85 mV |
| 2.0 V | 1.00 A | 2.584 V | 584 mV | 470 mV | 25 mV |
| 3.3 V | 0.83 A | 3.827 V | 527 mV | 418 mV | 15 mV |
| 5.0 V | 0.60 A | 5.452 V | 452 mV | 350 mV | 2 mV |

- Up to about 1.9 V the curve also holds against the guaranteed 500 mV
  (55 mV to spare at 0.8 V, 5 mV short at 2.0 V, calculated); above that
  it rests on the interpolation. The curve is therefore a design figure
  until the sweep of section 11 is done on several boards. A typical
  regulator delivers 1 A at every set-point with nominal headroom; with
  the lowest headroom it delivers 0.99 A at 5.0 V and 125 °C (calculated).
  The curve needs 4.3 W typical and 4.9 W at the limits from the 5 V rail,
  and 5 V at 1 A needs 6.7 W to 7.6 W (calculated; section 4.1 has the
  budget per source). The PPK2 states 600 mA in source mode and 5 W; the
  curve is at or above that at every voltage.
- Beyond the curve the regulator is in dropout and the output sags by 10 to 22
  times the missing headroom, up to 0.6 V, because the pre-regulator follows the
  sagging output (simulated on 2026-10-10: 4.729 V into 5 Ω at a 5.0 V
  set-point with a regulator at the guaranteed dropout, 4.858 V with a
  typical regulator). With a
  constant-power DUT the state feeds itself: the output collapses and restarts.
  Firmware reports an overload and opens the output switch when the VOUT monitor
  reads more than 0.3 V below an unchanged set-point for 20 ms (F-32).
- Voltage changes are ramped by firmware (default 1 V/ms). The protection
  against in-rush does not rest on that ramp: the set-point filter bounds the
  slope in hardware and the output switch closes with its own ramp. A set-point
  counts as settled when three consecutive monitor readings are inside the band
  (F-30), not after a fixed time: without load the output falls only as fast as
  the minimum load empties the output capacitor.
- Output sag: the regulator senses its own output, ahead of the shunts and
  switches, so the DUT sees up to 200 mV less at 1 A (R-06; 144 mV typical
  in source mode, calculated). A slow firmware loop (about 10 Hz, using
  the VOUT monitor) may trim the set-point; it is optional and off by
  default.
- Start and stop of the source (F-28 and F-29 of section 6.6). Start, with
  PWR_GOOD high, every switch open and SMU_ON low: DAC to the 0.80 V code;
  200 ms, in which the regulator runs from VCONTROL alone and brings the
  capacitors of the pre-regulator to its output voltage; SMU_ON high; 5 ms; DAC
  to the working value, 80 ms; range 3 and the source pair; after 60 ms the VOUT
  monitor within 100 mV of the set-point, else a fault; the output switch last.
  Stop: output switch, source pair, SMU_ON low, DAC to zero. SMU_ON never goes
  low while a path from the regulator to a DUT is closed.
- Mode switch: back-to-back N-MOSFET pairs select the LDO (source mode, Q4,
  Q8) or the VIN input (ampere mode, Q5, Q9); both off at reset. The
  text names each back-to-back pair by its function: the source pair and the
  ampere pair are the two mode switches, and the output pair is the output
  switch. Each pair closes as a source follower behind its gate network, 100 kΩ
  and 100 nF (D-61): the gate rises with 10.7 ms (calculated) and the supply
  node of the ladder with about 0.9 V/ms (simulated); a pair counts as closed
  40 ms after its request (F-24). It opens through a diode within 1 µs
  (simulated: the current is below 10 % after 0.1 µs to 0.3 µs), and a
  transistor at its gate holds it open while its common source is below ground.
  A transistor driven by the source-mode request holds the input of the ampere
  driver low, so both pairs can never be closed together (D-62).
  Break-before-make follows from the slow closing and the fast opening; firmware
  leaves 5 ms between lowering one request and raising either, and changes mode
  with the output switch open (F-23). Section 4.9 describes the gate networks
  and the interlock.
  - The gate lines are separate from the gate line of the output switch,
    so the selected pair closes without the output switch: the zero
    calibration then runs with the ladder at its real voltage and no load
    (D-29).
  - With the output switch open the supply node of the ladder keeps its voltage
    after a pair opens and falls with 0.57 s only (R90, 100 kΩ, with the
    5.7 µF of section 4.3; calculated). Closed onto a lower voltage, the ampere
    pair would push that charge into the supply of the user: 3.1 V on a 0.8 V
    supply with 4.7 µF (calculated). Firmware therefore raises the ampere
    request only when the VOUT monitor reads below the VIN monitor plus 0.1 V,
    or below 0.3 V, and reports a fault after 3 s without that (F-25).
- Output switch: back-to-back N-MOSFET pair at VOUT (Q15, Q16), off at
  reset, opened by hardware on a fault (D-71). It closes as a source follower
  behind R117 (2.2 MΩ) and C74 (10 nF): the output rises with 0.44 V/ms,
  falling to 0.21 V/ms near 5 V, and reaches 90 % after about 20 ms at 5.0 V
  (simulated). With 100 µF it is at 10 % of its voltage 6.458 ms after the
  request at 5 V and 5.381 ms at 0.8 V; over the corners the start spans
  from 3.888 ms, the first 50 mV at 0.8 V in the fast corner, to 10.03 ms,
  10 % at 5 V into 2200 µF in the slow corner (simulated on 2026-10-10).
  That limits the
  in-rush in both modes, with the trip armed and no blanking: 0.39 A into
  1000 µF and 0.85 A into 2200 µF at 5 V, and about 2200 µF nominal is the
  largest DUT capacitance that starts without a trip (simulated); 1800 µF is the
  figure for a capacitor with a tolerance of 20 % (section 11). The output
  switch is the last switch to close and the first to open (F-23). It opens
  through one diode of D20 and R116 (220 Ω): the gate is below 2 V within
  7 µs at 5 V, 6.258 µs to 6.833 µs over the runs, and after 7.274 µs to
  8.109 µs at 0.8 V (simulated on 2026-10-10), slowly enough for the pair
  to absorb the energy of the
  supply leads at a trip. After the turn-off the gate rests at a diode drop and
  decays with 31 ms (calculated), and a transistor with a low threshold passes
  microamperes meanwhile (simulated): readings with the output open are taken
  200 ms or more after it opened (F-36). R120 (10 Ω) at the gate pins damps
  the follower phase, and R115 (100 kΩ) on the driver side holds the gate low
  while the driver has no supply. No resistor goes from the gate to ground or to
  the common source: it would divide the gate voltage with the 2.2 MΩ.
  - For 250 ms after the switch closes the samples read low by the
    charging current of the gate (0.5 µA at 30 ms, 4 nA at 200 ms,
    simulated). The host marks these samples (sections 8 and 9).
- Slow monitors: an external 8-channel, 12-bit SPI converter (candidate:
  MCP3208, U40) on the SPI bus of the DAC, with VREF as its reference, reads
  eight channels at 100 SPS (D-80, F-10). The internal ADC of the controller is
  not used: an external converter is the more accurate one, has eight channels
  and shares the SPI bus of the DAC (section 5). All scale factors are
  calculated from the nominal resistor values.

| Channel | Signal | Scale at the converter |
| --- | --- | --- |
| 0 | Ladder output, buffered (VOUT monitor) | × 0.4545 |
| 1 | VIN, behind the fuse | × 1/44, for −20 V to +20 V at the terminal |
| 2 | 5 V rail, with the source tag | × 0.4545 on USB-C, × 0.2524 on the module input |
| 3, 4 | CC1, CC2 | × 1 behind 10 kΩ |
| 5 | Board temperature sensor U39, next to the LDO | × 1 behind 1 kΩ |
| 6 | +12 V_A | × 0.1754 |
| 7 | −4 V_A, against VREF | 0.333 × V + 1.667 V |

- The status output of the input multiplexer of section 4.1 switches a resistor
  into the divider of channel 2, so one channel reads the rail and tells which
  input supplies it: the bands are 1.93 V to 2.50 V with USB-C in use and 1.07 V
  to 1.39 V with the module input in use, and firmware separates them at 1.67 V
  (calculated; F-11). With the resistors at their limits the bands are
  1.911 V to 2.527 V and 1.057 V to 1.409 V (simulated on 2026-10-10): on
  USB-C the channel is at the full scale of the converter, 2.5 V, from
  about 5.44 V of the rail (calculated from that figure), which is an
  open point of section 16.
- The inputs of the monitor converter leak 1 nA typical and 1 µA at the
  most (datasheet value). At that maximum the reading of channel 0 is off
  by 120 mV, that of channel 1 by 430 mV and that of channel 2 by 120 mV
  (simulated on 2026-10-10). The limits of F-26 and F-28 do not hold these
  errors, which is an open point of section 16.
- The VOUT channel has a source resistance of 54.5 kΩ and a filter of 5.5 ms
  (calculated); at 100 SPS the charge step of the converter costs 0.97 LSB,
  1.3 mV at VOUT, and at 1 kSPS 4.9 LSB (calculated). Rule F-33 for an external
  voltage on the source output (section 4.9) asks for a reaction within 0.5 ms.
  While the source output is on, firmware therefore reads this channel more
  often, as the exception of F-10 allows; those readings carry the larger error
  and serve the comparison with 5.3 V alone. The filter of 5.5 ms stays in front
  of them: the rule covers a voltage that rises slowly and not a step.

### 4.3 Shunt Ladder

Two shunts cannot cover seven decades: 10 mA in a 100 Ω shunt drops 1 V and
saturates a fixed-gain amplifier. Use four ranges, each limited to 100 mV,
with a fixed gain of 20 into a 2.5 V ADC full scale (23 % headroom: with the
gain of 19.93 and the pedestal of section 4.5 the converter reads full scale
at 122.9 mV across the shunt, calculated).

| Range | Shunt | Full scale | Resolution (1 LSB) | Switch up above | Switch down below |
| --- | --- | --- | --- | --- | --- |
| R0 | 1 kΩ | 100 µA | 1.9 nA | 91 µA | (lowest range) |
| R1 | 33 Ω | 3 mA | 60 nA | 2.85 mA | 60 µA |
| R2 | 1 Ω | 100 mA | 1.9 µA | 91 mA | 1.8 mA |
| R3 | 0.1 Ω | 1 A | 19 µA | 1.15 A (trip) | 60 mA |

The resolution and the switch-up levels are calculated from the gain, the
step-up threshold of 90.95 mV and the trip threshold of 115 mV (section
4.4). R0 stays in parallel with the active shunt: R1 measures with 31.95 Ω,
which the figures of its row include. The switch-down levels are firmware
thresholds.

- Shunt resistors (D-68), all candidates. R0 R101: 1 kΩ thin film, 0.1 %,
  25 ppm/°C, 0805. R1 R104: 33 Ω thin film, 0.1 %, 25 ppm/°C, 0805, rated
  0.1 W. R2 R107: 1 Ω thin film, 0.5 %, 25 ppm/°C, a two-terminal 1206
  chip on a four-pad Kelvin land pattern; each end cap bridges the force
  pad and the sense pad of its end. R3 R110: 0.1 Ω, 0.25 %, 50 ppm/°C, a
  four-terminal part with a single source. Tolerances and temperature
  coefficients are datasheet values.
  - The tolerance is removed by the per-range gain calibration (R-12,
    section 8); the temperature coefficient is what the error budget
    counts. For R3 that is 0.10 % over 20 K (calculated) plus 0.055 % of
    self-heating at 1 A (estimate).
  - The end caps of R2 are inside its measurement: about 0.1 % of 1 Ω with
    the drift of copper, about 4 ppm/°C of the range (estimate).
  - Dissipation (calculated): 23 mW in R2 at the jump level of 151 mV and
    0.14 W in R3 at 1.19 A, against ratings of 0.27 W and 0.5 W (datasheet
    values).
- Topology: parallel branches between the supply node and the node after
  the shunts, which the output switch connects to VOUT. Each switched
  branch is a MOSFET on the supply side followed by its shunt; the junction
  between them is the sense node. R0 has no switch and is always in
  circuit. The supply node has the test point TP33.
- Supply node: 1 µF C62 and a damped branch of 4.7 µF C63 in series
  with 0.47 Ω R87, ahead of the shunts (D-63). They take the current of
  the supply leads when the trip opens the output in ampere mode, so that
  the node stays below 11.5 V, under the +12 V_A supply of the multiplexer
  (simulated). Behind 0.5 µH to 1 µH of supply lead they also limit the sag
  of the node after a 500 mA step to 0.17 V to 0.21 V (simulated).
- Idle level: 100 kΩ R90 from the supply node to ground, the only resistor
  from that node to ground (D-63). With every path switch open the ladder
  rests at 0 V, below 0.3 V with every blocking MOSFET at its leakage limit
  (calculated), and the amplifier inputs have their bias return. The resistor
  is ahead of the shunts: its current, 50 µA at 5 V, is not measured; in
  ampere mode it comes from the external supply. Once the path switches are
  open the node falls with a time constant of 0.57 s (calculated); the rule
  for closing the ampere switch that follows from it is in section 4.2
  (F-25).
- Node after the shunts: it carries the 100 nF C0G capacitor C71 and
  the 10 kΩ resistor R114 into the buffer of D-32, and nothing resistive
  to another potential (section 4.2).
- One-hot selection: only one switched branch is on at a time. The current
  through R0 in parallel is then about 3 % in R1 and is part of the
  calibrated gain. A thermometer scheme (all lower branches on) is rejected:
  the current split would depend on the MOSFET on-resistance and drift with
  temperature.
- Make-before-break: when changing range the new branch turns on about 1 µs
  before the old one turns off, so the DUT is never left on R0 alone (F-17).
- Range switches: N-channel MOSFETs, Q12 for R1 and Q13 for R2 in
  SOT-23 and Q14 for R3 in a 3.3 mm power package (candidates). Switch
  and shunt of R3 together drop 105 mV to 107 mV at 1 A (calculated). The
  gates are driven from +12 V_A by the gate drivers U22 and U23
  through 47 Ω (R102, R105) and 10 Ω (R108); test points TP34 to
  TP36 are on the gates.
  - There are no gate-to-source resistors: on a branch that is off such a
    resistor would draw its current through a shunt. Each range gate has
    100 kΩ to ground instead (R103, R106, R109; D-67): it holds the switch
    open without a driver and draws its 120 µA from the driver, not through
    a shunt.
  - Each driver input has 1 kΩ in series at the driver (R96 to R99) and
    1 kΩ to ground on the controller side (R88, R89, R93, R94). The inputs are
    rated for the driver supply plus 0.3 V (datasheet value); the series
    resistor limits the current to 2.7 mA, 2.9 mA at the tolerance limits,
    when a line is high while +12 V_A is absent (calculated).
  - The IRLML6402 P-MOSFET driven by a GPIO does not work here: with the
    rail at 0.8 V there is no gate drive to turn it on, with the rail at
    5 V a 3.3 V GPIO cannot turn it off, and its 65 mΩ is comparable to
    the 0.1 Ω shunt.
- Kelvin sensing: the amplifier measures across the shunt element only. A
  low-leakage dual 4:1 analog multiplexer U24 (candidate: MUX509)
  selects both sense taps of the active shunt, the positive and the
  negative one (D-27). The switch resistance and the copper between the
  shunts therefore add burden but no measurement error.
  - Address 0 selects R0, sensed between the supply node and the node
    after the shunts; address 1 the sense node of R1 and the node after
    the shunts; addresses 2 and 3 the two Kelvin pads of R2 and of R3.
  - The multiplexer runs from +12 V_A and −4 V_A. Its enable input is
    pulled up to +12 V_A through 10 kΩ R113, so it never stands above its
    own supply (D-67); the multiplexer is therefore on whenever its rails
    are.
  - Each address input has 1 kΩ in series at the multiplexer (R112,
    R111) and 5.1 kΩ to ground on the controller side (R95, R91):
    range 0 is selected while the controller pins float or the sockets are
    empty (D-67).
  - The on-resistance at +12 V and −4 V is not in the datasheet, which gives
    125 Ω typical at ±15 V and 235 Ω typical, 340 Ω at most at 12 V
    (datasheet values). The simulations sweep 125 Ω to 430 Ω (estimate); the
    resistance sets the delay of the sense path (section 4.5).
- Ladder clamp (D-66): two MOSFETs of the type of the R1 switch in
  parallel, Q10 and Q11, each with its gate tied to its drain on the
  supply node through 22 Ω (R92, R100) and its source on the node
  after the shunts. They conduct when the ladder voltage passes their
  threshold: 1.3 V to 2.3 V at 25 µA (datasheet value), 2.5 V to 3.5 V at
  amperes (read from a typical curve). They carry the surge of a hot plug
  or a short circuit until range 3 conducts and bound the ladder at about
  4 V, so that the shunts stay inside their pulse ratings; below the
  threshold each is an off MOSFET like the range switches. Their body
  diodes carry the pulse when a charged DUT is connected to a lower output
  voltage.
  - Hot plug of 100 µF or a short circuit, worst delays (simulated on
    2026-10-10): 7.235 A in each part with both at the same threshold,
    12.16 A in one part when their thresholds are at opposite limits, and
    19.26 A in the worst combination, a short circuit at 5.5 V through
    20 nH with the thresholds at opposite limits; ladder at most 3.822 V.
    A hot plug holds a part above 5 A for 285.6 ns at the most. In a short
    circuit from a supply that holds its voltage, a part with a low
    threshold carries more than 5 A until the trip has opened the output,
    for up to 14.79 µs. The pulsed rating is 21 A (datasheet value). The
    spread of the clamp at amperes is an assumption, and in source mode,
    where the regulator limits its current, these figures are an upper
    bound.
  - A capacitor charged to 5.0 V to 5.5 V connected to an output at 0.8 V:
    10.8 A to 12.5 A in each body diode for about 2 µs, against the same
    21 A. These figures are estimates: the simulation had less capacitance
    behind the source switch than the board.
  - R3 carries up to 29.52 A for microseconds in the same events, and
    32.33 A with a short circuit across the terminals (5 mΩ and 50 nH),
    above the 14.1 A and 20 A its datasheet gives for 10 ms. That is
    accepted on the energy, 1.36 mJ in a hot plug and 2.609 mJ with the
    short circuit across the terminals, against 200 mJ (simulated on
    2026-10-10; the 200 mJ calculated), and checked by the pulse series of
    section 11.
  - The two parts do not share a sustained current: one carries nearly all of
    it and would heat by 104 K at 3 A and by 144 K at 4 A in 5 ms
    (calculated). The clamp is a surge path only; section 4.4 has the rule
    that keeps a load current out of it (F-21).
  - The clamp is not part of the R-07 budget: with 470 nF or more at the
    DUT it never conducts on a load step (simulated).
- Leakage budget (D-66, D-59), in two parts, because the two kinds of
  leakage act differently:
  - Offset part: everything that loads VOUT or a sense node from another
    potential (multiplexer, amplifier bias current, guard buffer, terminal
    suppressor, output switch, gate oxide of the range switches). The
    design figure is 10 nA at 40 °C as a typical value; the sum of the
    typical figures is 4 nA to 6 nA at 40 °C and 5 V (estimate). No part on
    that node has a guaranteed leakage of this size, so each board is
    measured with the output on and the terminals open at 5.0 V, with a
    limit of 50 nA at room temperature, and the value is subtracted
    (section 8). The zero calibration removes the constant part; what
    stays is the drift.
  - Gain part: leakage across the ladder (drain to source of the three off
    range switches and of the two clamps, gate oxide of the clamps). It flows
    only with a burden voltage, is zero at zero current and acts as a
    resistance in parallel with the active shunt. The limit is 100 nA in
    total at 100 mV and 40 °C; no datasheet figure bounds the leakage of the
    five MOSFETs at this voltage (their limit is stated at 24 V), so the
    measurement of section 16 decides. At the limit the error is 0.1 % of
    reading at the full scale of R0 and at most 0.4 % at small currents
    (estimate); the gain calibration removes it at the calibration
    temperature. The clamp stays a candidate until the leakage of the whole
    ladder is on record (section 16).
  - Gate leakage of the range switches appears as an offset and is removed
    by the zero calibration.
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
