Guiimartinho/open-power-profiler/docs/firmware/architecture.md

# Firmware Architecture

How the firmware is divided, what runs where, and how data moves from the
converter to the host. It refines section 6 of
[the specification](../specification.md) and changes nothing in it. This
is a design: nothing here is built or measured, and every figure that is
not quoted from the specification is an estimate.

## Languages and Tools

| Part | Language | Reason |
| --- | --- | --- |
| Everything that runs on the processors | C11, built with CMake and the Pico SDK | Sections 6 and 18.1 of the specification; the existing core and its tests are C11 |
| Acquisition, range sequencer, over-current trip | PIO programs | They act in every cycle of the 150 MHz clock, whatever the processors do (D-40) |
| Protocol generator, host package, tools | Python | They run on the PC only |

No interpreter runs on the controller: the sample rate, the USB throughput
and the reaction times of section 6.6 leave no room for one.

## Layers

```mermaid
flowchart TB
    main["main: composition root<br/>creates adapters, injects them, starts both cores"]
    app["app: device state machine, command handlers,<br/>timed sequences, fault manager, supervision"]
    subgraph services["Service components: pure logic behind ports"]
        acq["acq"]
        afe["afe"]
        smu["smu"]
        monitor["monitor"]
        cal["cal"]
        link["usb_link"]
    end
    proto["proto: frames, sample word, commands"]
    base["base: status codes, bytes, block queue, clock, events"]
    adapters["Adapters: Pico SDK, TinyUSB, PIO programs"]
    main --> app
    main --> adapters
    app --> services
    services --> proto
    proto --> base
    adapters -. implement the ports of .-> services
```

- Dependencies point downward. `base` and `proto` are usable by all.
  Among the service components only `app` calls across them, and only
  `cal` writes flash (section 6.1).
- Every component keeps its pure sources in `src/`, compiled for the PC
  and for the target from the same files, and its adapters in `port/`,
  compiled for the target only. Pure code includes no SDK header,
  allocates nothing and keeps its state in structures the caller owns.
- Only `main` knows both sides. It creates the adapters and hands them to
  the pure code as ports.

## Components

| Component | Pure logic | Adapter |
| --- | --- | --- |
| `base` | Status codes, byte order, block queue, time arithmetic, event flags, the pin table with its checks (F-4, F-5) | Clock from the system timer |
| `proto` | Frame codec and parser, sample word, stream payload, command envelopes (exists) | None |
| `acq` | Split of the raw word into result and side bits, sample word assembly, settling window, over-range and under-range marks, step-down rule, decimation, the block builder | Capture program in PIO 0, DMA ring, the loop of core 1 |
| `afe` | Transition tables of the range sequencer, range lock policy, the checks around the trip (F-19 to F-21), mode and output requests with their times (F-23 to F-27) | Sequencer in PIO 1, trip in PIO 2, the mode request pins, the two interrupt handlers |
| `smu` | DAC frame (F-6), set-point in codes (F-30), the rules F-31 to F-33 | SPI to the DAC, the enable pin |
| `monitor` | Scan schedule, scale of the eight channels (F-10, F-11), rails test (F-12), CC class (F-13), budget (F-14), thermal limit (F-15) | SPI to the monitor converter, the monitor timer |
| `cal` | Calibration record with version, identity and CRC; nominal fall-back; zero calibration (section 8, F-36) | Flash sector, chip identifier |
| `usb_link` | Transmit scheduler: responses and events before stream frames, one frame at a time | TinyUSB CDC ACM, host-open detection |
| `app` | Device state machine, command handlers, timed sequences (start, self-test, DUT power, source start and stop), fault manager, supervision, status record | Watchdog, LED, console |

## Ports

A port is a structure of function pointers with a context pointer, declared
by the component that needs it. The adapter implements it for the board, a
fake implements it for the tests, and `main` injects it.

| Port | Declared in | What the pure code asks | Fake in the tests |
| --- | --- | --- | --- |
| Clock | `base` | Time in microseconds since start | A clock that the test advances |
| Carrier pins | `afe` | Release every pin; drive SMU_ON, the two mode requests and the chip selects; read PWR_GOOD and VIN_OV | Records every write with its time |
| Sequencer | `afe` | Start and stop the programs; write the transition table; ask for one step down; force range 3; read the range lines | Model of the rules, or the real program in the emulator |
| Output and trip | `afe` | Ask for the output on with the qualification time; force it off; read and clear the trip latch | Same |
| Capture | `acq` | Start and stop; how many raw words wait; where they are; overrun flag | Recorded raw words |
| Range requests | `acq` | One step down; range 3 at once (called from core 1) | Counts the calls |
| Slow bus | `monitor`, `smu` | One transfer to the monitor converter or to the DAC | Model of both parts |
| Flash | `cal` | Read the record; erase and write it | A sector in memory |
| Identity | `cal` | The 64-bit chip identifier | A constant |
| Watchdog | `app` | Enable; reload; did it cause this start | Records the reloads |
| Link | `usb_link` | Bytes in, bytes out, room in the transmit buffer, host open | A pipe in memory |

The existing `pp_afe_port_t` has six calls and predates draft A2. The
ports above replace it.
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
