Guiimartinho/open-power-profiler/hardware/fabrication/draft-a2/gerbers/drill-report.txt

Drill report for power-profiler-carrier.kicad_pcb
Created on 2026-10-13T22:17:42

Copper Layer Stackup:
    =============================================================
    L1 :  F.Cu                      front
    L2 :  In1.Cu                    in1
    L3 :  In2.Cu                    in2
    L4 :  B.Cu                      back

Drill file 'power-profiler-carrier-PTH.drl' contains
    plated through holes:
    =============================================================
    T1  0.300mm  0.0118"  (594 holes))
    T2  0.300mm  0.0118"  (16 holes))
    T3  0.400mm  0.0157"  (100 holes))
    T4  0.600mm  0.0236"  (4 holes)  (with 4 slots)
    T5  1.000mm  0.0394"  (57 holes))
    T6  1.100mm  0.0433"  (4 holes))
    T7  1.200mm  0.0472"  (8 holes))
    T8  3.200mm  0.1260"  (4 holes))

    Total plated holes count 787

Drill file 'power-profiler-carrier-NPTH.drl' contains
    unplated through holes:
    =============================================================

    Total unplated holes count 0
