Guiimartinho/open-power-profiler/docs/firmware/pio-programs.md

# PIO Programs

The three programs that act without the processors: the capture of the
converter, the range sequencer and the over-current trip (D-40 of
[the specification](../specification.md)).

Status: sketches. On 2026-10-12 the four listings were assembled with
`pioasm` 2.3.1 of the Pico SDK, as programs of PIO version 1, with the
directives of the table below: the assembler accepts them, and the
instruction counts are the ones of the allocation table. That shows
their syntax and their size and nothing about their behavior: none has
run in an emulator or on a controller, and they are not in the firmware
tree yet. They enter it with the emulator tests. A clock is one cycle of
the 150 MHz system clock, 6.67 ns.

## Allocation

| Block | State machine | Program | Outputs | Inputs | Instructions |
| --- | --- | --- | --- | --- | --- |
| PIO 0 | 0 | Capture | GP19 ADC_SCK, GP20 ADC_CNV, GP21 SIDE_LOAD | GP16 ADC_DOUT, GP17 SIDE_DOUT | 10 of 32 |
| PIO 1 | 0 | Range sequencer | GP2 to GP6: three range gates, two address lines | GP8 CMP_UP, GP9 CMP_JUMP | 30 of 32 |
| PIO 2 | 0 | Output and trip | GP7 GATE_OUT | GP10 CMP_OC, GP4 GATE_R3 | 12 of 32 |
| PIO 2 | 1 | Supply guard | GP7 GATE_OUT | GP28 PWR_GOOD | 3 of 32 |
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
