Guiimartinho/open-power-profiler/hardware/doc/schematic.pdf

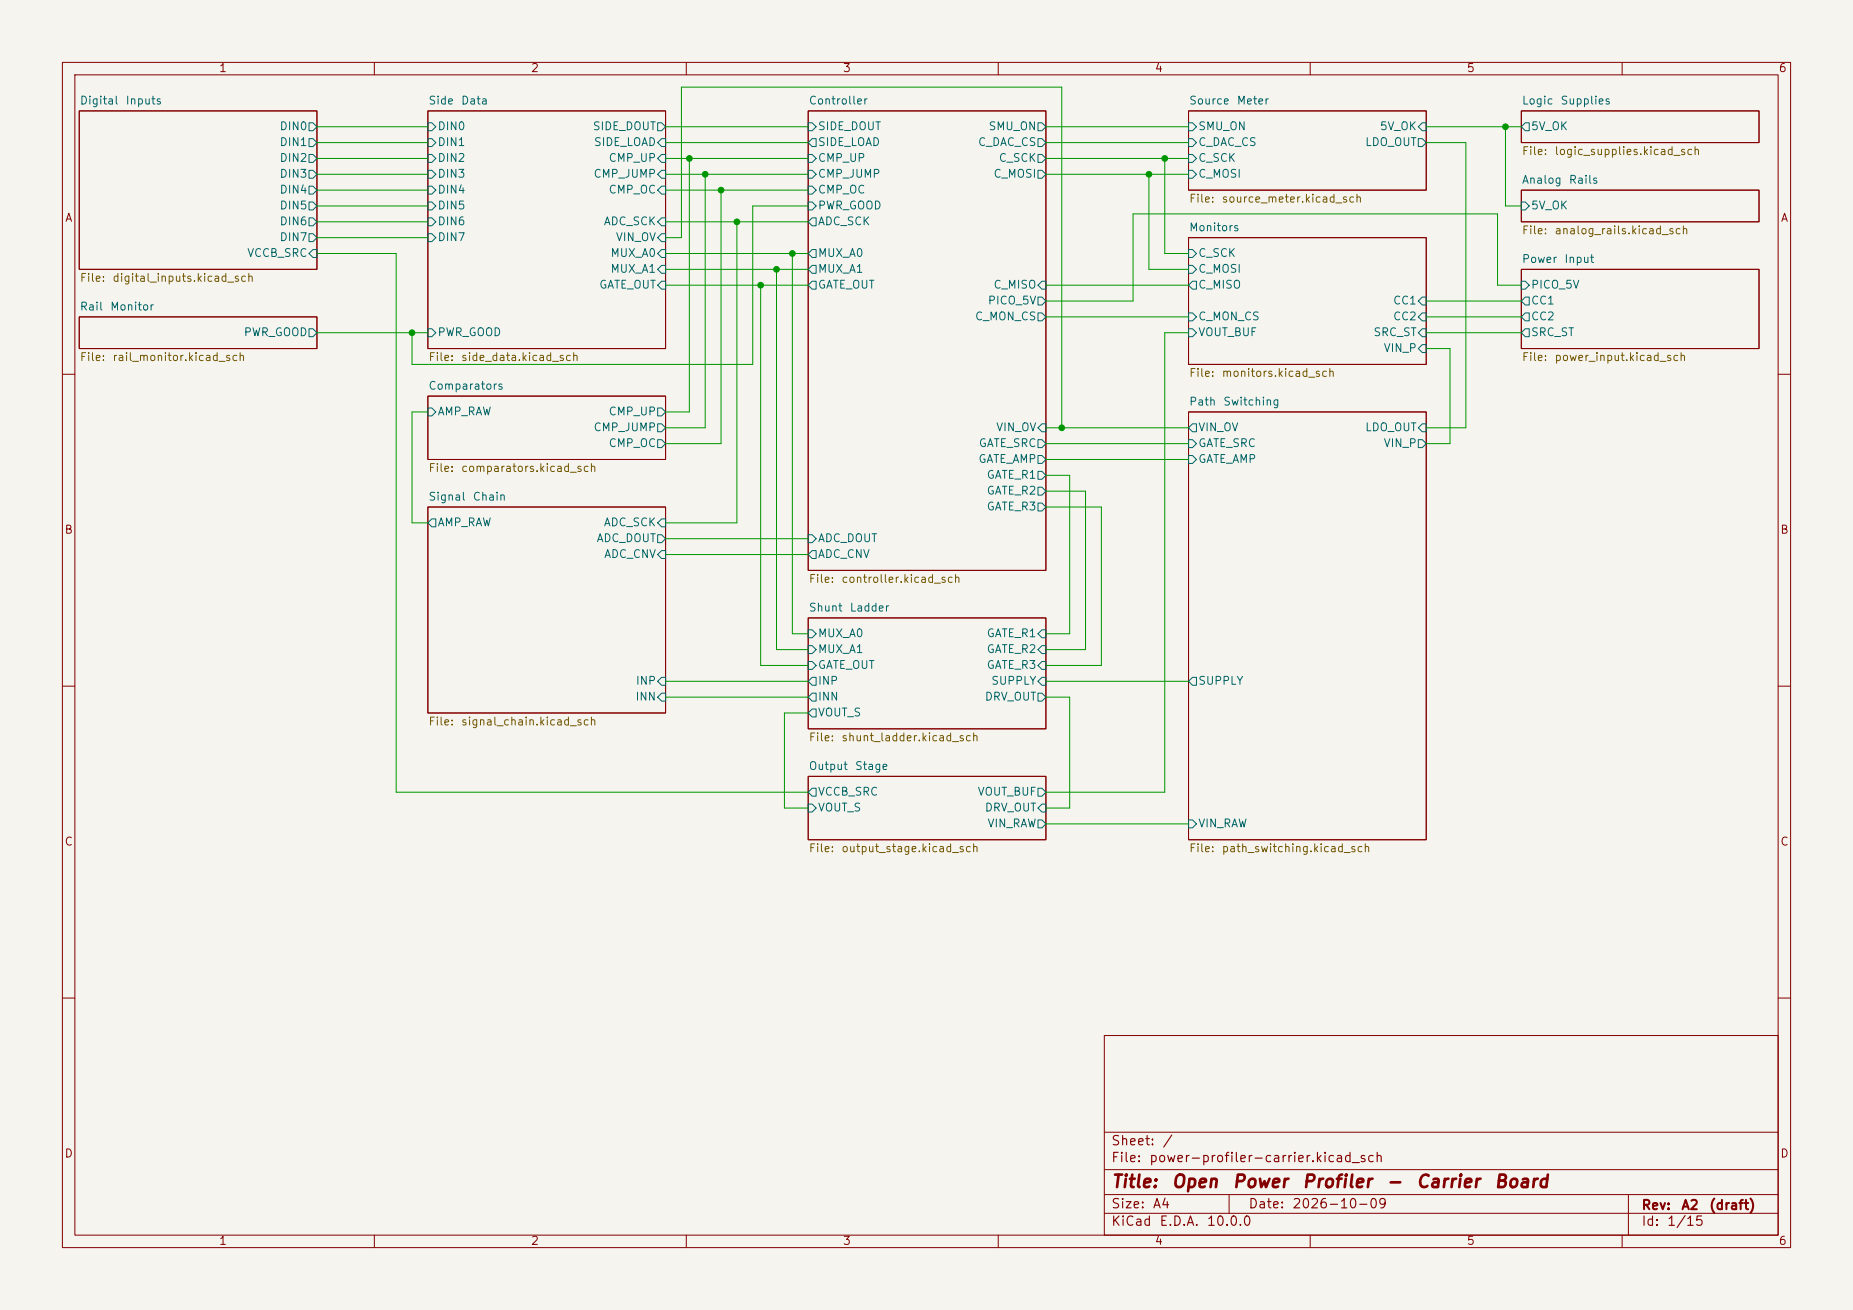
[picture p10: page 1]

SUPPLY DRV_OUT Shunt Ladder File: shunt_ladder.kicad_sch

Sheet: /
D Date: 2026-10-09 KiCad E.D.A. 10.0.0
File: power-profiler-carrier.kicad_sch
Title: Open Power Profiler - Carrier Board

Size: A4 | Rev: A2 (draft)

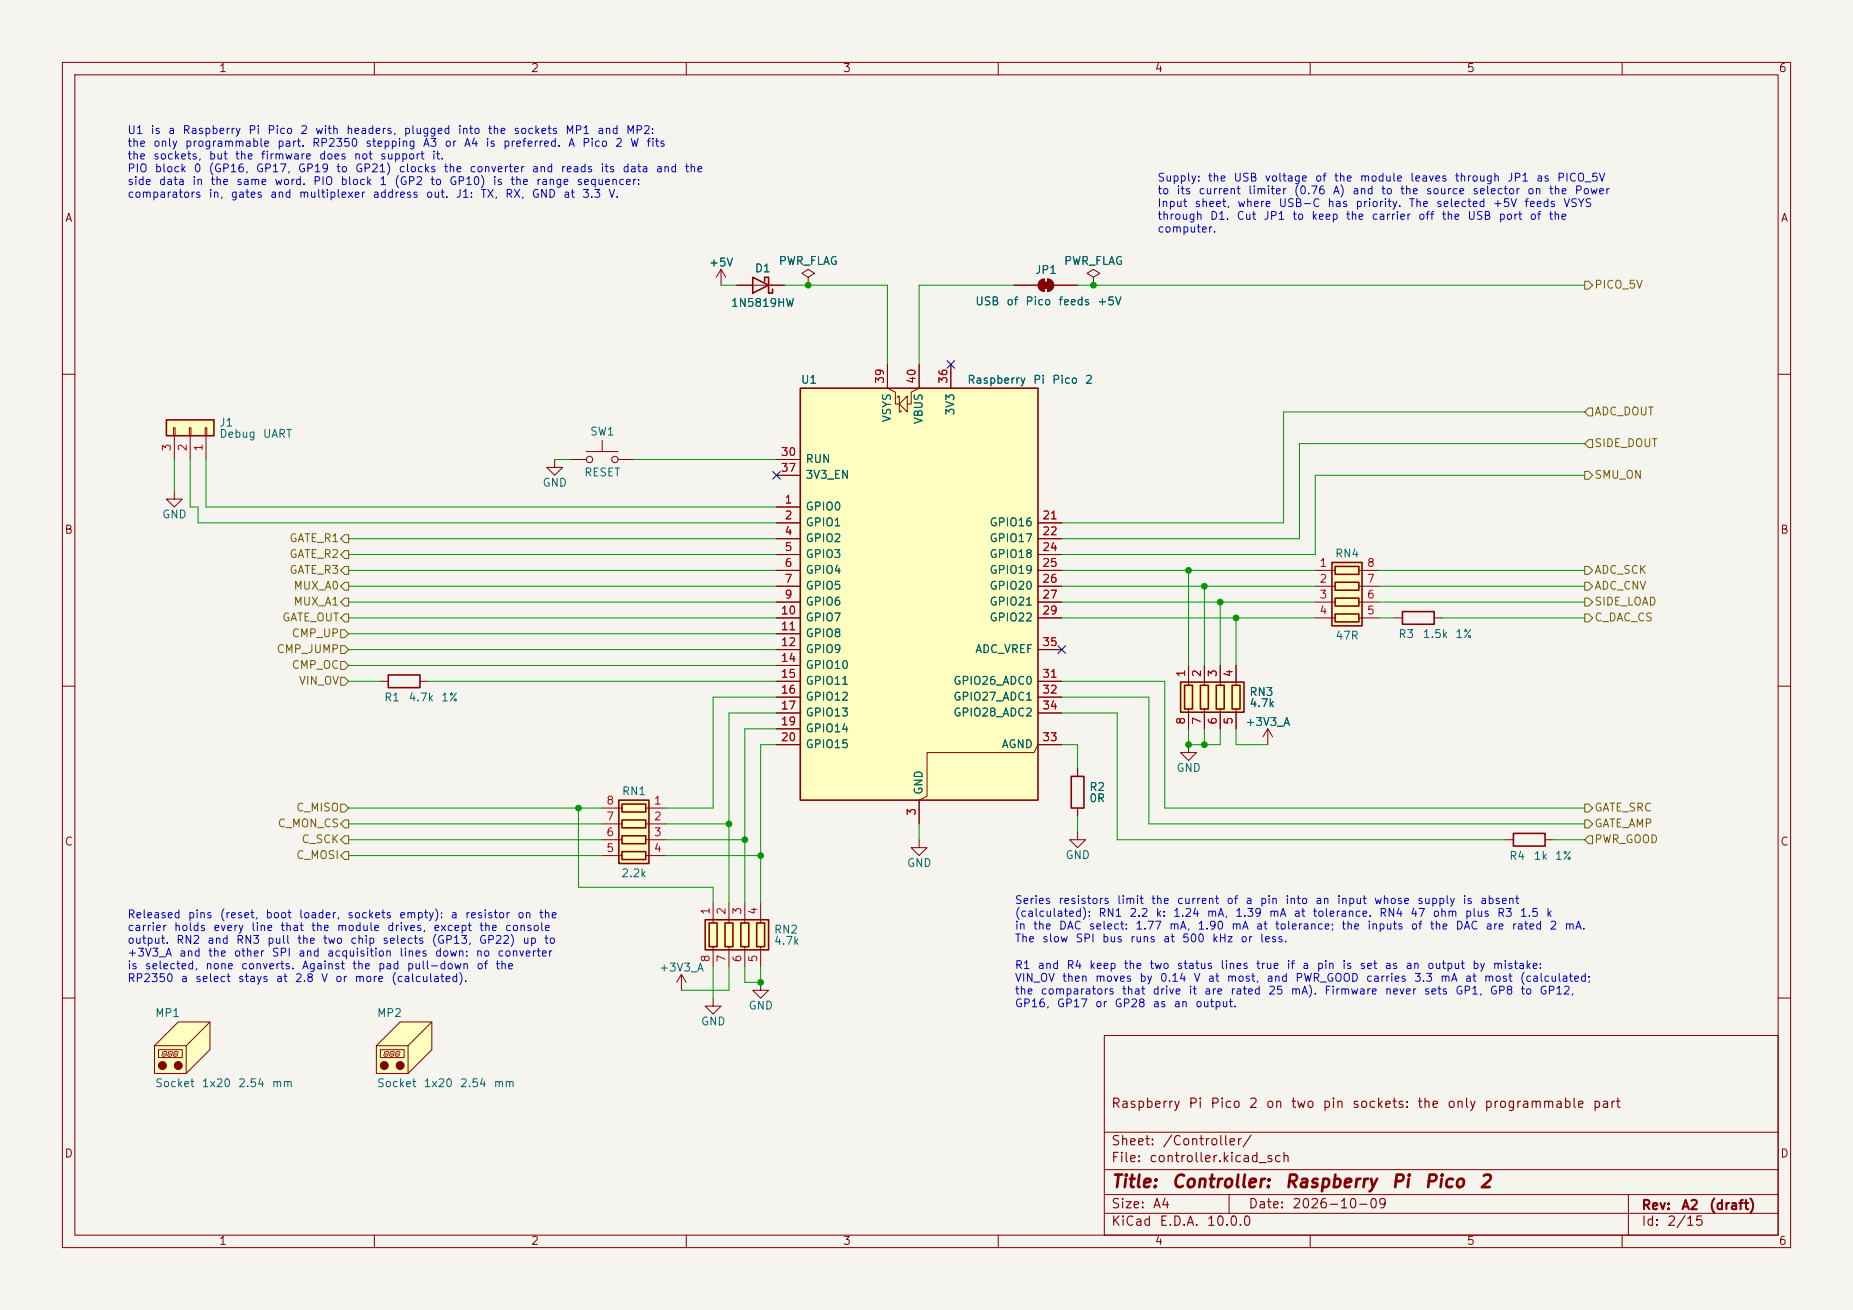
[picture p11: page 2]

ADC_CNV U1 is a Raspberry Pi Pico 2 with headers, plugged into the sockets MP1 and MP2: the only programmable part. RP2350 stepping A3 or A4 is preferred. A Pico 2 W fits

the sockets, but the firmware does not support it. PIO block 0 (GP16, GP17, GP19 to GP21) clocks the converter and reads its data and the

Supply: the USB voltage of the module leaves through JP1 as PICO_5V
to its current limiter (0.76 A) and to the source selector on the Power
Input sheet, where USB-C has priority. The selected +5V feeds VSYS
through D1. Cut JP1 to keep the carrier off the USB port of the
computer.

PWR_FLAG JP1 USB of Pico feeds +5V PWR_FLAG

Raspberry Pi Pico 2 on two pin sockets: the only programmable part R2

Released pins (reset, boot loader, sockets empty): a resistor on the
carrier holds every line that the module drives, except the console output. RN2 and RN3 pull the two chip selects (GP13, GP22) up to +3V3_A and the other SPI and acquisition lines down: no converter

in the DAC select: 1.77 mA, 1.90 mA at tolerance; the inputs of the DAC are rated 2 mA. The slow SPI bus runs at 500 kHz or less.

R1 and R4 keep the two status lines true if a pin is set as an output by mistake: VIN_OV then moves by 0.14 V at most, and PWR_GOOD carries 3.3 mA at most (calculated;

the comparators that drive it are rated 25 mA). Firmware never sets GP1, GP8 to GP12, GP16, GP17 or GP28 as an output.

Sheet: /Controller/
D Date: 2026-10-09 KiCad E.D.A. 10.0.0
File: controller.kicad_sch
Title: Controller: Raspberry Pi Pico 2

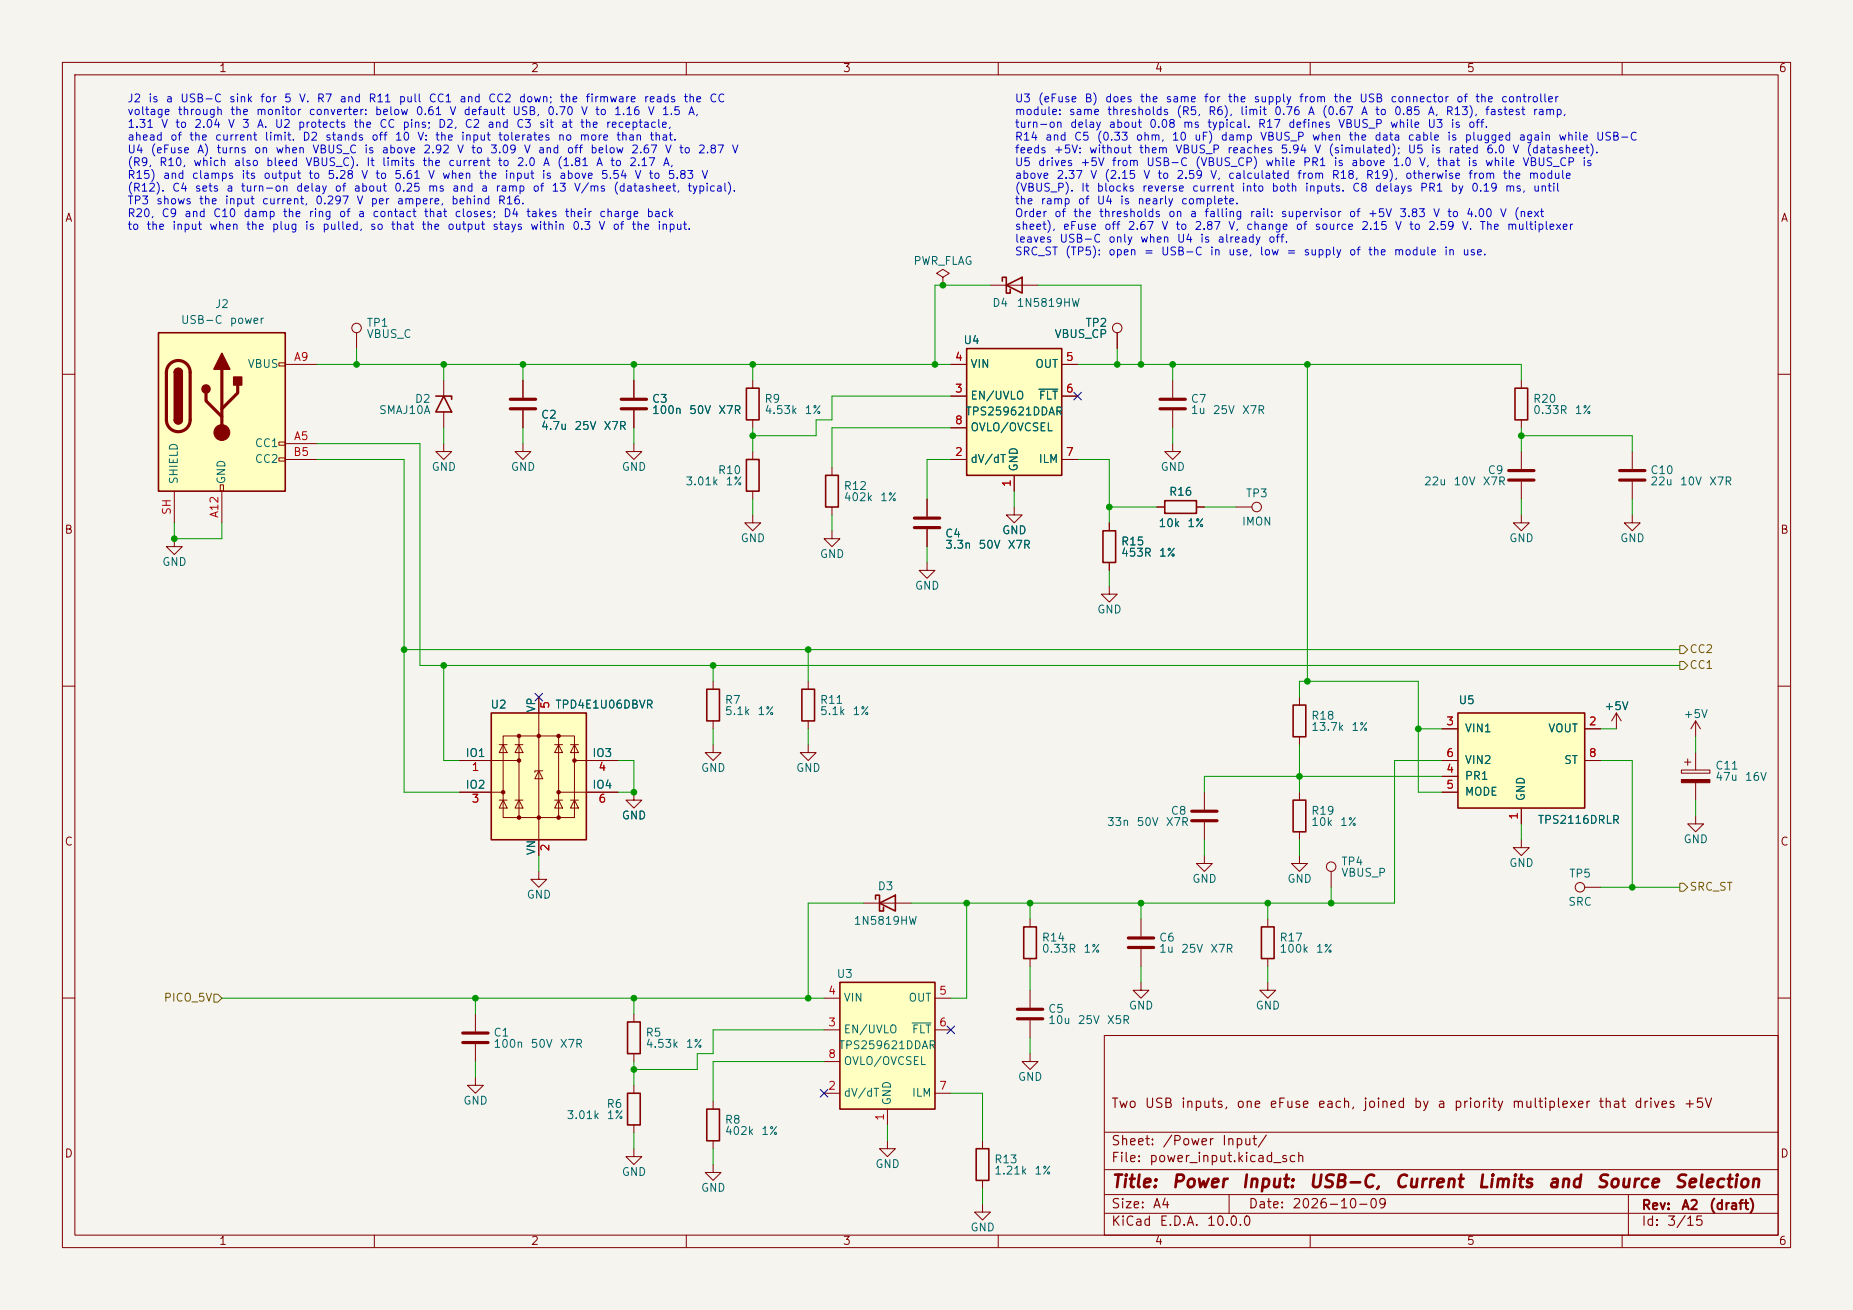
[picture p12: page 3]

J2 is a USB-C sink for 5 V. R7 and R11 pull CC1 and CC2 down; the firmware reads the CC
voltage through the monitor converter: below 0.61 V default USB, 0.70 V to 1.16 V 1.5 A, 1.31 V to 2.04 V 3 A. U2 protects the CC pins; D2, C2 and C3 sit at the receptacle,
J2 USB-C power GND

U3 (eFuse B) does the same for the supply from the USB connector of the controller module: same thresholds (R5, R6), limit 0.76 A (0.67 A to 0.85 A, R13), fastest ramp, turn-on delay about 0.08 ms typical. R17 defines VBUS_P while U3 is off. R14 and C5 (0.33 ohm, 10 uF) damp VBUS_P when the data cable is plugged again while USB-C

ahead of the current limit. D2 stands off 10 V: the input tolerates no more than that. U4 (eFuse A) turns on when VBUS_C is above 2.92 V to 3.09 V and off below 2.67 V to 2.87 V

feeds +5V: without them VBUS_P reaches 5.94 V (simulated); U5 is rated 6.0 V (datasheet).
U5 drives +5V from USB-C (VBUS_CP) while PR1 is above 1.0 V, that is while VBUS_CP is above 2.37 V (2.15 V to 2.59 V, calculated from R18, R19), otherwise from the module

(R9, R10, which also bleed VBUS_C). It limits the current to 2.0 A (1.81 A to 2.17 A, R15) and clamps its output to 5.28 V to 5.61 V when the input is above 5.54 V to 5.83 V

(R12). C4 sets a turn-on delay of about 0.25 ms and a ramp of 13 V/ms (datasheet, typical).
TP3 shows the input current, 0.297 V per ampere, behind R16. R20, C9 and C10 damp the ring of a contact that closes; D4 takes their charge back

(VBUS_P). It blocks reverse current into both inputs. C8 delays PR1 by 0.19 ms, until the ramp of U4 is nearly complete.

Order of the thresholds on a falling rail: supervisor of +5V 3.83 V to 4.00 V (next
sheet), eFuse off 2.67 V to 2.87 V, change of source 2.15 V to 2.59 V. The multiplexer

to the input when the plug is pulled, so that the output stays within 0.3 V of the input.

leaves USB-C only when U4 is already off. SRC_ST (TP5): open = USB-C in use, low = supply of the module in use. C2

Two USB inputs, one eFuse each, joined by a priority multiplexer that drives +5V

Sheet: /Power Input/
D Date: 2026-10-09 KiCad E.D.A. 10.0.0
File: power_input.kicad_sch
Title: Power Input: USB-C, Current Limits and Source Selection

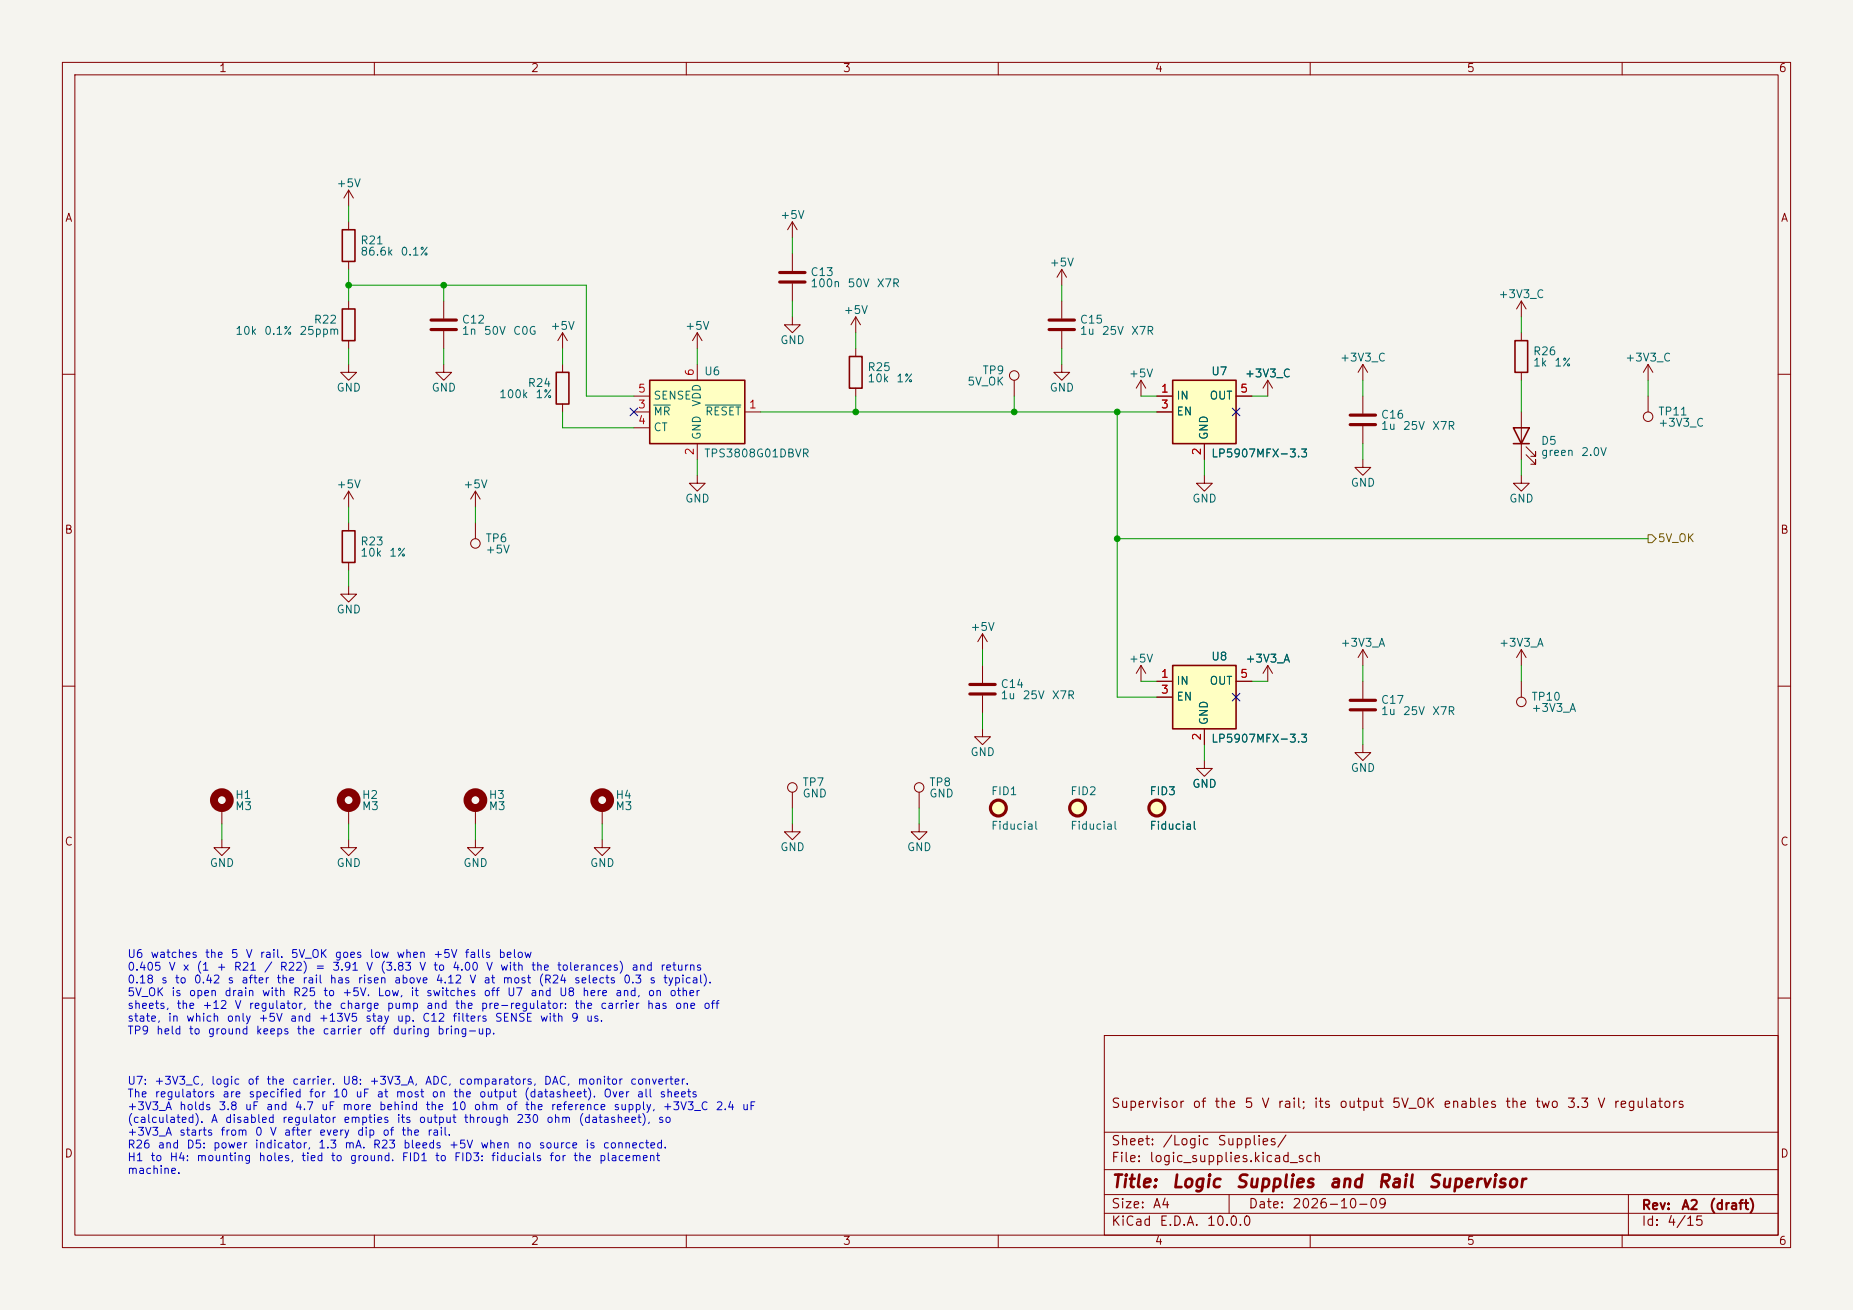
[picture p13: page 4]

5V_OK U7: +3V3_C, logic of the carrier. U8: +3V3_A, ADC, comparators, DAC, monitor converter. The regulators are specified for 10 uF at most on the output (datasheet). Over all sheets +3V3_A holds 3.8 uF and 4.7 uF more behind the 10 ohm of the reference supply, +3V3_C 2.4 uF

(calculated). A disabled regulator empties its output through 230 ohm (datasheet), so +3V3_A starts from 0 V after every dip of the rail. R26 and D5: power indicator, 1.3 mA. R23 bleeds +5V when no source is connected. H1 to H4: mounting holes, tied to ground. FID1 to FID3: fiducials for the placement machine. U6 watches the 5 V rail. 5V_OK goes low when +5V falls below
0.405 V x (1 + R21 / R22) = 3.91 V (3.83 V to 4.00 V with the tolerances) and returns 0.18 s to 0.42 s after the rail has risen above 4.12 V at most (R24 selects 0.3 s typical).

Supervisor of the 5 V rail; its output 5V_OK enables the two 3.3 V regulators

Sheet: /Logic Supplies/
D Date: 2026-10-09 KiCad E.D.A. 10.0.0
File: logic_supplies.kicad_sch
Title: Logic Supplies and Rail Supervisor

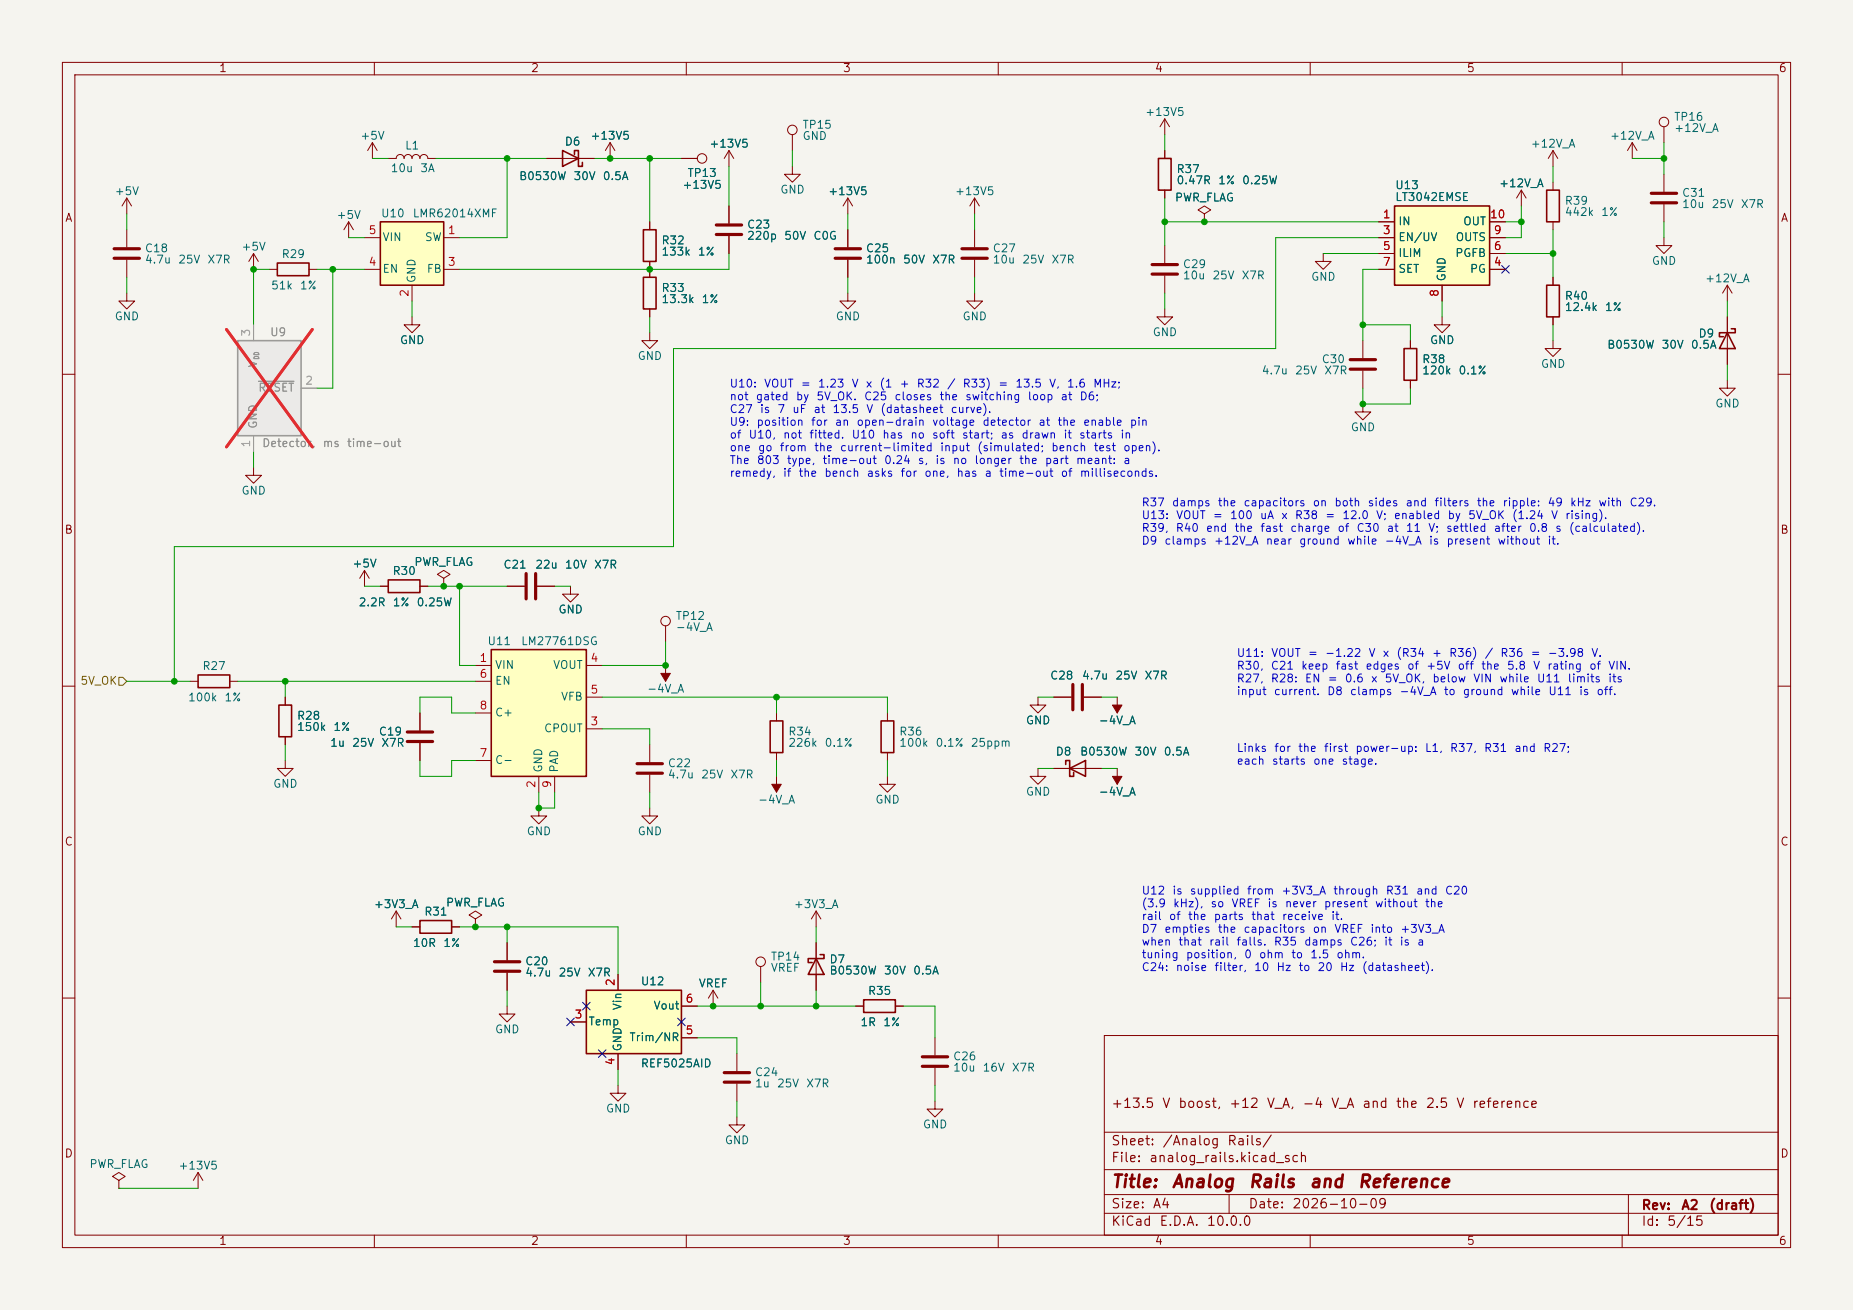
[picture p14: page 5]

V DD 3U9 Detector, ms time-out +3V3_A GND

remedy, if the bench asks for one, has a time-out of milliseconds. GND U9 Detector, ms time-out GND

U10: VOUT = 1.23 V x (1 + R32 / R33) = 13.5 V, 1.6 MHz; not gated by 5V_OK. C25 closes the switching loop at D6; C27 is 7 uF at 13.5 V (datasheet curve).

U9: position for an open-drain voltage detector at the enable pin
of U10, not fitted. U10 has no soft start; as drawn it starts in
one go from the current-limited input (simulated; bench test open).
The 803 type, time-out 0.24 s, is no longer the part meant: a

R37 damps the capacitors on both sides and filters the ripple: 49 kHz with C29. U13: VOUT = 100 uA x R38 = 12.0 V; enabled by 5V_OK (1.24 V rising).

R39, R40 end the fast charge of C30 at 11 V; settled after 0.8 s (calculated).
D9 clamps +12V_A near ground while -4V_A is present without it. U11: VOUT = -1.22 V x (R34 + R36) / R36 = -3.98 V. R30, C21 keep fast edges of +5V off the 5.8 V rating of VIN. R27, R28: EN = 0.6 x 5V_OK, below VIN while U11 limits its

input current. D8 clamps -4V_A to ground while U11 is off. U12 is supplied from +3V3_A through R31 and C20

Links for the first power-up: L1, R37, R31 and R27; each starts one stage.

(3.9 kHz), so VREF is never present without the
rail of the parts that receive it. D7 empties the capacitors on VREF into +3V3_A when that rail falls. R35 damps C26; it is a

tuning position, 0 ohm to 1.5 ohm. C24: noise filter, 10 Hz to 20 Hz (datasheet).

+13.5 V boost, +12 V_A, -4 V_A and the 2.5 V reference

Sheet: /Analog Rails/
D Date: 2026-10-09 KiCad E.D.A. 10.0.0
File: analog_rails.kicad_sch
Title: Analog Rails and Reference

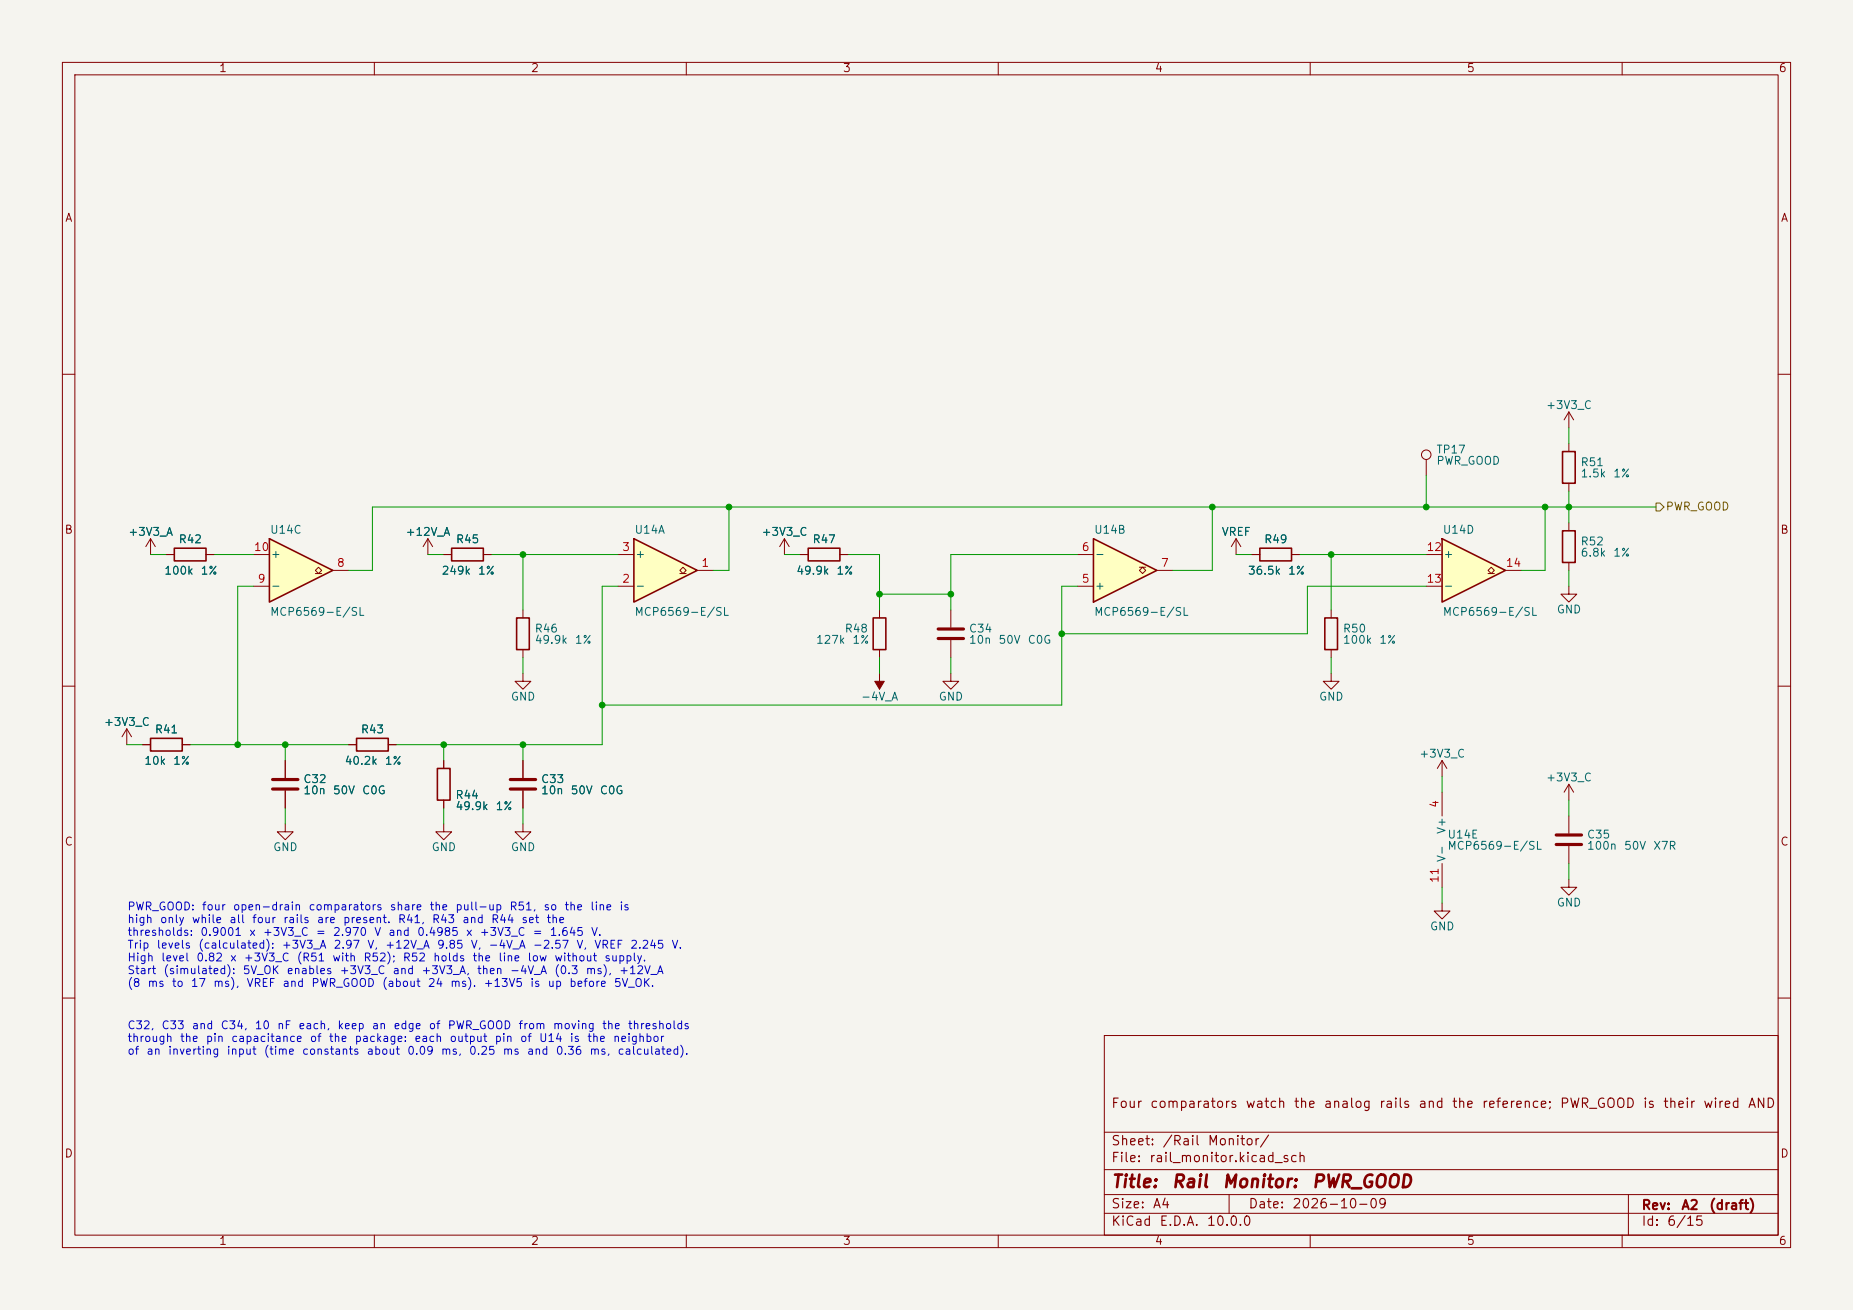
[picture p15: page 6]

of an inverting input (time constants about 0.09 ms, 0.25 ms and 0.36 ms, calculated). +12V_A R45

PWR_GOOD: four open-drain comparators share the pull-up R51, so the line is high only while all four rails are present. R41, R43 and R44 set the

thresholds: 0.9001 x +3V3_C = 2.970 V and 0.4985 x +3V3_C = 1.645 V. Trip levels (calculated): +3V3_A 2.97 V, +12V_A 9.85 V, -4V_A -2.57 V, VREF 2.245 V. High level 0.82 x +3V3_C (R51 with R52); R52 holds the line low without supply.

Start (simulated): 5V_OK enables +3V3_C and +3V3_A, then -4V_A (0.3 ms), +12V_A
(8 ms to 17 ms), VREF and PWR_GOOD (about 24 ms). +13V5 is up before 5V_OK. C32, C33 and C34, 10 nF each, keep an edge of PWR_GOOD from moving the thresholds

through the pin capacitance of the package: each output pin of U14 is the neighbor

Four comparators watch the analog rails and the reference; PWR_GOOD is their wired AND

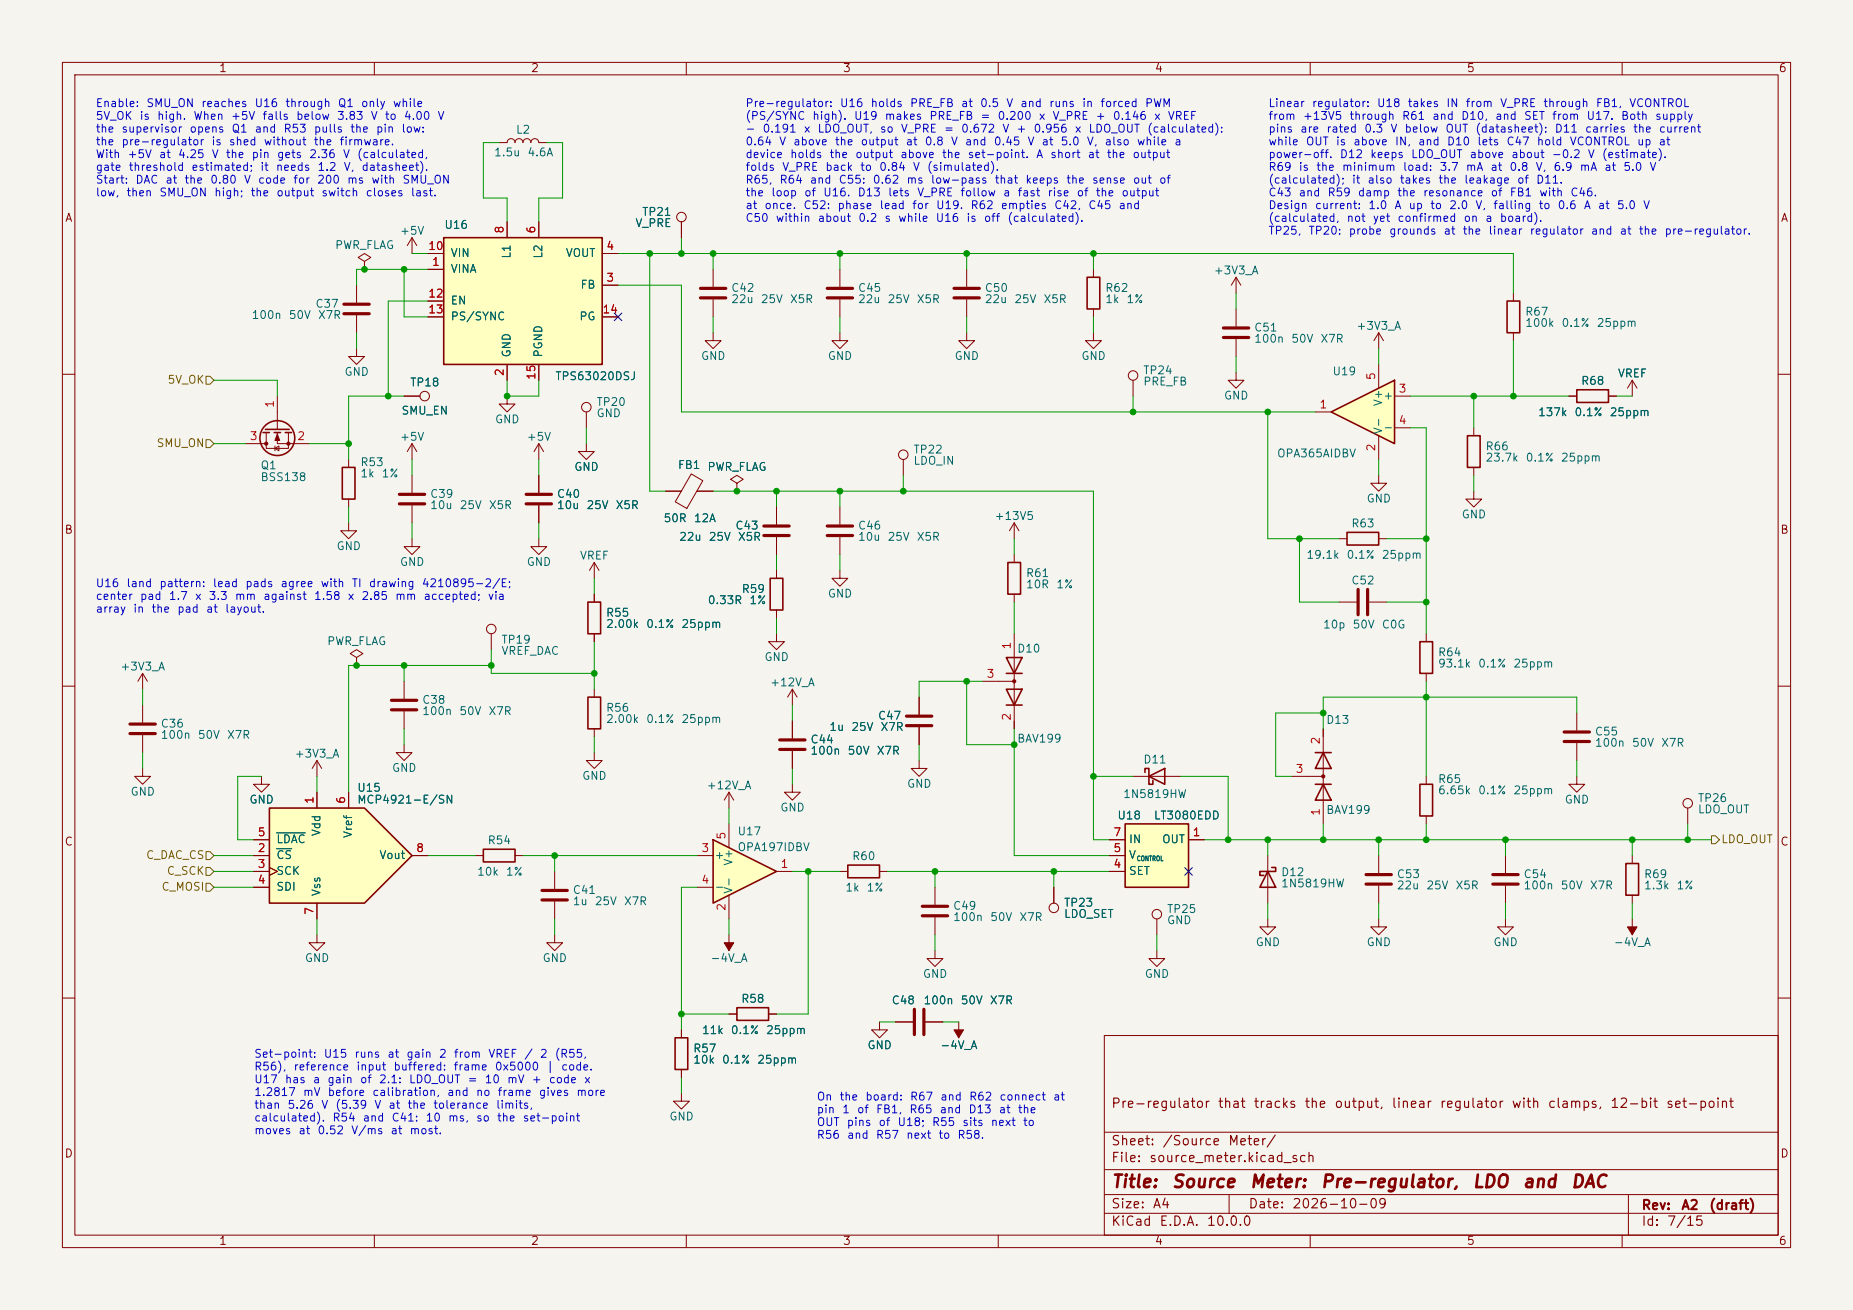
[picture p16: page 7]

Enable: SMU_ON reaches U16 through Q1 only while 5V_OK is high. When +5V falls below 3.83 V to 4.00 V

Pre-regulator: U16 holds PRE_FB at 0.5 V and runs in forced PWM
(PS/SYNC high). U19 makes PRE_FB = 0.200 x V_PRE + 0.146 x VREF - 0.191 x LDO_OUT, so V_PRE = 0.672 V + 0.956 x LDO_OUT (calculated):

from +13V5 through R61 and D10, and SET from U17. Both supply
pins are rated 0.3 V below OUT (datasheet): D11 carries the current while OUT is above IN, and D10 lets C47 hold VCONTROL up at power-off. D12 keeps LDO_OUT above about -0.2 V (estimate).

the supervisor opens Q1 and R53 pulls the pin low: the pre-regulator is shed without the firmware. With +5V at 4.25 V the pin gets 2.36 V (calculated,

0.64 V above the output at 0.8 V and 0.45 V at 5.0 V, also while a
device holds the output above the set-point. A short at the output
folds V_PRE back to 0.84 V (simulated).
R65, R64 and C55: 0.62 ms low-pass that keeps the sense out of
the loop of U16. D13 lets V_PRE follow a fast rise of the output
at once. C52: phase lead for U19. R62 empties C42, C45 and C50 within about 0.2 s while U16 is off (calculated).

gate threshold estimated; it needs 1.2 V, datasheet).
Start: DAC at the 0.80 V code for 200 ms with SMU_ON

R69 is the minimum load: 3.7 mA at 0.8 V, 6.9 mA at 5.0 V
(calculated); it also takes the leakage of D11. C43 and R59 damp the resonance of FB1 with C46. Design current: 1.0 A up to 2.0 V, falling to 0.6 A at 5.0 V
GND +3V3_AC51

(calculated, not yet confirmed on a board).
TP25, TP20: probe grounds at the linear regulator and at the pre-regulator.

Pre-regulator that tracks the output, linear regulator with clamps, 12-bit set-point GND

LDO_OUT U16 land pattern: lead pads agree with TI drawing 4210895-2/E;
center pad 1.7 x 3.3 mm against 1.58 x 2.85 mm accepted; via
array in the pad at layout.

On the board: R67 and R62 connect at pin 1 of FB1, R65 and D13 at the OUT pins of U18; R55 sits next to R56 and R57 next to R58. Set-point: U15 runs at gain 2 from VREF / 2 (R55,
R56), reference input buffered: frame 0x5000 | code. U17 has a gain of 2.1: LDO_OUT = 10 mV + code x 1.2817 mV before calibration, and no frame gives more

Sheet: /Source Meter/
D Date: 2026-10-09 KiCad E.D.A. 10.0.0
File: source_meter.kicad_sch
Title: Source Meter: Pre-regulator, LDO and DAC

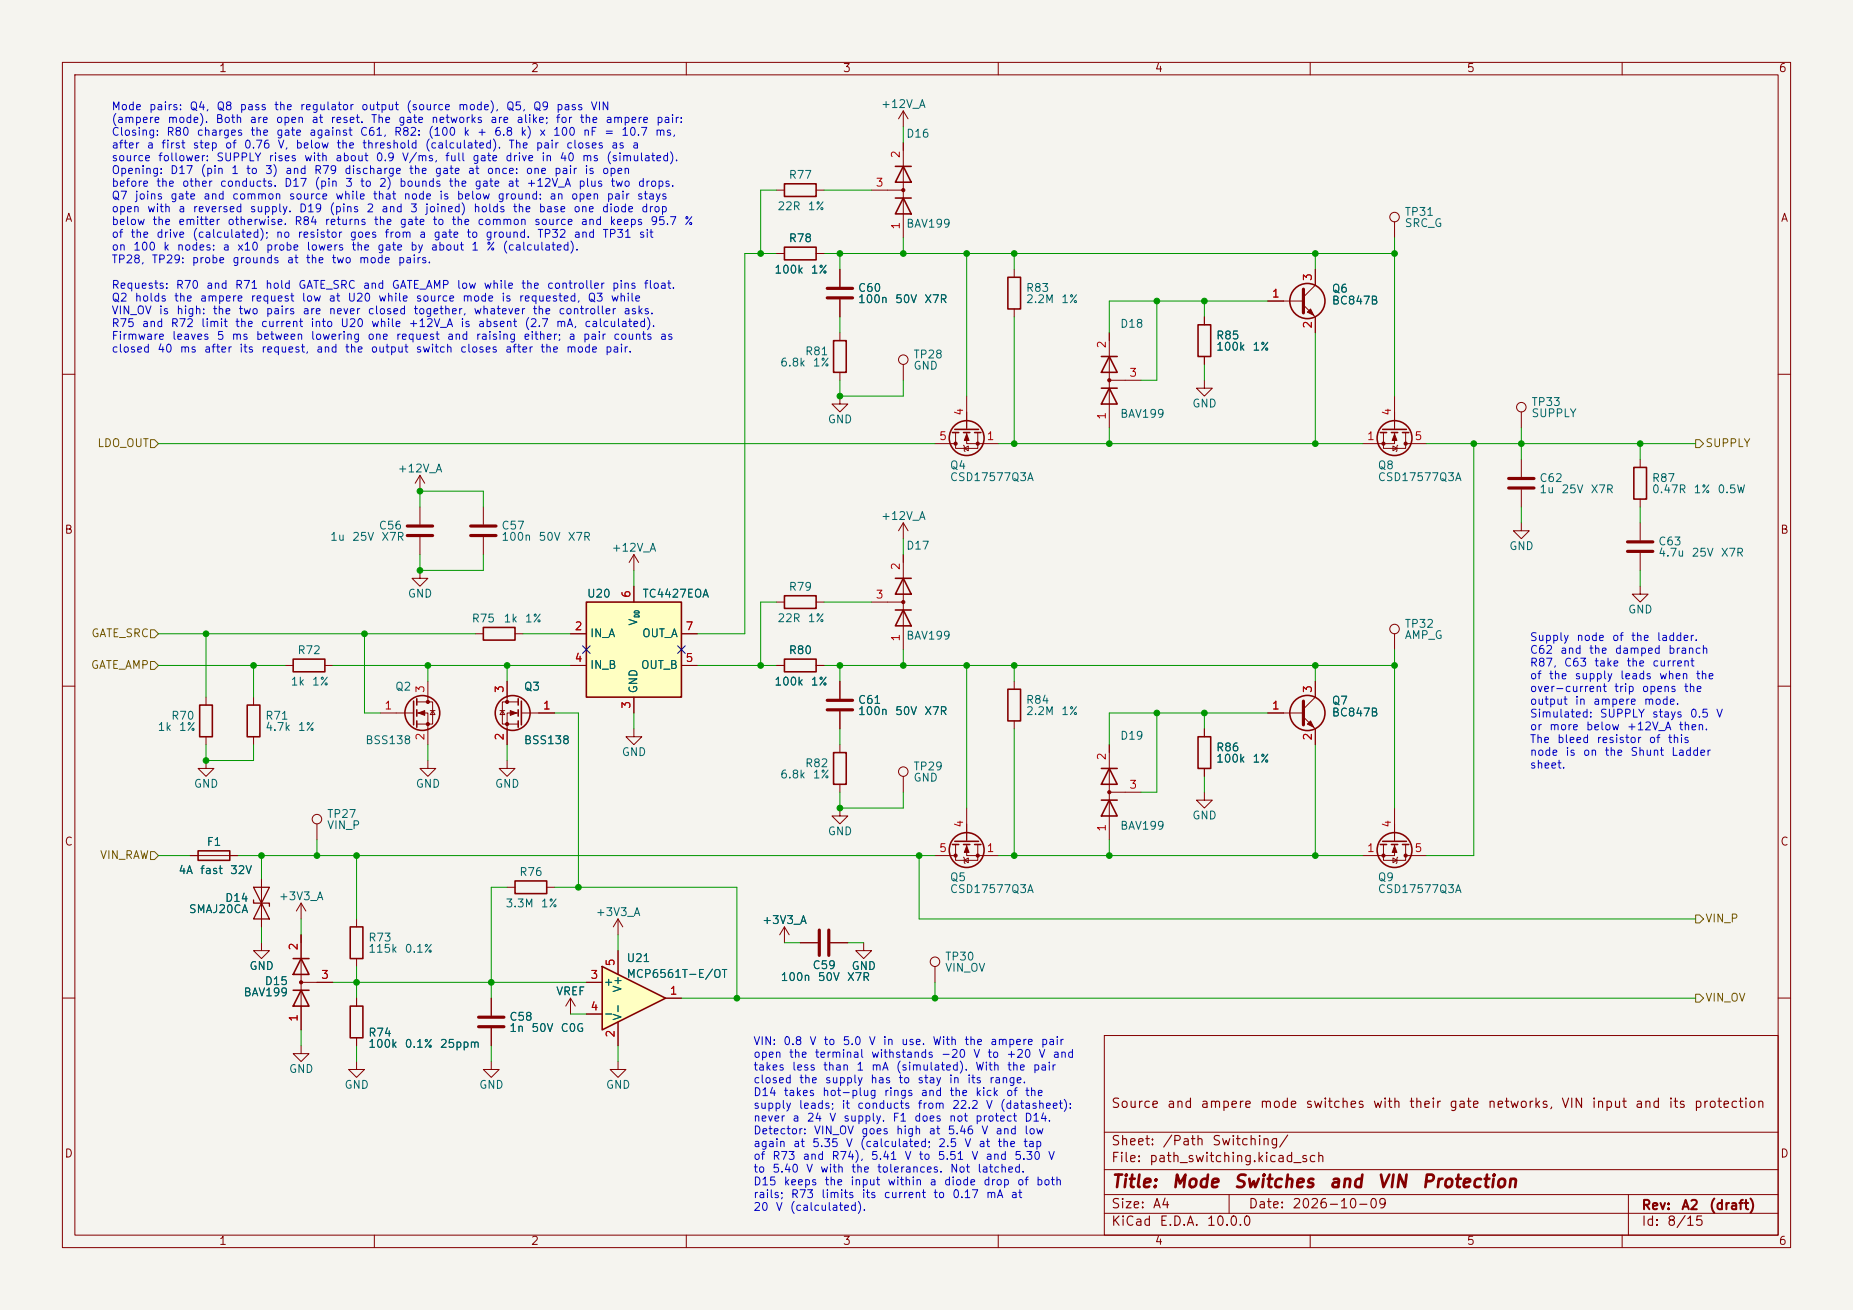
[picture p17: page 8]

Mode pairs: Q4, Q8 pass the regulator output (source mode), Q5, Q9 pass VIN
(ampere mode). Both are open at reset. The gate networks are alike; for the ampere pair:
Closing: R80 charges the gate against C61, R82: (100 k + 6.8 k) x 100 nF = 10.7 ms, after a first step of 0.76 V, below the threshold (calculated). The pair closes as a

source follower: SUPPLY rises with about 0.9 V/ms, full gate drive in 40 ms (simulated).
Opening: D17 (pin 1 to 3) and R79 discharge the gate at once: one pair is open
before the other conducts. D17 (pin 3 to 2) bounds the gate at +12V_A plus two drops.
Q7 joins gate and common source while that node is below ground: an open pair stays open with a reversed supply. D19 (pins 2 and 3 joined) holds the base one diode drop

below the emitter otherwise. R84 returns the gate to the common source and keeps 95.7 %
of the drive (calculated); no resistor goes from a gate to ground. TP32 and TP31 sit on 100 k nodes: a x10 probe lowers the gate by about 1 % (calculated).

TP28, TP29: probe grounds at the two mode pairs.

Requests: R70 and R71 hold GATE_SRC and GATE_AMP low while the controller pins float. Q2 holds the ampere request low at U20 while source mode is requested, Q3 while

VIN_OV is high: the two pairs are never closed together, whatever the controller asks. R75 and R72 limit the current into U20 while +12V_A is absent (2.7 mA, calculated).

takes less than 1 mA (simulated). With the pair
closed the supply has to stay in its range. D14 takes hot-plug rings and the kick of the

supply leads; it conducts from 22.2 V (datasheet): never a 24 V supply. F1 does not protect D14. Detector: VIN_OV goes high at 5.46 V and low

Source and ampere mode switches with their gate networks, VIN input and its protection

Sheet: /Path Switching/
D Date: 2026-10-09 KiCad E.D.A. 10.0.0
File: path_switching.kicad_sch
Title: Mode Switches and VIN Protection

again at 5.35 V (calculated; 2.5 V at the tap
of R73 and R74), 5.41 V to 5.51 V and 5.30 V
to 5.40 V with the tolerances. Not latched. D15 keeps the input within a diode drop of both

rails; R73 limits its current to 0.17 mA at 20 V (calculated).

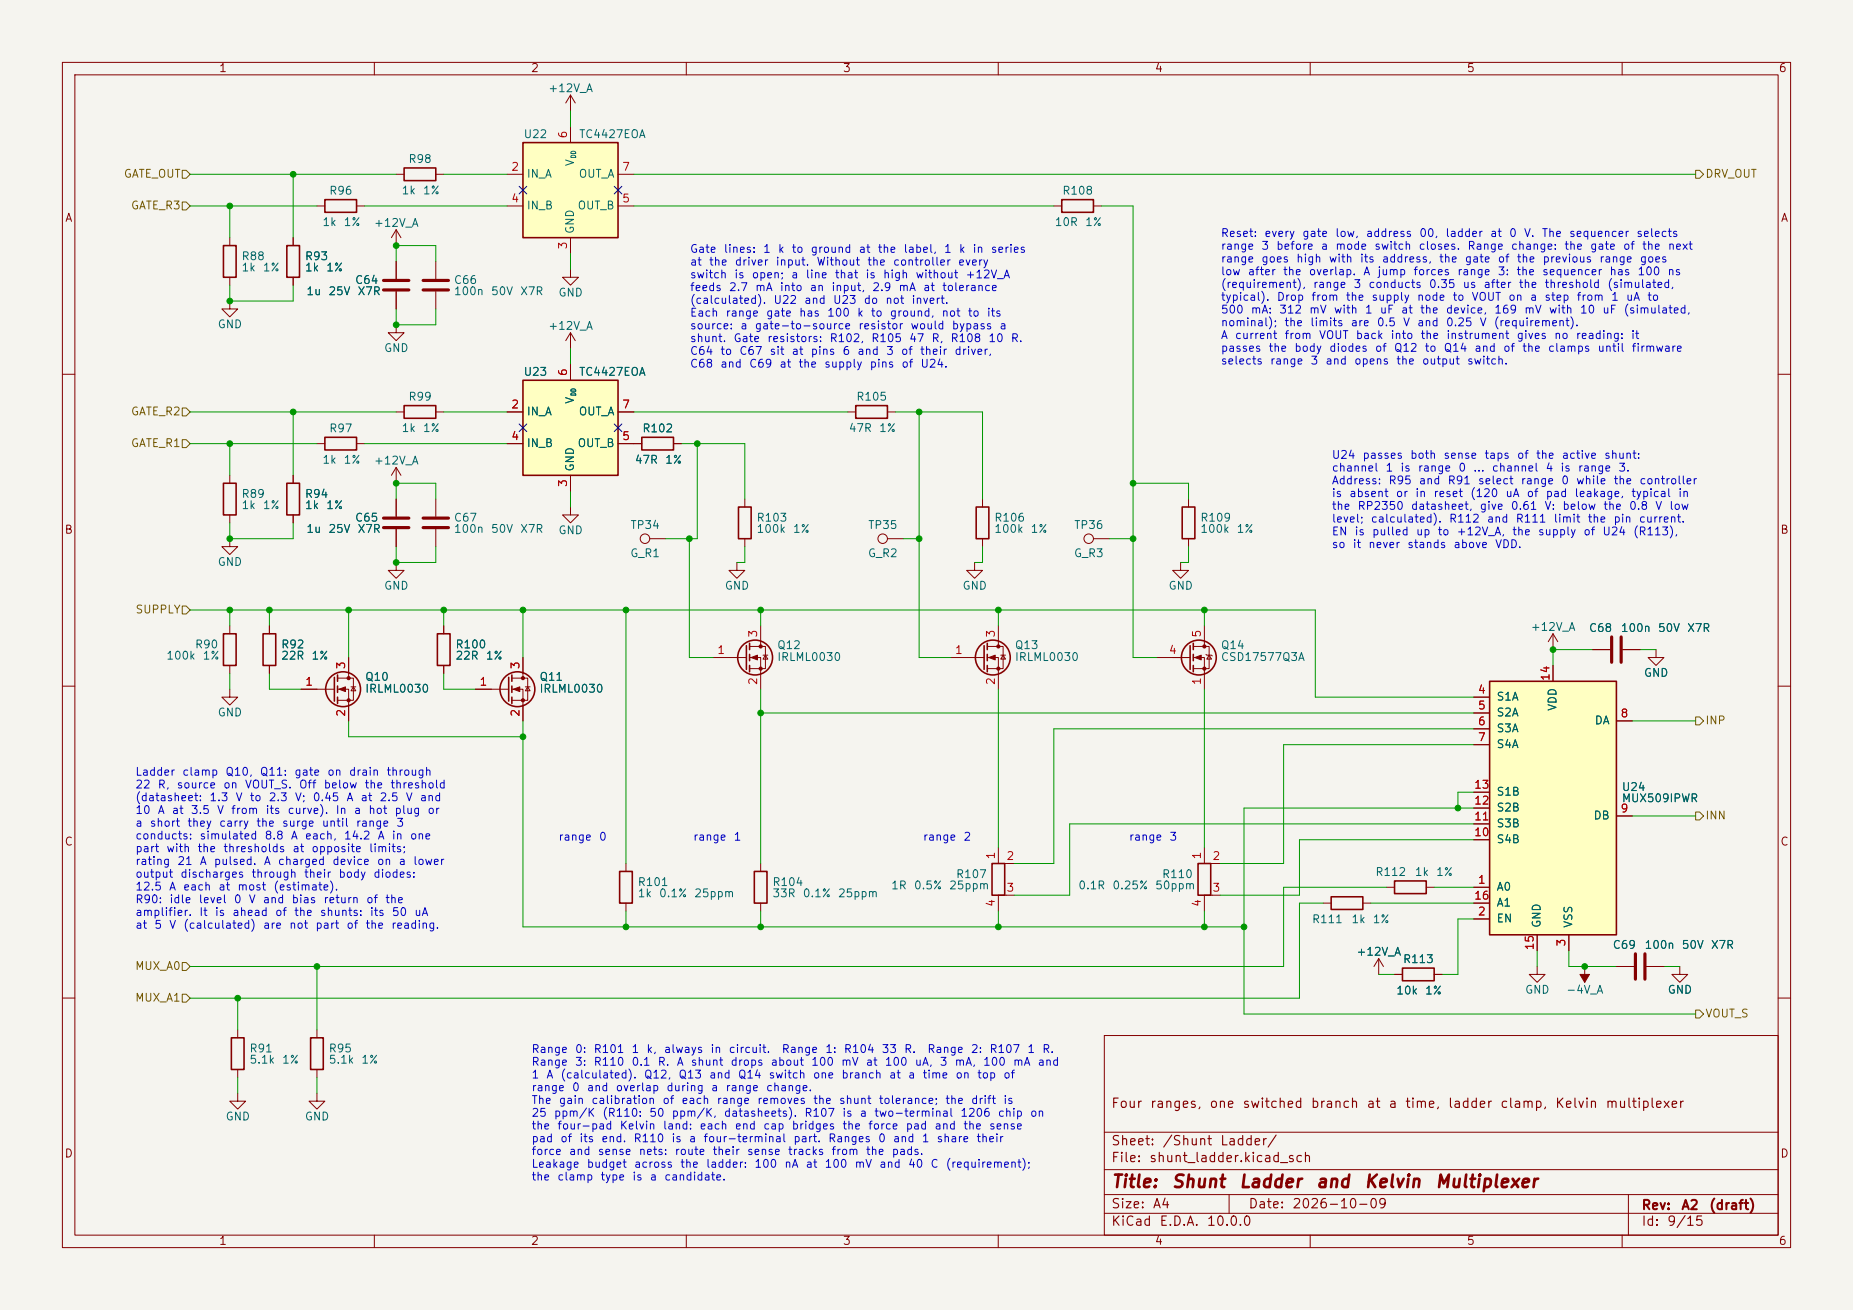
[picture p18: page 9]

Reset: every gate low, address 00, ladder at 0 V. The sequencer selects
range 3 before a mode switch closes. Range change: the gate of the next range goes high with its address, the gate of the previous range goes

Gate lines: 1 k to ground at the label, 1 k in series at the driver input. Without the controller every switch is open; a line that is high without +12V_A

low after the overlap. A jump forces range 3: the sequencer has 100 ns
(requirement), range 3 conducts 0.35 us after the threshold (simulated,
typical). Drop from the supply node to VOUT on a step from 1 uA to 500 mA: 312 mV with 1 uF at the device, 169 mV with 10 uF (simulated,

feeds 2.7 mA into an input, 2.9 mA at tolerance
(calculated). U22 and U23 do not invert. Each range gate has 100 k to ground, not to its

source: a gate-to-source resistor would bypass a

nominal); the limits are 0.5 V and 0.25 V (requirement).
A current from VOUT back into the instrument gives no reading: it passes the body diodes of Q12 to Q14 and of the clamps until firmware

shunt. Gate resistors: R102, R105 47 R, R108 10 R. C64 to C67 sit at pins 6 and 3 of their driver, C68 and C69 at the supply pins of U24. range 0

selects range 3 and opens the output switch. U24 passes both sense taps of the active shunt: channel 1 is range 0 ... channel 4 is range 3. Address: R95 and R91 select range 0 while the controller

the clamp type is a candidate. R100

is absent or in reset (120 uA of pad leakage, typical in
the RP2350 datasheet, give 0.61 V: below the 0.8 V low

level; calculated). R112 and R111 limit the pin current. EN is pulled up to +12V_A, the supply of U24 (R113), so it never stands above VDD. range 2 Range 0: R101 1 k, always in circuit. Range 1: R104 33 R. Range 2: R107 1 R. Range 3: R110 0.1 R. A shunt drops about 100 mV at 100 uA, 3 mA, 100 mA and 1 A (calculated). Q12, Q13 and Q14 switch one branch at a time on top of range 0 and overlap during a range change.
GND

Ladder clamp Q10, Q11: gate on drain through
22 R, source on VOUT_S. Off below the threshold
(datasheet: 1.3 V to 2.3 V; 0.45 A at 2.5 V and 10 A at 3.5 V from its curve). In a hot plug or a short they carry the surge until range 3

conducts: simulated 8.8 A each, 14.2 A in one part with the thresholds at opposite limits; rating 21 A pulsed. A charged device on a lower output discharges through their body diodes: 12.5 A each at most (estimate).

The gain calibration of each range removes the shunt tolerance; the drift is 25 ppm/K (R110: 50 ppm/K, datasheets). R107 is a two-terminal 1206 chip on

Four ranges, one switched branch at a time, ladder clamp, Kelvin multiplexer

the four-pad Kelvin land: each end cap bridges the force pad and the sense pad of its end. R110 is a four-terminal part. Ranges 0 and 1 share their

Sheet: /Shunt Ladder/
D Date: 2026-10-09 KiCad E.D.A. 10.0.0
File: shunt_ladder.kicad_sch
Title: Shunt Ladder and Kelvin Multiplexer

force and sense nets: route their sense tracks from the pads.
Leakage budget across the ladder: 100 nA at 100 mV and 40 C (requirement);

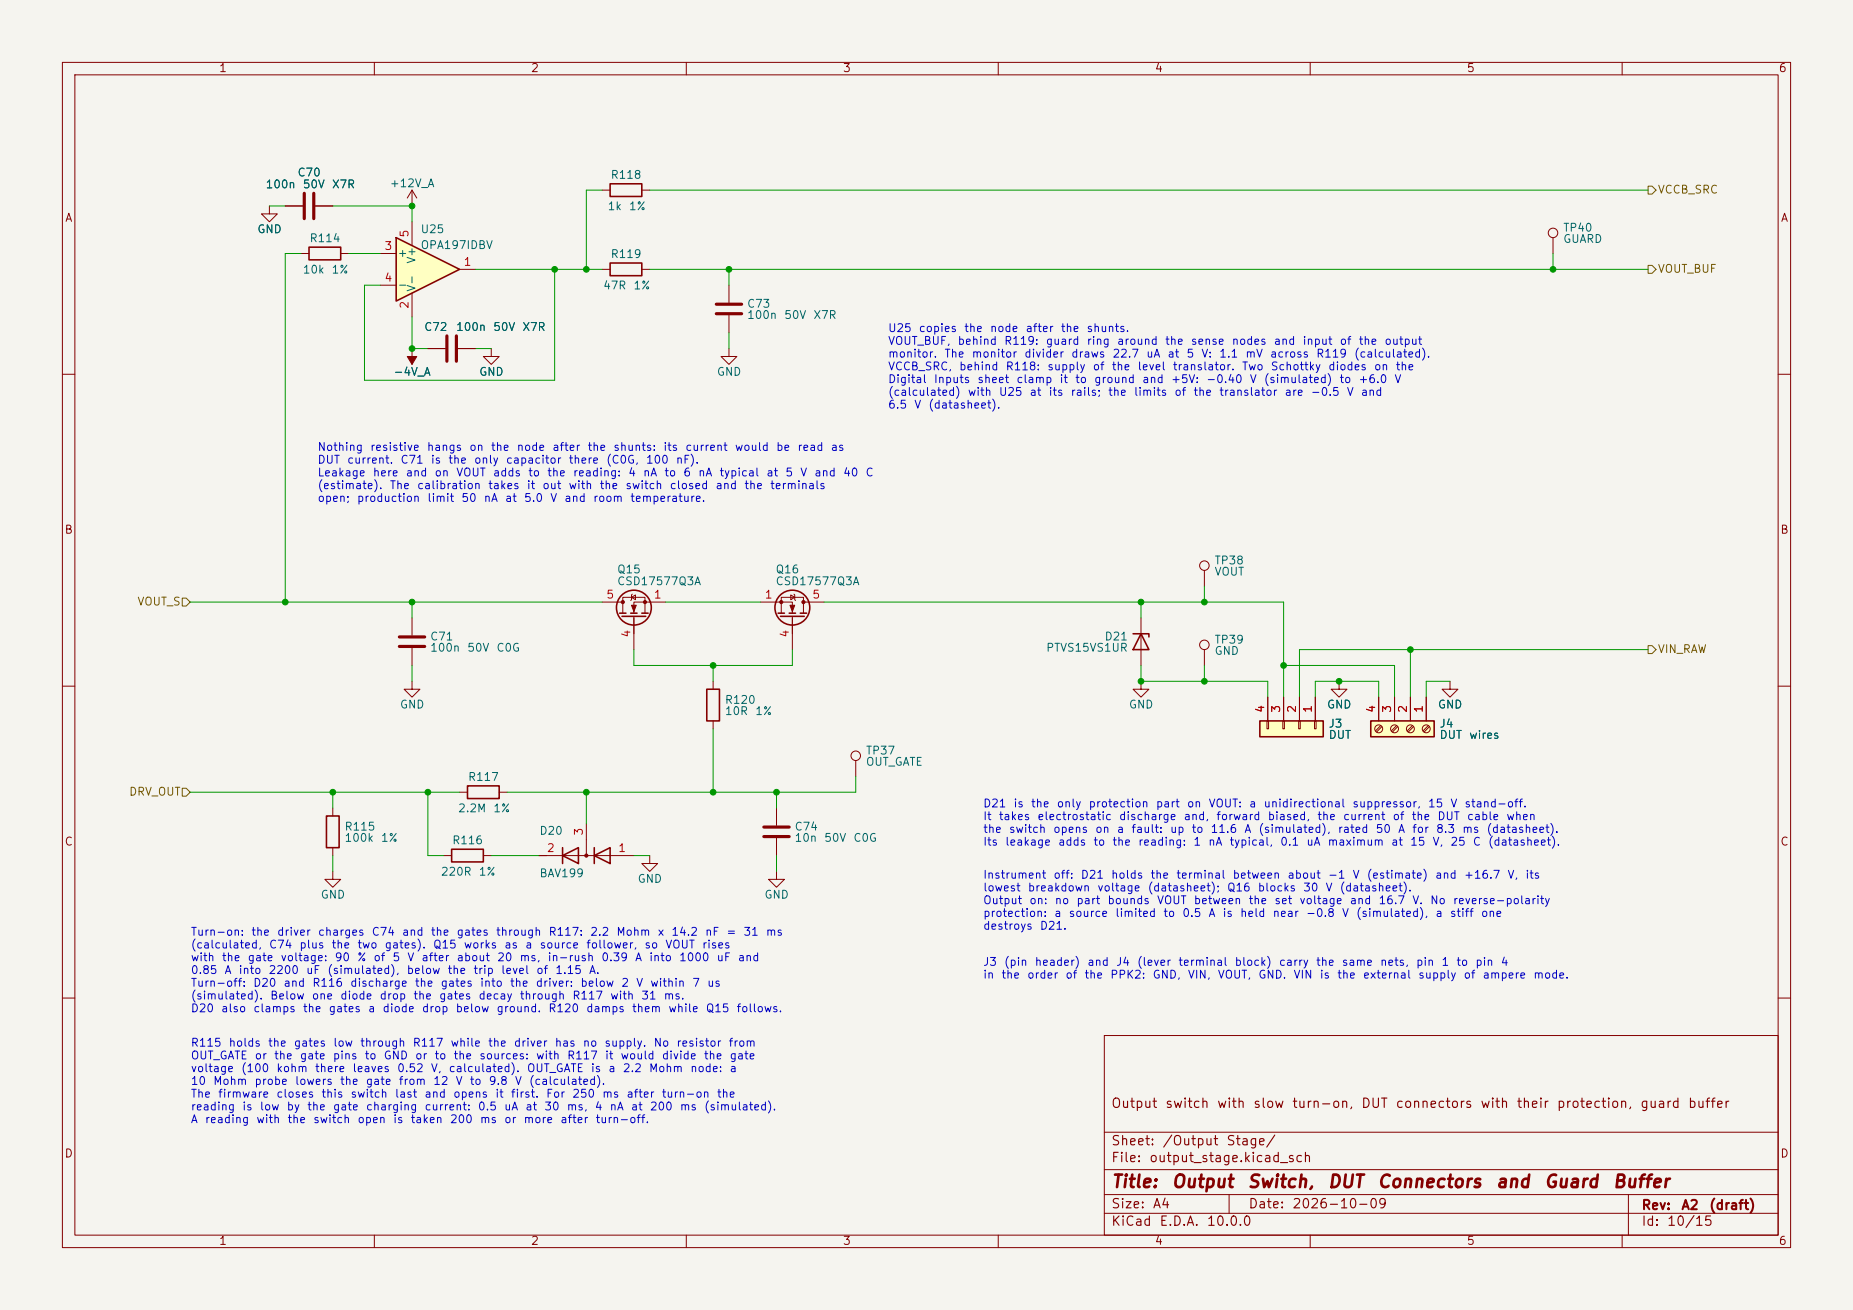
[picture p19: page 10]

monitor. The monitor divider draws 22.7 uA at 5 V: 1.1 mV across R119 (calculated).
VCCB_SRC, behind R118: supply of the level translator. Two Schottky diodes on the Digital Inputs sheet clamp it to ground and +5V: -0.40 V (simulated) to +6.0 V

Output switch with slow turn-on, DUT connectors with their protection, guard buffer GND -4V_AC71

(calculated) with U25 at its rails; the limits of the translator are -0.5 V and 6.5 V (datasheet).

(simulated). Below one diode drop the gates decay through R117 with 31 ms. D20 also clamps the gates a diode drop below ground. R120 damps them while Q15 follows. Nothing resistive hangs on the node after the shunts: its current would be read as DUT current. C71 is the only capacitor there (C0G, 100 nF).

Leakage here and on VOUT adds to the reading: 4 nA to 6 nA typical at 5 V and 40 C

in the order of the PPK2: GND, VIN, VOUT, GND. VIN is the external supply of ampere mode. D21 is the only protection part on VOUT: a unidirectional suppressor, 15 V stand-off.
It takes electrostatic discharge and, forward biased, the current of the DUT cable when
the switch opens on a fault: up to 11.6 A (simulated), rated 50 A for 8.3 ms (datasheet).
Its leakage adds to the reading: 1 nA typical, 0.1 uA maximum at 15 V, 25 C (datasheet).

Instrument off: D21 holds the terminal between about -1 V (estimate) and +16.7 V, its
lowest breakdown voltage (datasheet); Q16 blocks 30 V (datasheet).
Output on: no part bounds VOUT between the set voltage and 16.7 V. No reverse-polarity
protection: a source limited to 0.5 A is held near -0.8 V (simulated), a stiff one destroys D21. J3 (pin header) and J4 (lever terminal block) carry the same nets, pin 1 to pin 4

A reading with the switch open is taken 200 ms or more after turn-off. Turn-on: the driver charges C74 and the gates through R117: 2.2 Mohm x 14.2 nF = 31 ms
(calculated, C74 plus the two gates). Q15 works as a source follower, so VOUT rises with the gate voltage: 90 % of 5 V after about 20 ms, in-rush 0.39 A into 1000 uF and 0.85 A into 2200 uF (simulated), below the trip level of 1.15 A. Turn-off: D20 and R116 discharge the gates into the driver: below 2 V within 7 us

R115 holds the gates low through R117 while the driver has no supply. No resistor from
OUT_GATE or the gate pins to GND or to the sources: with R117 it would divide the gate
voltage (100 kohm there leaves 0.52 V, calculated). OUT_GATE is a 2.2 Mohm node: a 10 Mohm probe lowers the gate from 12 V to 9.8 V (calculated).

The firmware closes this switch last and opens it first. For 250 ms after turn-on the
reading is low by the gate charging current: 0.5 uA at 30 ms, 4 nA at 200 ms (simulated).

Sheet: /Output Stage/
D Date: 2026-10-09 KiCad E.D.A. 10.0.0
File: output_stage.kicad_sch
Title: Output Switch, DUT Connectors and Guard Buffer

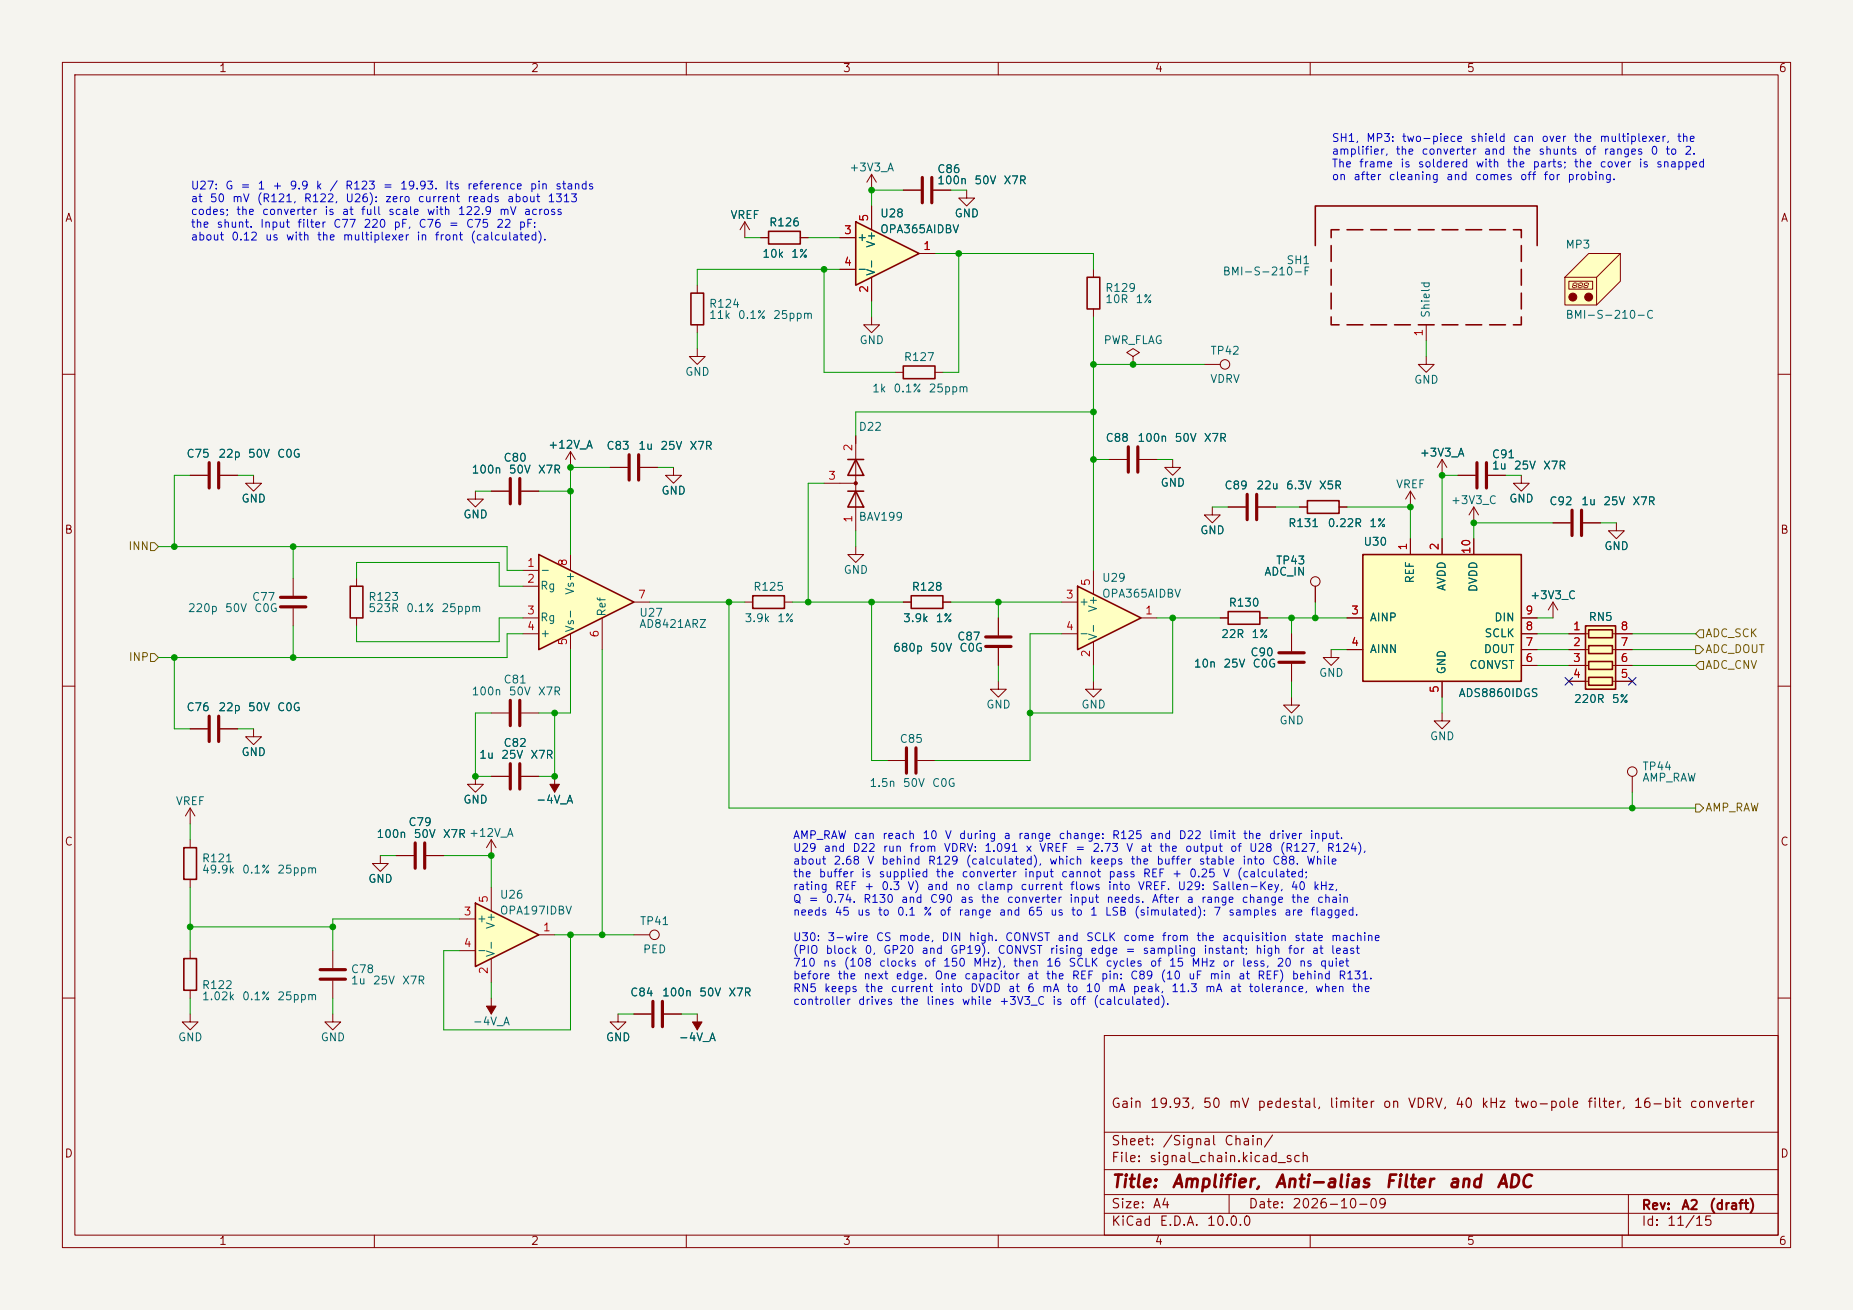
[picture p20: page 11]

SH1, MP3: two-piece shield can over the multiplexer, the amplifier, the converter and the shunts of ranges 0 to 2. The frame is soldered with the parts; the cover is snapped

U27: G = 1 + 9.9 k / R123 = 19.93. Its reference pin stands at 50 mV (R121, R122, U26): zero current reads about 1313

on after cleaning and comes off for probing.

codes; the converter is at full scale with 122.9 mV across
the shunt. Input filter C77 220 pF, C76 = C75 22 pF:

Gain 19.93, 50 mV pedestal, limiter on VDRV, 40 kHz two-pole filter, 16-bit converter Shield 1
VDRV R129

AMP_RAW can reach 10 V during a range change: R125 and D22 limit the driver input.
U29 and D22 run from VDRV: 1.091 x VREF = 2.73 V at the output of U28 (R127, R124),
about 2.68 V behind R129 (calculated), which keeps the buffer stable into C88. While
the buffer is supplied the converter input cannot pass REF + 0.25 V (calculated;
rating REF + 0.3 V) and no clamp current flows into VREF. U29: Sallen-Key, 40 kHz, Q = 0.74. R130 and C90 as the converter input needs. After a range change the chain

needs 45 us to 0.1 % of range and 65 us to 1 LSB (simulated): 7 samples are flagged.

U30: 3-wire CS mode, DIN high. CONVST and SCLK come from the acquisition state machine
(PIO block 0, GP20 and GP19). CONVST rising edge = sampling instant; high for at least 710 ns (108 clocks of 150 MHz), then 16 SCLK cycles of 15 MHz or less, 20 ns quiet

before the next edge. One capacitor at the REF pin: C89 (10 uF min at REF) behind R131. RN5 keeps the current into DVDD at 6 mA to 10 mA peak, 11.3 mA at tolerance, when the

controller drives the lines while +3V3_C is off (calculated).

Sheet: /Signal Chain/
D Date: 2026-10-09 KiCad E.D.A. 10.0.0
File: signal_chain.kicad_sch
Title: Amplifier, Anti-alias Filter and ADC

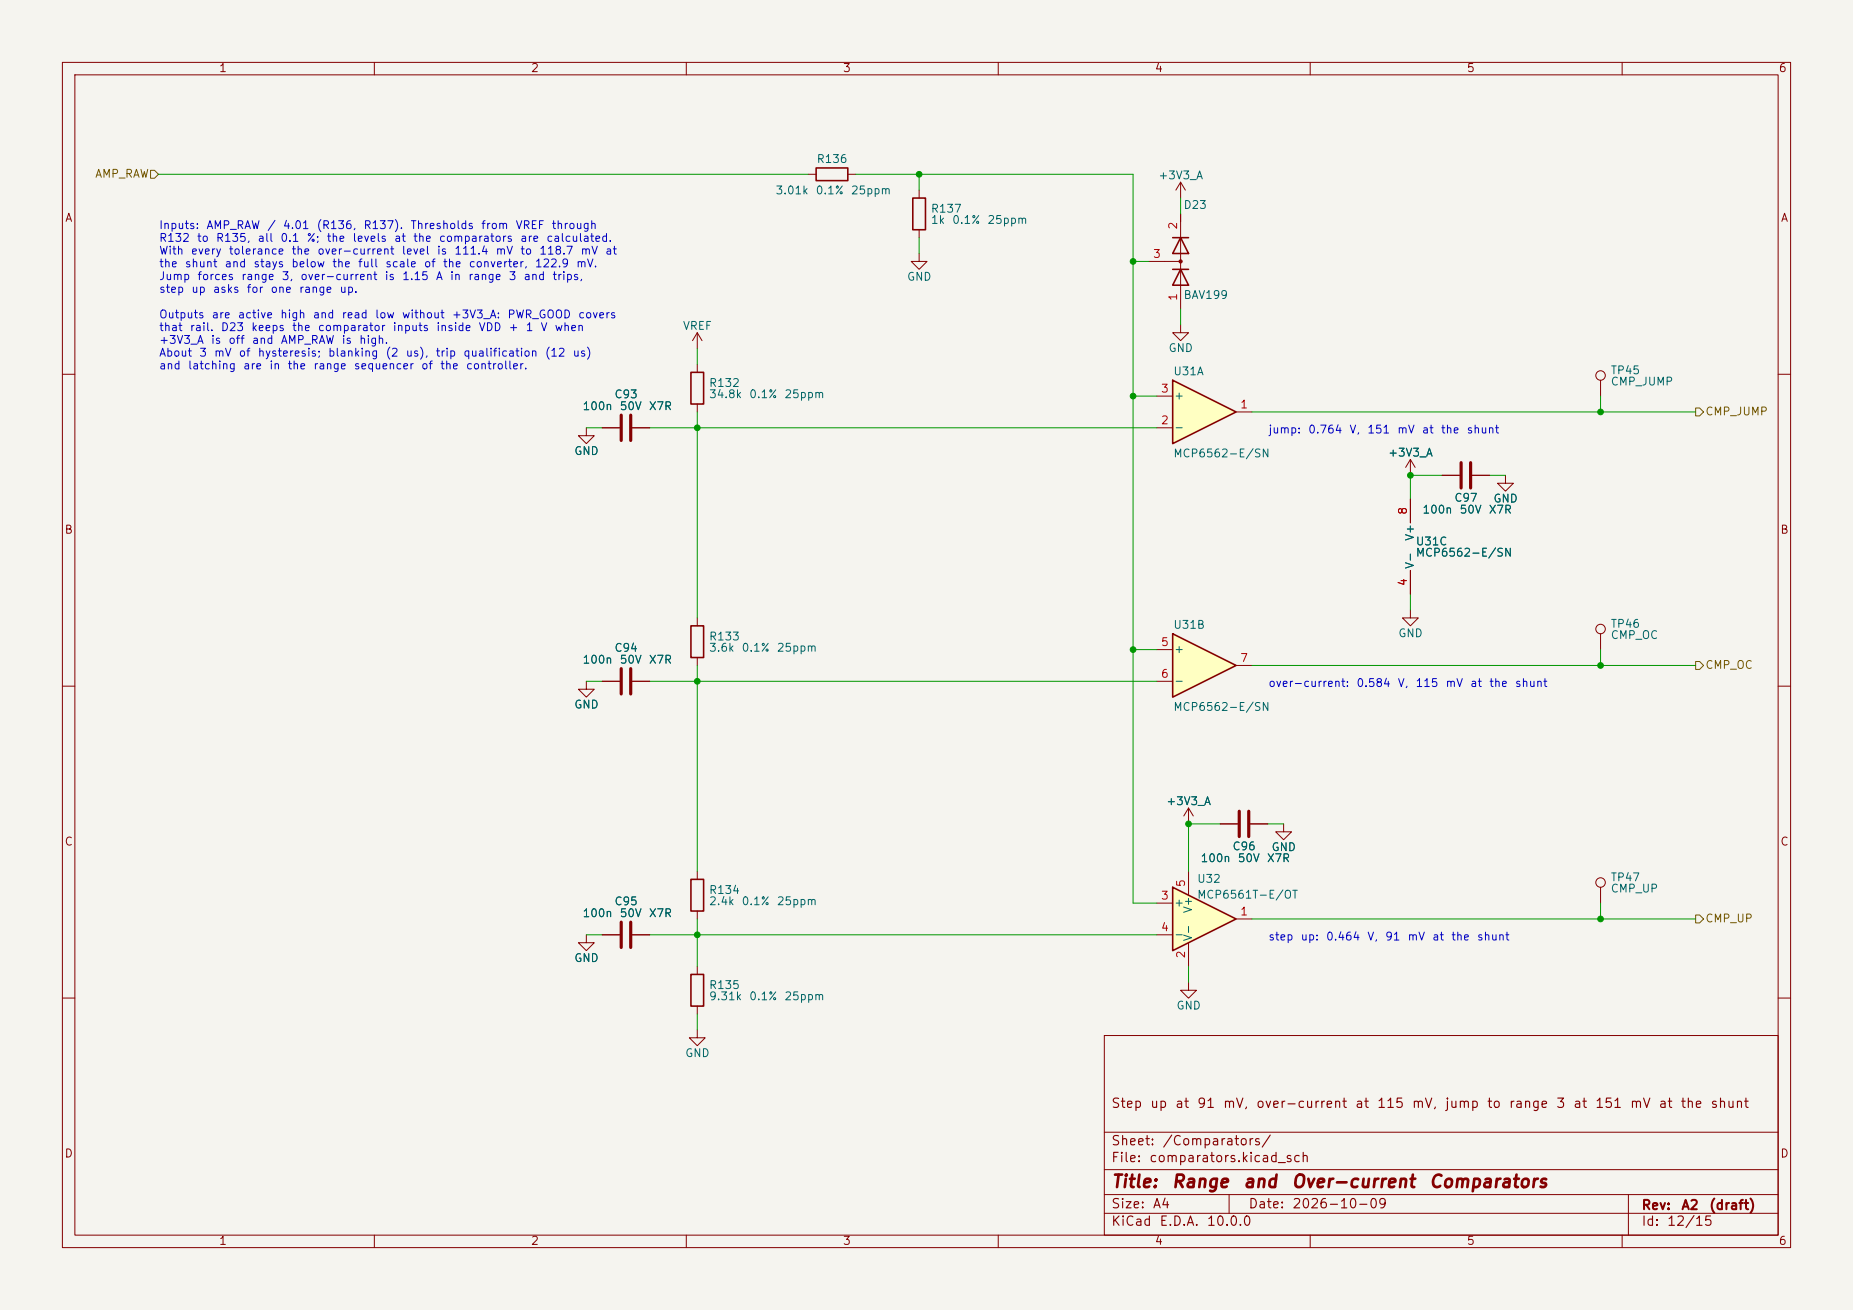
[picture p21: page 12]

Inputs: AMP_RAW / 4.01 (R136, R137). Thresholds from VREF through
R132 to R135, all 0.1 %; the levels at the comparators are calculated. With every tolerance the over-current level is 111.4 mV to 118.7 mV at

the shunt and stays below the full scale of the converter, 122.9 mV. Jump forces range 3, over-current is 1.15 A in range 3 and trips,

step up asks for one range up. Outputs are active high and read low without +3V3_A: PWR_GOOD covers

that rail. D23 keeps the comparator inputs inside VDD + 1 V when +3V3_A is off and AMP_RAW is high.

About 3 mV of hysteresis; blanking (2 us), trip qualification (12 us)

jump: 0.764 V, 151 mV at the shunt

over-current: 0.584 V, 115 mV at the shunt step up: 0.464 V, 91 mV at the shunt

Step up at 91 mV, over-current at 115 mV, jump to range 3 at 151 mV at the shunt GND

Sheet: /Comparators/
D Date: 2026-10-09 KiCad E.D.A. 10.0.0
File: comparators.kicad_sch
Title: Range and Over-current Comparators

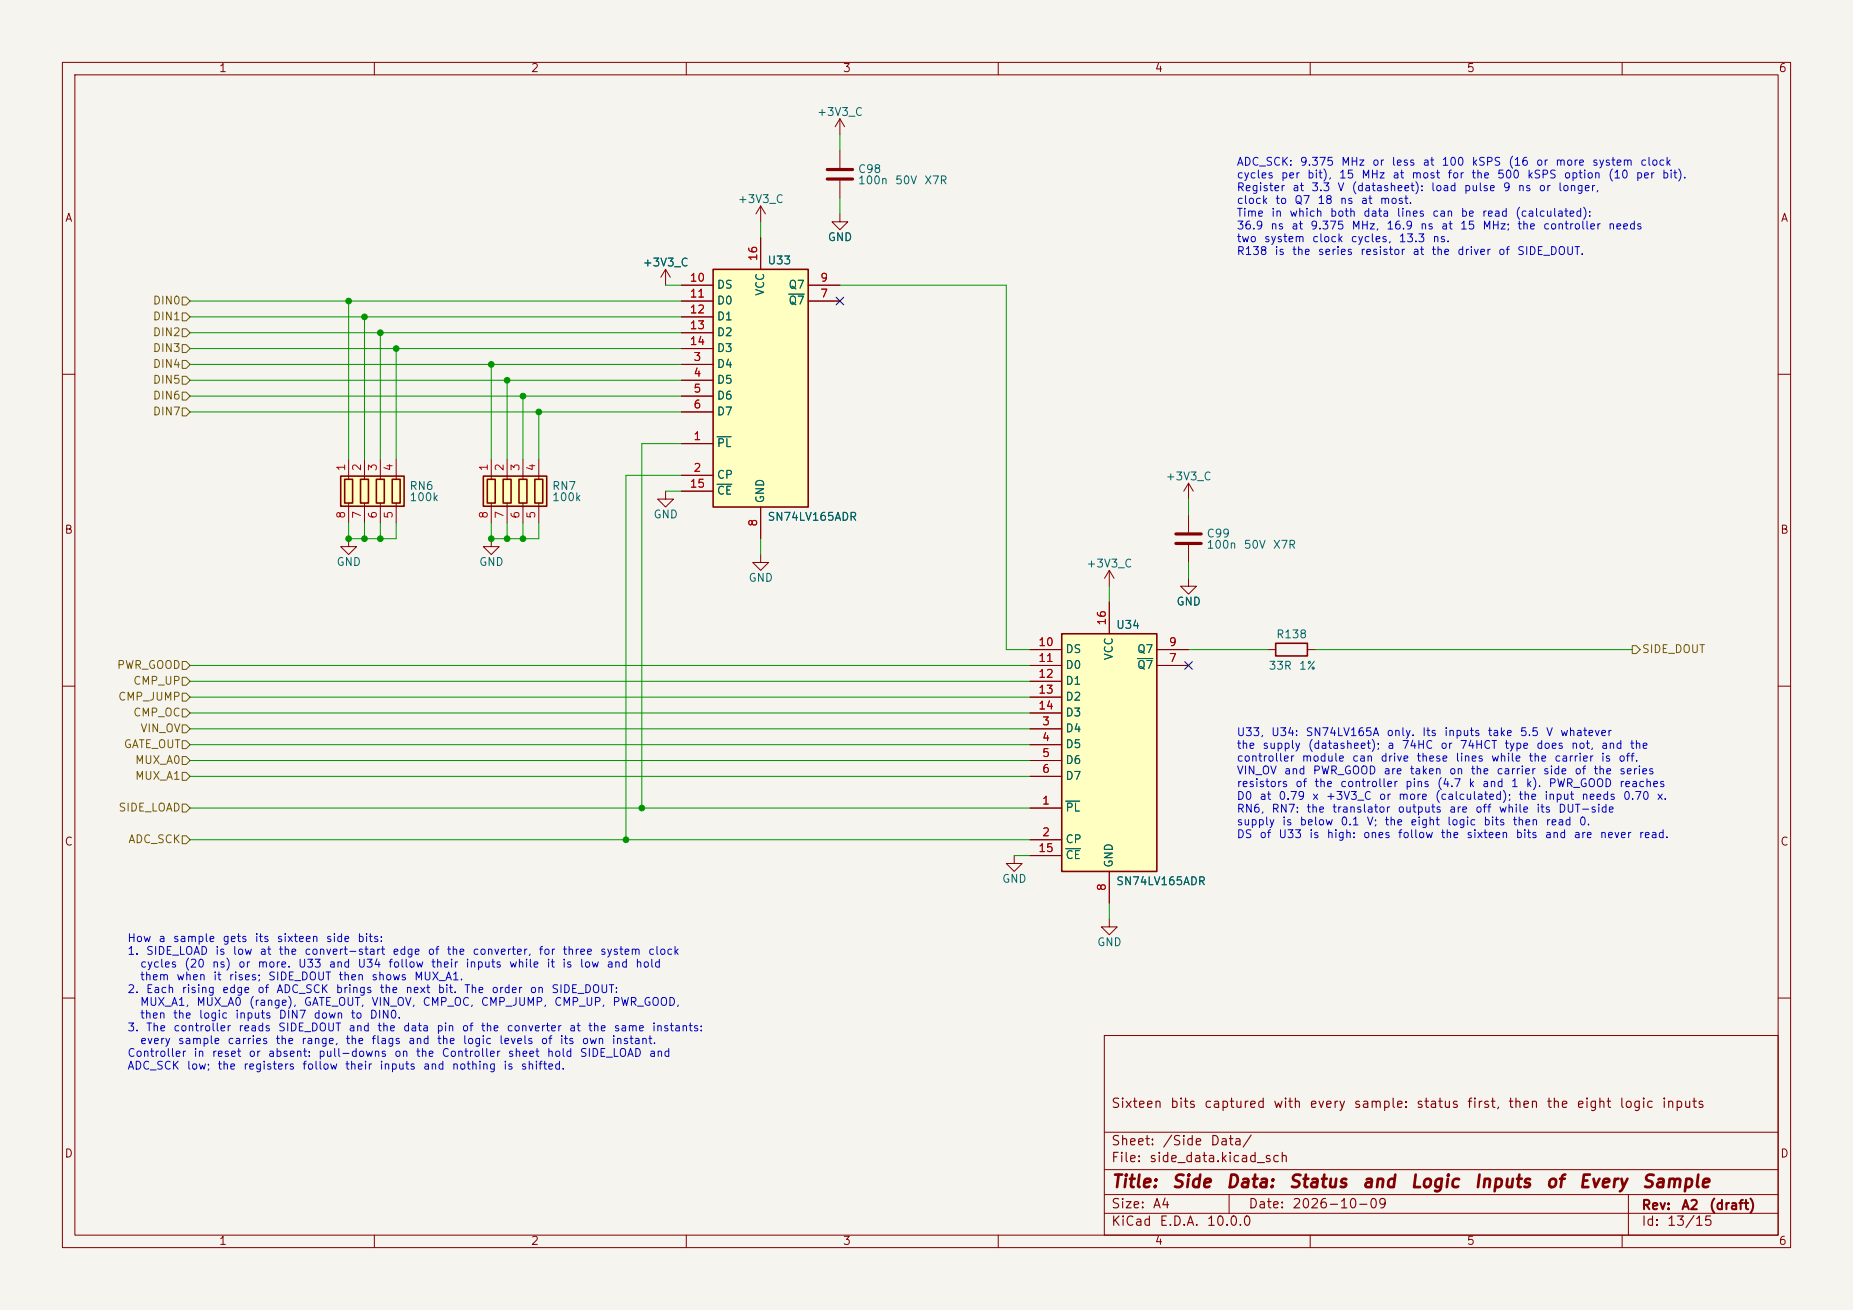
[picture p22: page 13]

ADC_SCK: 9.375 MHz or less at 100 kSPS (16 or more system clock cycles per bit), 15 MHz at most for the 500 kSPS option (10 per bit).

Register at 3.3 V (datasheet): load pulse 9 ns or longer,
clock to Q7 18 ns at most. Time in which both data lines can be read (calculated):

36.9 ns at 9.375 MHz, 16.9 ns at 15 MHz; the controller needs
two system clock cycles, 13.3 ns. R138 is the series resistor at the driver of SIDE_DOUT. U33, U34: SN74LV165A only. Its inputs take 5.5 V whatever

8 Q7 9 DS 10 D0 11 D1 12 D2 13 D3 14 CE 15 VCC 16 GND

Sixteen bits captured with every sample: status first, then the eight logic inputs GND

the supply (datasheet); a 74HC or 74HCT type does not, and the
controller module can drive these lines while the carrier is off. VIN_OV and PWR_GOOD are taken on the carrier side of the series

resistors of the controller pins (4.7 k and 1 k). PWR_GOOD reaches D0 at 0.79 x +3V3_C or more (calculated); the input needs 0.70 x. RN6, RN7: the translator outputs are off while its DUT-side

SIDE_LOAD
supply is below 0.1 V; the eight logic bits then read 0. DS of U33 is high: ones follow the sixteen bits and are never read. How a sample gets its sixteen side bits: 1. SIDE_LOAD is low at the convert-start edge of the converter, for three system clock cycles (20 ns) or more. U33 and U34 follow their inputs while it is low and hold

them when it rises; SIDE_DOUT then shows MUX_A1. 2. Each rising edge of ADC_SCK brings the next bit. The order on SIDE_DOUT: MUX_A1, MUX_A0 (range), GATE_OUT, VIN_OV, CMP_OC, CMP_JUMP, CMP_UP, PWR_GOOD, then the logic inputs DIN7 down to DIN0. 3. The controller reads SIDE_DOUT and the data pin of the converter at the same instants: every sample carries the range, the flags and the logic levels of its own instant. Controller in reset or absent: pull-downs on the Controller sheet hold SIDE_LOAD and

ADC_SCK low; the registers follow their inputs and nothing is shifted.

Sheet: /Side Data/
D Date: 2026-10-09 KiCad E.D.A. 10.0.0
File: side_data.kicad_sch
Title: Side Data: Status and Logic Inputs of Every Sample

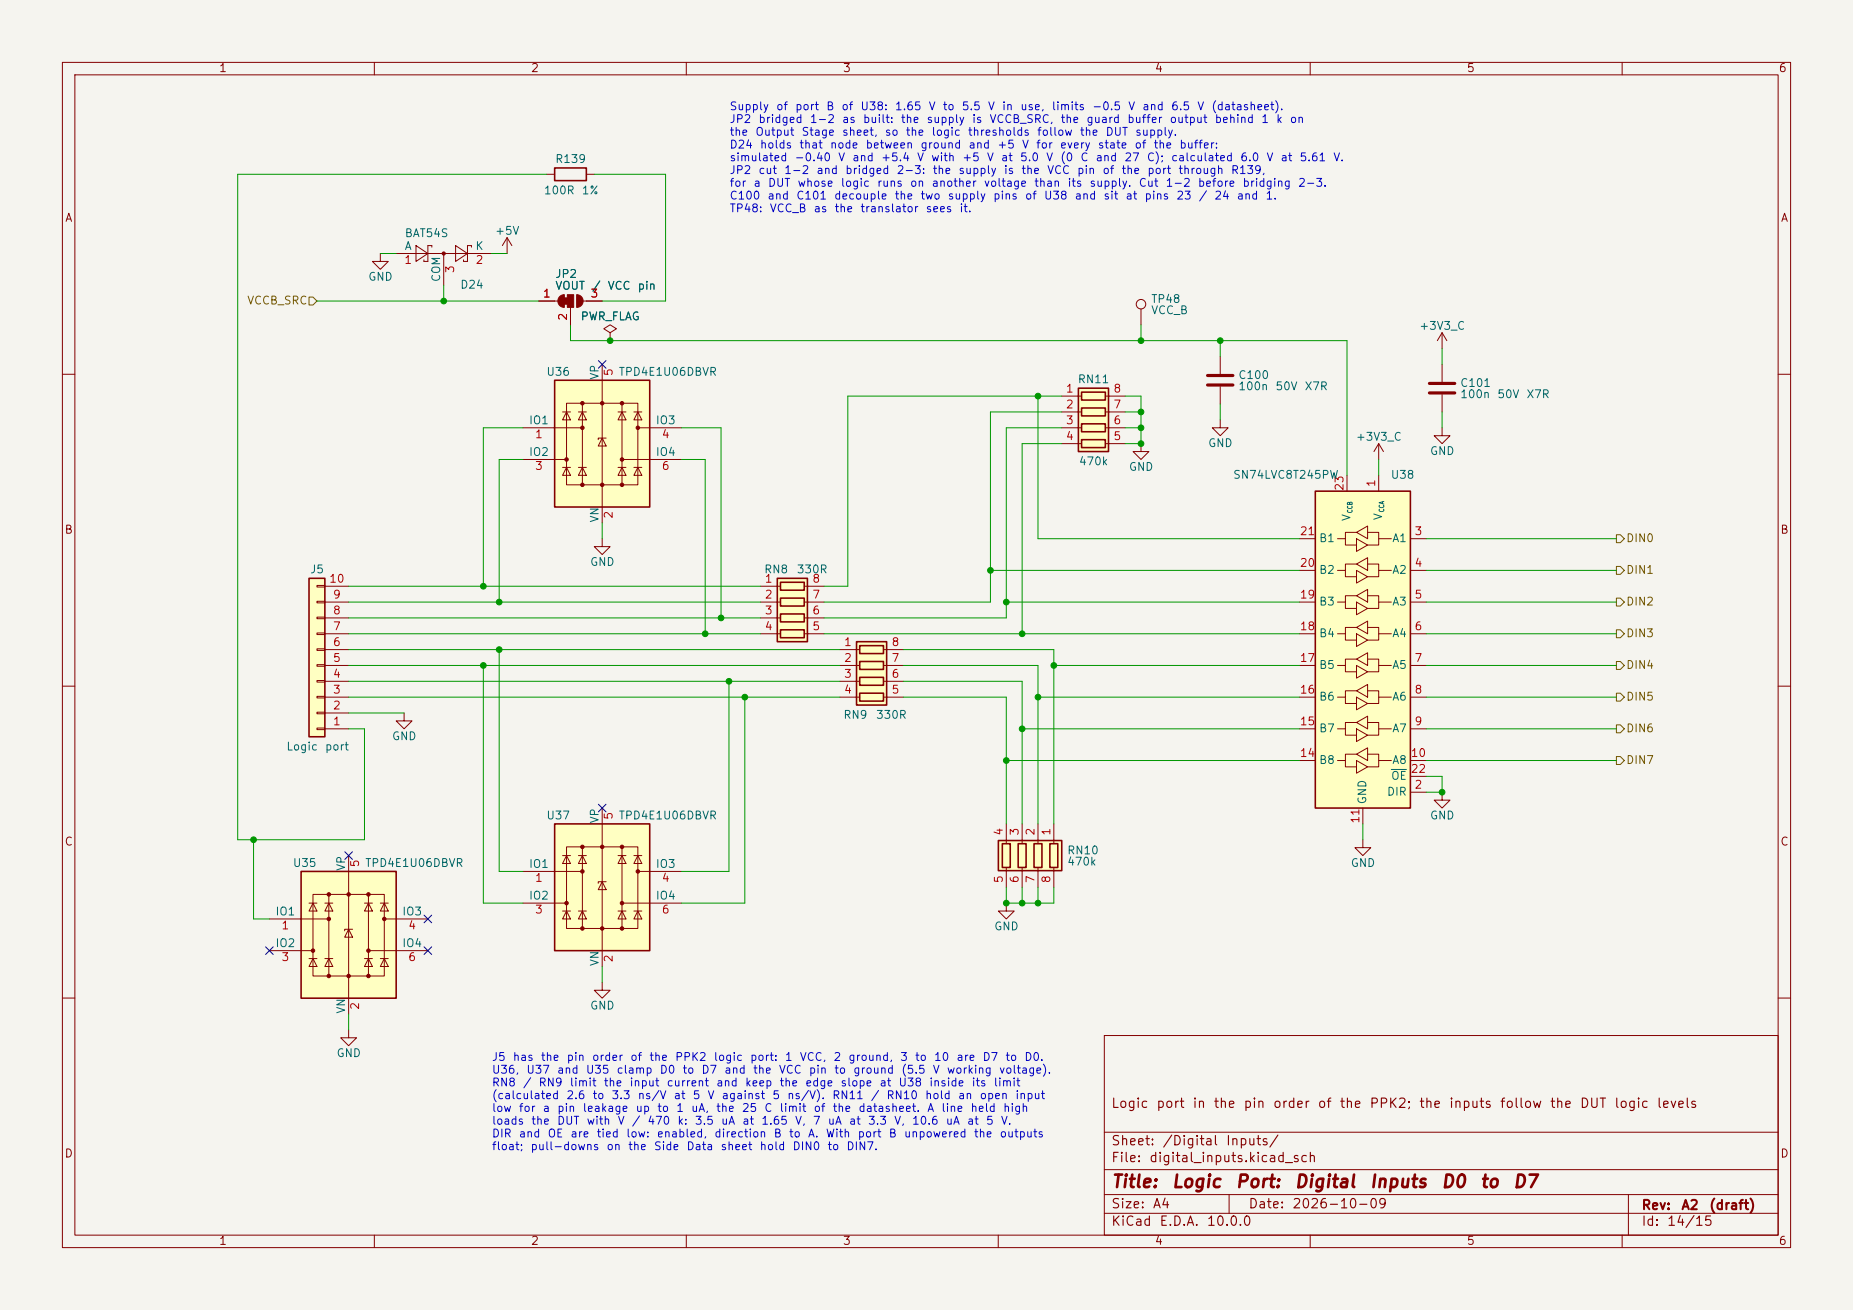
[picture p23: page 14]

Supply of port B of U38: 1.65 V to 5.5 V in use, limits -0.5 V and 6.5 V (datasheet).
JP2 bridged 1-2 as built: the supply is VCCB_SRC, the guard buffer output behind 1 k on
the Output Stage sheet, so the logic thresholds follow the DUT supply.
D24 holds that node between ground and +5 V for every state of the buffer: simulated -0.40 V and +5.4 V with +5 V at 5.0 V (0 C and 27 C); calculated 6.0 V at 5.61 V. JP2 cut 1-2 and bridged 2-3: the supply is the VCC pin of the port through R139, for a DUT whose logic runs on another voltage than its supply. Cut 1-2 before bridging 2-3. C100 and C101 decouple the two supply pins of U38 and sit at pins 23 / 24 and 1. TP48: VCC_B as the translator sees it.

2 1

J5 has the pin order of the PPK2 logic port: 1 VCC, 2 ground, 3 to 10 are D7 to D0. U36, U37 and U35 clamp D0 to D7 and the VCC pin to ground (5.5 V working voltage).

RN8 / RN9 limit the input current and keep the edge slope at U38 inside its limit (calculated 2.6 to 3.3 ns/V at 5 V against 5 ns/V). RN11 / RN10 hold an open input

Logic port in the pin order of the PPK2; the inputs follow the DUT logic levels

low for a pin leakage up to 1 uA, the 25 C limit of the datasheet. A line held high
loads the DUT with V / 470 k: 3.5 uA at 1.65 V, 7 uA at 3.3 V, 10.6 uA at 5 V. DIR and OE are tied low: enabled, direction B to A. With port B unpowered the outputs

Sheet: /Digital Inputs/
D Date: 2026-10-09 KiCad E.D.A. 10.0.0
File: digital_inputs.kicad_sch
Title: Logic Port: Digital Inputs D0 to D7

float; pull-downs on the Side Data sheet hold DIN0 to DIN7.

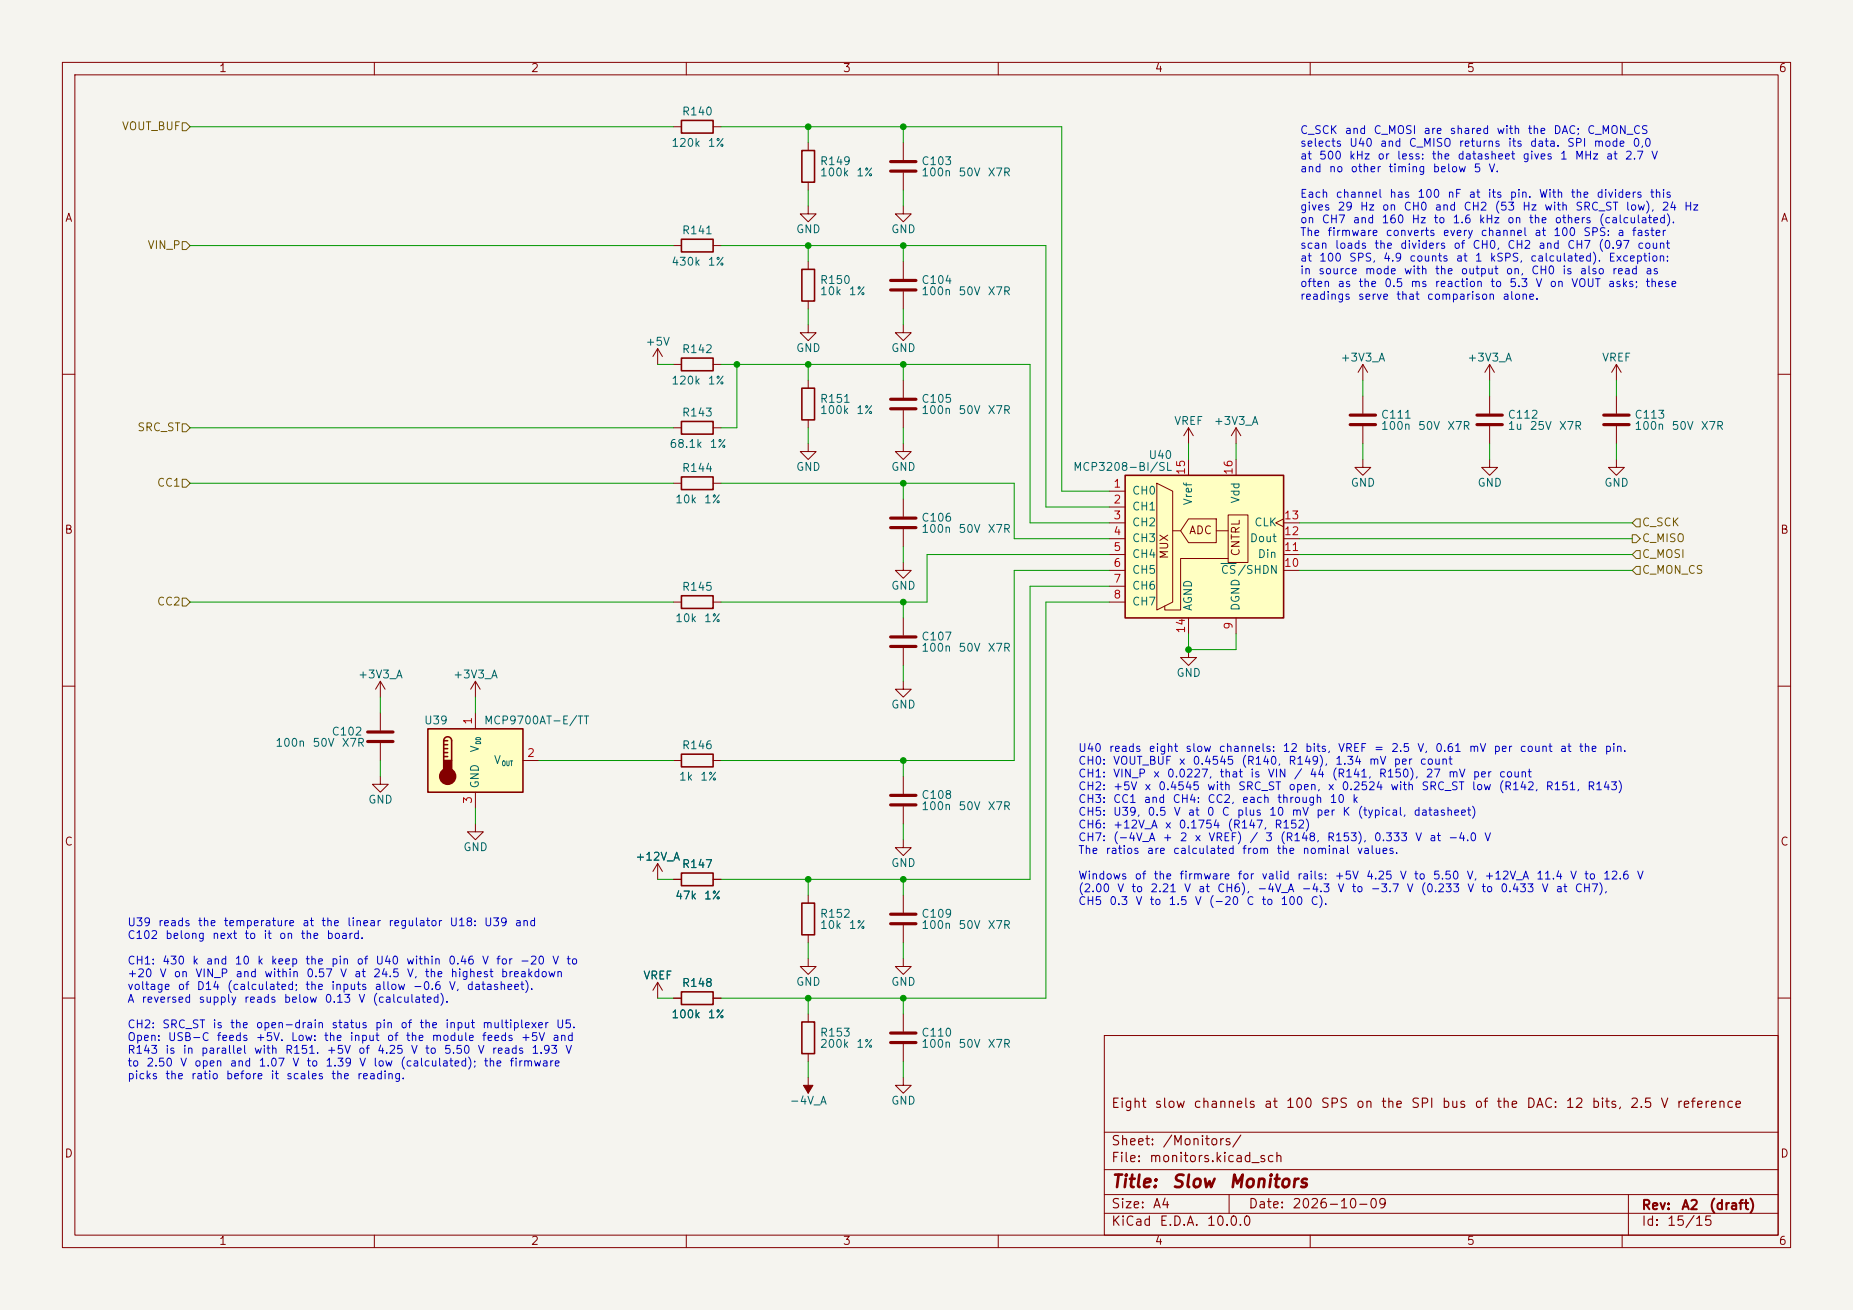
[picture p24: page 15]

selects U40 and C_MISO returns its data. SPI mode 0,0
at 500 kHz or less: the datasheet gives 1 MHz at 2.7 V and no other timing below 5 V. Each channel has 100 nF at its pin. With the dividers this gives 29 Hz on CH0 and CH2 (53 Hz with SRC_ST low), 24 Hz on CH7 and 160 Hz to 1.6 kHz on the others (calculated).

The firmware converts every channel at 100 SPS: a faster scan loads the dividers of CH0, CH2 and CH7 (0.97 count at 100 SPS, 4.9 counts at 1 kSPS, calculated). Exception:

in source mode with the output on, CH0 is also read as often as the 0.5 ms reaction to 5.3 V on VOUT asks; these

readings serve that comparison alone. U39 reads the temperature at the linear regulator U18: U39 and C102 belong next to it on the board. CH1: 430 k and 10 k keep the pin of U40 within 0.46 V for -20 V to +20 V on VIN_P and within 0.57 V at 24.5 V, the highest breakdown

9 CS/SHDN 10 Din 11 Dout 12 CLK 13 AGND 14 Vref 15 Vdd 16U40 MCP3208-BI/SL GND GND

U40 reads eight slow channels: 12 bits, VREF = 2.5 V, 0.61 mV per count at the pin.
CH0: VOUT_BUF x 0.4545 (R140, R149), 1.34 mV per count CH1: VIN_P x 0.0227, that is VIN / 44 (R141, R150), 27 mV per count CH2: +5V x 0.4545 with SRC_ST open, x 0.2524 with SRC_ST low (R142, R151, R143)

CH3: CC1 and CH4: CC2, each through 10 k CH5: U39, 0.5 V at 0 C plus 10 mV per K (typical, datasheet)

CH7: (-4V_A + 2 x VREF) / 3 (R148, R153), 0.333 V at -4.0 V
The ratios are calculated from the nominal values. Windows of the firmware for valid rails: +5V 4.25 V to 5.50 V, +12V_A 11.4 V to 12.6 V

voltage of D14 (calculated; the inputs allow -0.6 V, datasheet).
A reversed supply reads below 0.13 V (calculated).

CH2: SRC_ST is the open-drain status pin of the input multiplexer U5. Open: USB-C feeds +5V. Low: the input of the module feeds +5V and R143 is in parallel with R151. +5V of 4.25 V to 5.50 V reads 1.93 V

to 2.50 V open and 1.07 V to 1.39 V low (calculated); the firmware picks the ratio before it scales the reading.

Eight slow channels at 100 SPS on the SPI bus of the DAC: 12 bits, 2.5 V reference
