Guiimartinho/open-power-profiler/hardware/kicad/power-profiler-carrier.kicad_pcb

## KiCad design hardware/kicad/power-profiler-carrier.kicad_pcb (2026-10-14)

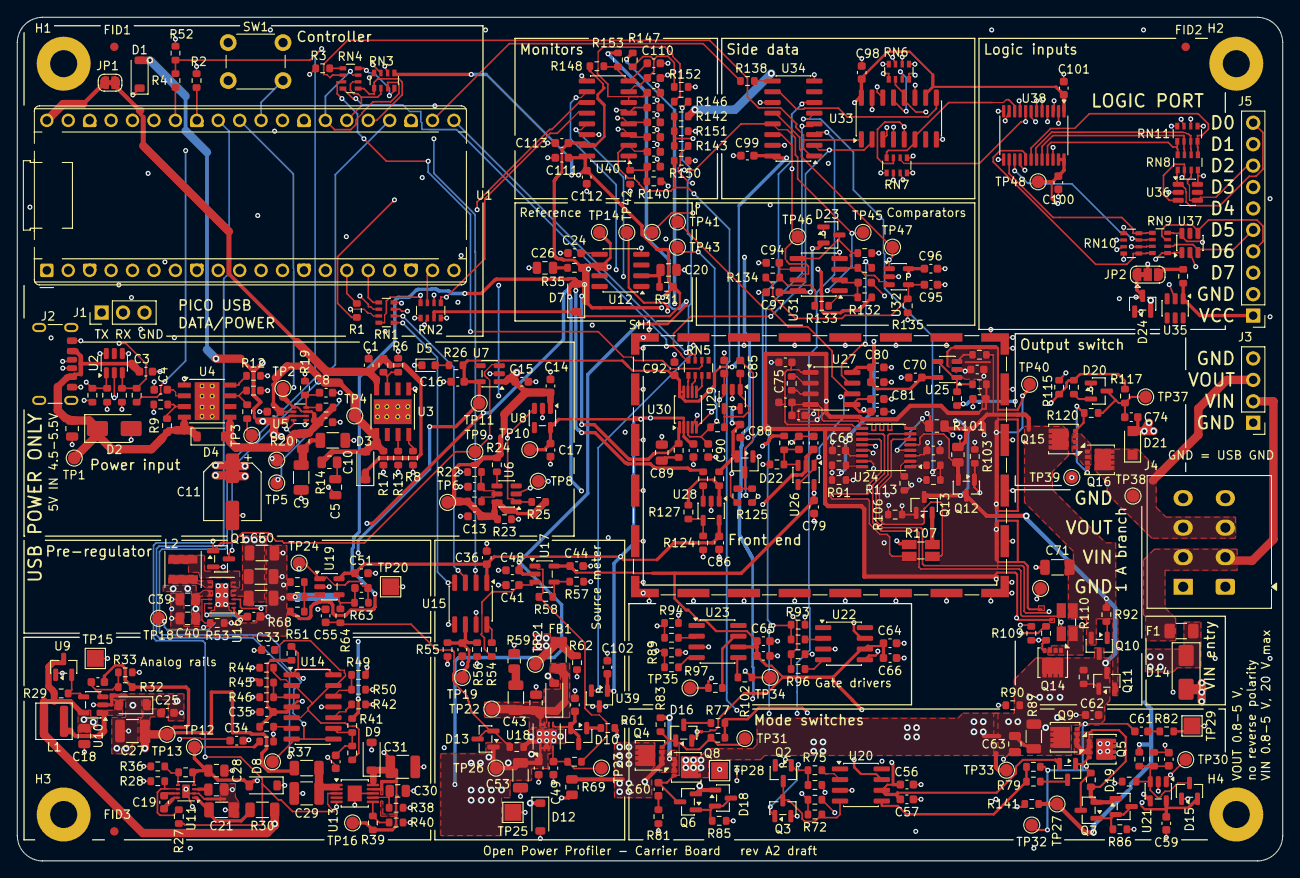
[picture p25: board power-profiler-carrier.kicad_pcb from above]

Board: 4 copper layers, 150.0 x 100.0 mm, 425 parts (0 on the bottom side), 225 nets.

Parts:
C1, C3, C13, C25, C35, C36, C37, C38, C44, C48, C49, C51, C54, C55, C57, C59, C60, C61, C66, C67, C68, C69, C70, C72, C73, C79, C80, C81, C84, C86, C88, C93, C94, C95, C96, C97, C98, C99, C100, C101, C102, C103, C104, C105, C106, C107, C108, C109, C110, C111, C113: 100n 50V X7R; C_0603_1608Metric
C2, C18, C20, C22, C28, C30, C63: 4.7u 25V X7R; C_0805_2012Metric
C4: 3.3n 50V X7R; C_0603_1608Metric
C5, C39, C40, C46: 10u 25V X5R; C_0805_2012Metric
C6, C7, C14, C15, C16, C17, C19, C24, C41, C47, C56, C62, C64, C65, C78, C82, C83, C91, C92, C112: 1u 25V X7R; C_0603_1608Metric
C8: 33n 50V X7R; C_0603_1608Metric
C9, C10, C21: 22u 10V X7R; C_1206_3216Metric
C11: 47u 16V; CP_Elec_6.3x5.4
C12, C58: 1n 50V C0G; C_0603_1608Metric
C23, C77: 220p 50V C0G; C_0603_1608Metric
C26: 10u 16V X7R; C_0805_2012Metric
C27, C29, C31: 10u 25V X7R; C_1210_3225Metric
C32, C33, C34, C74: 10n 50V C0G; C_0603_1608Metric
C42, C43, C45, C50, C53: 22u 25V X5R; C_1206_3216Metric
C52: 10p 50V C0G; C_0603_1608Metric
C71: 100n 50V C0G; C_1206_3216Metric
C75, C76: 22p 50V C0G; C_0603_1608Metric
C85: 1.5n 50V C0G; C_0603_1608Metric
C87: 680p 50V C0G; C_0603_1608Metric
C89: 22u 6.3V X5R; C_0805_2012Metric
C90: 10n 25V C0G; C_0603_1608Metric
D1, D3, D4, D11, D12: 1N5819HW; D_SOD-123
D2: SMAJ10A; D_SMA
D5: green 2.0V; LED_0603_1608Metric
D6, D7, D8, D9: B0530W 30V 0.5A; D_SOD-123
D10, D13, D15, D16, D17, D18, D19, D20, D22, D23: BAV199; SOT-23
D14: SMAJ20CA; D_SMA
D21: PTVS15VS1UR; Nexperia_CFP3_SOD-123W
D24: BAT54S; SOT-23
F1: 4A fast 32V; Fuse_1206_3216Metric
FB1: 50R 12A; L_1206_3216Metric
FID1, FID2, FID3: Fiducial; Fiducial_1mm_Mask2mm
H1, H2, H3, H4: M3; MountingHole_3.2mm_M3_Pad
J1: Debug UART; PinHeader_1x03_P2.54mm_Vertical
J2: USB-C power; USB_C_Receptacle_GCT_USB4125-xx-x_6P_TopMnt_Horizontal
J3: DUT; PinHeader_1x04_P2.54mm_Vertical
J4: DUT wires; TerminalBlock_WAGO_2601-1104_1x04_P3.50mm_Horizontal_Pad1.9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
J5: Logic port; PinHeader_1x10_P2.54mm_Vertical
JP1: USB of Pico feeds +5V; SolderJumper-2_P1.3mm_Bridged_RoundedPad1.0x1.5mm
JP2: VOUT / VCC pin; SolderJumper-3_P1.3mm_Bridged12_RoundedPad1.0x1.5mm
L1: 10u 3A; L_Wuerth_MAPI-4030
L2: 1.5u 4.6A; L_Coilcraft_XxL4020
Q1, Q2, Q3: BSS138; SOT-23
Q4, Q5, Q8, Q9, Q14, Q15, Q16: CSD17577Q3A; VSON-8_3.3x3.3mm_P0.65mm_NexFET
Q6, Q7: BC847B; SOT-23
Q10, Q11, Q12, Q13: IRLML0030; SOT-23
R1, R71: 4.7k 1%; R_0603_1608Metric
R2: 0R; R_0603_1608Metric
R3, R51: 1.5k 1%; R_0603_1608Metric
R4, R26, R53, R60, R62, R70, R72, R75, R88, R89, R93, R94, R96, R97, R98, R99, R111, R112, R118, R146: 1k 1%; R_0603_1608Metric
R5, R9: 4.53k 1%; R_0603_1608Metric
R6, R10: 3.01k 1%; R_0603_1608Metric
R7, R11, R91, R95: 5.1k 1%; R_0603_1608Metric
R8, R12: 402k 1%; R_0603_1608Metric
R13: 1.21k 1%; R_0603_1608Metric
R14, R20, R59: 0.33R 1%; R_0805_2012Metric
R15: 453R 1%; R_0603_1608Metric
R16, R19, R23, R25, R41, R54, R113, R114, R126, R144, R145, R150, R152: 10k 1%; R_0603_1608Metric
R17, R24, R27, R42, R50, R78, R80, R85, R86, R90, R103, R106, R109, R115, R148, R149, R151: 100k 1%; R_0603_1608Metric
R18: 13.7k 1%; R_0603_1608Metric
R21: 86.6k 0.1%; R_0603_1608Metric
R22, R57: 10k 0.1% 25ppm; R_0603_1608Metric
R28: 150k 1%; R_0603_1608Metric
R29: 51k 1%; R_0603_1608Metric
R30: 2.2R 1% 0.25W; R_1206_3216Metric
R31, R61, R108, R120, R129: 10R 1%; R_0603_1608Metric
R32: 133k 1%; R_0603_1608Metric
R33: 13.3k 1%; R_0603_1608Metric
R34: 226k 0.1%; R_0603_1608Metric
R35: 1R 1%; R_0603_1608Metric
R36, R67, R74: 100k 0.1% 25ppm; R_0603_1608Metric
R37: 0.47R 1% 0.25W; R_1206_3216Metric
R38: 120k 0.1%; R_0603_1608Metric
R39: 442k 1%; R_0603_1608Metric
R40: 12.4k 1%; R_0603_1608Metric
R43: 40.2k 1%; R_0603_1608Metric
R44, R46, R47: 49.9k 1%; R_0603_1608Metric
R45: 249k 1%; R_0603_1608Metric
R48: 127k 1%; R_0603_1608Metric
R49: 36.5k 1%; R_0603_1608Metric
R52, R81, R82: 6.8k 1%; R_0603_1608Metric
R55, R56: 2.00k 0.1% 25ppm; R_0603_1608Metric
R58, R124: 11k 0.1% 25ppm; R_0603_1608Metric
R63: 19.1k 0.1% 25ppm; R_0603_1608Metric
R64: 93.1k 0.1% 25ppm; R_0603_1608Metric
R65: 6.65k 0.1% 25ppm; R_0603_1608Metric
R66: 23.7k 0.1% 25ppm; R_0603_1608Metric
R68: 137k 0.1% 25ppm; R_0603_1608Metric
R69: 1.3k 1%; R_0805_2012Metric
R73: 115k 0.1%; R_0603_1608Metric
R76: 3.3M 1%; R_0603_1608Metric
R77, R79, R92, R100, R130: 22R 1%; R_0603_1608Metric
R83, R84, R117: 2.2M 1%; R_0603_1608Metric
R87: 0.47R 1% 0.5W; R_1206_3216Metric
R101: 1k 0.1% 25ppm; R_0805_2012Metric
R102, R105, R119: 47R 1%; R_0603_1608Metric
R104: 33R 0.1% 25ppm; R_0805_2012Metric
R107: 1R 0.5% 25ppm; R_Shunt_Ohmite_LVK12
R110: 0.1R 0.25% 50ppm; R_Shunt_Ohmite_LVK12
R116: 220R 1%; R_0603_1608Metric
R121: 49.9k 0.1% 25ppm; R_0603_1608Metric
R122: 1.02k 0.1% 25ppm; R_0603_1608Metric
R123: 523R 0.1% 25ppm; R_0603_1608Metric
R125, R128: 3.9k 1%; R_0603_1608Metric
R127, R137: 1k 0.1% 25ppm; R_0603_1608Metric
R131: 0.22R 1%; R_0603_1608Metric
R132: 34.8k 0.1% 25ppm; R_0603_1608Metric
R133: 3.6k 0.1% 25ppm; R_0603_1608Metric
R134: 2.4k 0.1% 25ppm; R_0603_1608Metric
R135: 9.31k 0.1% 25ppm; R_0603_1608Metric
R136: 3.01k 0.1% 25ppm; R_0603_1608Metric
R138: 33R 1%; R_0603_1608Metric
R139: 100R 1%; R_0603_1608Metric
R140, R142: 120k 1%; R_0603_1608Metric
R141: 430k 1%; R_0603_1608Metric
R143: 68.1k 1%; R_0603_1608Metric
R147: 47k 1%; R_0603_1608Metric
R153: 200k 1%; R_0603_1608Metric
RN1: 2.2k; R_Array_Convex_4x0603
RN2, RN3: 4.7k; R_Array_Convex_4x0603
RN4: 47R; R_Array_Convex_4x0603
RN5: 220R 5%; R_Array_Convex_4x0603
RN6, RN7: 100k; R_Array_Convex_4x0603
RN8, RN9: 330R; R_Array_Convex_4x0603
RN10, RN11: 470k; R_Array_Convex_4x0603
SH1: BMI-S-210-F; Laird_Technologies_BMI-S-210-F_44.00x30.50mm
SW1: RESET; SW_PUSH_6mm
TP1: VBUS_C; TestPoint_Pad_D1.5mm
TP2: VBUS_CP; TestPoint_Pad_D1.5mm
TP3: IMON; TestPoint_Pad_D1.5mm
TP4: VBUS_P; TestPoint_Pad_D1.5mm
TP5: SRC; TestPoint_Pad_D1.5mm
TP6: +5V; TestPoint_Pad_D1.5mm
TP7, TP8, TP39: GND; TestPoint_Pad_D1.5mm
TP9: 5V_OK; TestPoint_Pad_D1.5mm
TP10: +3V3_A; TestPoint_Pad_D1.5mm
TP11: +3V3_C; TestPoint_Pad_D1.5mm
TP12: -4V_A; TestPoint_Pad_D1.5mm
TP13: +13V5; TestPoint_Pad_D1.5mm
TP14: VREF; TestPoint_Pad_D1.5mm
TP15, TP20, TP25, TP28, TP29: GND; TestPoint_Pad_2.0x2.0mm
TP16: +12V_A; TestPoint_Pad_D1.5mm
TP17: PWR_GOOD; TestPoint_Pad_D1.5mm
TP18: SMU_EN; TestPoint_Pad_D1.5mm
TP19: VREF_DAC; TestPoint_Pad_D1.5mm
TP21: V_PRE; TestPoint_Pad_D1.5mm
TP22: LDO_IN; TestPoint_Pad_D1.5mm
TP23: LDO_SET; TestPoint_Pad_D1.5mm
TP24: PRE_FB; TestPoint_Pad_D1.5mm
TP26: LDO_OUT; TestPoint_Pad_D1.5mm
TP27: VIN_P; TestPoint_Pad_D1.5mm
TP30: VIN_OV; TestPoint_Pad_D1.5mm
TP31: SRC_G; TestPoint_Pad_D1.5mm
TP32: AMP_G; TestPoint_Pad_D1.5mm
TP33: SUPPLY; TestPoint_Pad_D1.5mm
TP34: G_R1; TestPoint_Pad_D1.5mm
TP35: G_R2; TestPoint_Pad_D1.5mm
TP36: G_R3; TestPoint_Pad_D1.5mm
TP37: OUT_GATE; TestPoint_Pad_D1.5mm
TP38: VOUT; TestPoint_Pad_D1.5mm
TP40: GUARD; TestPoint_Pad_D1.5mm
TP41: PED; TestPoint_Pad_D1.5mm
TP42: VDRV; TestPoint_Pad_D1.5mm
TP43: ADC_IN; TestPoint_Pad_D1.5mm
TP44: AMP_RAW; TestPoint_Pad_D1.5mm
TP45: CMP_JUMP; TestPoint_Pad_D1.5mm
TP46: CMP_OC; TestPoint_Pad_D1.5mm
TP47: CMP_UP; TestPoint_Pad_D1.5mm
TP48: VCC_B; TestPoint_Pad_D1.5mm
U1: Raspberry Pi Pico 2; RaspberryPi_Pico_Common_THT_NoKeepout
U2, U35, U36, U37: TPD4E1U06DBVR; SOT-23-6
U3, U4: TPS259621DDAR; TI_SO-PowerPAD-8_ThermalVias
U5: TPS2116DRLR; SOT-583-8
U6: TPS3808G01DBVR; SOT-23-6
U7, U8: LP5907MFX-3.3; SOT-23-5
U9: Detector, ms time-out; SOT-23
U10: LMR62014XMF; SOT-23-5
U11: LM27761DSG; WSON-8-1EP_2x2mm_P0.5mm_EP0.9x1.6mm
U12: REF5025AID; SOIC-8_3.9x4.9mm_P1.27mm
U13: LT3042EMSE; MSOP-10-1EP_3x3mm_P0.5mm_EP1.68x1.88mm
U14: MCP6569-E/SL; SOIC-14_3.9x8.7mm_P1.27mm
U15: MCP4921-E/SN; SOIC-8_3.9x4.9mm_P1.27mm
U16: TPS63020DSJ; Texas_R-PVSON-N14_3x4mm_P0.5mm_EP1.58x2.85mm
U17, U25, U26: OPA197IDBV; SOT-23-5
U18: LT3080EDD; DFN-8-1EP_3x3mm_P0.5mm_EP1.66x2.38mm
U19, U28, U29: OPA365AIDBV; SOT-23-5
U20, U22, U23: TC4427EOA; SOIC-8_3.9x4.9mm_P1.27mm
U21, U32: MCP6561T-E/OT; SOT-23-5
U24: MUX509IPWR; TSSOP-16_4.4x5mm_P0.65mm
U27: AD8421ARZ; SOIC-8_3.9x4.9mm_P1.27mm
U30: ADS8860IDGS; MSOP-10_3x3mm_P0.5mm
U31: MCP6562-E/SN; SOIC-8_3.9x4.9mm_P1.27mm
U33, U34: SN74LV165ADR; SOIC-16_3.9x9.9mm_P1.27mm
U38: SN74LVC8T245PW; TSSOP-24_4.4x7.8mm_P0.65mm
U39: MCP9700AT-E/TT; SOT-23
U40: MCP3208-BI/SL; SOIC-16_3.9x9.9mm_P1.27mm

Connections:
+3V3_A: C17.1, C36.1, C51.1, C59.1, C86.1, C91.1, C96.1, C97.1, C102.1, C111.1, C112.1, D7.1 (K), D15.2 (K), D23.2 (K), R31.1, R42.1, RN2.7 (R2.2), RN3.5 (R4.2), TP10.1 (1_1), U8.5 (OUT), U15.1 (Vdd), U19.5 (V+), U21.5 (V+), U28.5 (V+), U30.2 (AVDD), U31.8 (V+), U32.5 (V+), U39.1 (V_{DD}), U40.16 (Vdd)
+3V3_C: C16.1, C35.1, C92.1, C98.1, C99.1, C101.1, R26.1, R41.1, R47.1, R51.1, TP11.1 (1_1), U7.5 (OUT), U14.4 (V+), U30.9 (DIN), U30.10 (DVDD), U33.10 (DS), U33.16 (VCC), U34.16 (VCC), U38.1 (V_{CCA})
+5V: C11.1, C13.1, C14.1, C15.1, C18.1, C39.1, C40.1, D1.2 (A), D24.2 (K), L1.1, R21.1, R23.1, R24.1, R25.1, R29.1, R30.1, R142.1, TP6.1 (1_1), U5.2 (VOUT), U5.7 (VOUT), U6.6 (VDD), U7.1 (IN), U8.1 (IN), U9.3 (V_{DD}), U10.5 (VIN), U16.10 (VIN), U16.11 (VIN)
+12V_A: C31.1, C44.1, C56.1, C57.1, C64.1, C65.1, C66.1, C67.1, C68.1, C70.1, C79.1, C80.1, C83.1, D9.1 (K), D16.2 (K), D17.2 (K), R39.1, R45.1, R113.1, R147.1, TP16.1 (1_1), U13.9 (OUTS), U13.10 (OUT), U17.5 (V+), U20.6 (V_{DD}), U22.6 (V_{DD}), U23.6 (V_{DD}), U24.14 (VDD), U25.5 (V+), U26.5 (V+), U27.8 (Vs+)
+13V5: C23.1, C25.1, C27.1, D6.1 (K), R32.1, R37.1, R61.1, TP13.1 (1_1)
-4V_A: C28.2, C48.2, C69.2, C72.2, C81.2, C82.2, C84.2, D8.2 (A), R34.2, R48.2, R69.2, R153.2, TP12.1 (1_1), U11.4 (VOUT), U17.2 (V-), U24.3 (VSS), U25.2 (V-), U26.2 (V-), U27.5 (Vs-)
/Analog Rails/5V_OK: Q1.1 (G), R25.2, R27.1, TP9.1 (1_1), U6.1 (~RESET), U7.3 (EN), U8.3 (EN), U13.3 (EN/UV)
/Comparators/AMP_RAW: R125.1, R136.1, TP44.1 (1_1), U27.7
/Comparators/CMP_JUMP: TP45.1 (1_1), U1.12 (GPIO9), U31.1, U34.13 (D2)
/Comparators/CMP_OC: TP46.1 (1_1), U1.14 (GPIO10), U31.7, U34.14 (D3)
/Comparators/CMP_UP: TP47.1 (1_1), U1.11 (GPIO8), U32.1, U34.12 (D1)
/Controller/ADC_CNV: RN4.7 (R2.2), RN5.6 (R3.2)
/Controller/ADC_DOUT: RN5.7 (R2.2), U1.21 (GPIO16)
/Controller/ADC_SCK: RN4.8 (R1.2), RN5.8 (R1.2), U33.2 (CP), U34.2 (CP)
/Controller/C_DAC_CS: R3.2, U15.2 (~CS)
/Controller/C_MISO: RN1.8 (R1.2), RN2.1 (R1.1), U40.12 (Dout)
/Controller/C_MON_CS: RN1.7 (R2.2), U40.10 (~CS/SHDN)
/Controller/C_MOSI: RN1.5 (R4.2), U15.4 (SDI), U40.11 (Din)
/Controller/C_SCK: RN1.6 (R3.2), U15.3 (SCK), U40.13 (CLK)
/Controller/GATE_AMP: R71.1, R72.1, U1.32 (GPIO27_ADC1)
/Controller/GATE_OUT: R93.1, R98.1, U1.10 (GPIO7), U34.4 (D5)
/Controller/GATE_R1: R89.1, R97.1, U1.4 (GPIO2)
/Controller/GATE_R2: R94.1, R99.1, U1.5 (GPIO3)
/Controller/GATE_R3: R88.1, R96.1, U1.6 (GPIO4)
/Controller/GATE_SRC: Q2.1 (G), R70.1, R75.1, U1.31 (GPIO26_ADC0)
/Controller/MUX_A0: R95.1, R112.1, U1.7 (GPIO5), U34.5 (D6)
/Controller/MUX_A1: R91.1, R111.1, U1.9 (GPIO6), U34.6 (D7)
/Controller/PICO_5V: C1.1, D3.1 (K), JP1.2 (B), R5.1, U3.4 (VIN)
/Controller/PWR_GOOD: R4.1, R51.2, R52.1, TP17.1 (1_1), U14.1, U14.7, U14.8, U14.14, U34.11 (D0)
/Controller/SIDE_DOUT: R138.2, U1.22 (GPIO17)
/Controller/SIDE_LOAD: RN4.6 (R3.2), U33.1 (~PL), U34.1 (~PL)
/Controller/SMU_ON: Q1.3 (D), U1.24 (GPIO18)
/Controller/VIN_OV: Q3.1 (G), R1.1, R76.2, TP30.1 (1_1), U21.1, U34.3 (D4)
/Digital Inputs/DIN0: RN6.1 (R1.1), U33.11 (D0), U38.3 (A1)
/Digital Inputs/DIN1: RN6.2 (R2.1), U33.12 (D1), U38.4 (A2)
/Digital Inputs/DIN2: RN6.3 (R3.1), U33.13 (D2), U38.5 (A3)
/Digital Inputs/DIN3: RN6.4 (R4.1), U33.14 (D3), U38.6 (A4)
/Digital Inputs/DIN4: RN7.1 (R1.1), U33.3 (D4), U38.7 (A5)
/Digital Inputs/DIN5: RN7.2 (R2.1), U33.4 (D5), U38.8 (A6)
/Digital Inputs/DIN6: RN7.3 (R3.1), U33.5 (D6), U38.9 (A7)
/Digital Inputs/DIN7: RN7.4 (R4.1), U33.6 (D7), U38.10 (A8)
/Digital Inputs/VCCB_SRC: D24.3 (COM), JP2.1 (A), R118.2
/Monitors/CC1: J2.A5 (CC1), R7.1, R144.1, U2.1 (IO1)
/Monitors/CC2: J2.B5 (CC2), R11.1, R145.1, U2.3 (IO2)
/Monitors/SRC_ST: R143.2, TP5.1 (1_1), U5.8 (ST)
/Monitors/VIN_P: D14.1 (A1), F1.2, Q5.5 (D), R73.1, R141.1, TP27.1 (1_1)
/Monitors/VOUT_BUF: C73.1, R119.2, R140.1, TP40.1 (1_1)
/Output Stage/DRV_OUT: R115.1, R116.1, R117.1, U22.7 (OUT_A)
/Output Stage/VIN_RAW: F1.1, J3.2, J4.2
/Output Stage/VOUT_S: C71.1, Q10.2 (S), Q11.2 (S), Q15.5 (D), R101.2, R104.2, R107.4, R110.4, R114.1, U24.12 (S2B), U24.13 (S1B)
/Path Switching/LDO_OUT: C53.1, C54.1, D11.2 (A), D12.1 (K), D13.1 (A), Q4.5 (D), R65.1, R69.1, TP26.1 (1_1), U18.1 (OUT), U18.2 (OUT), U18.3 (OUT), U18.9 (OUT)
/Path Switching/SUPPLY: C62.1, Q8.5 (D), Q9.5 (D), Q10.3 (D), Q11.3 (D), Q12.3 (D), Q13.3 (D), Q14.5 (D), R87.1, R90.1, R92.1, R100.1, R101.1, TP33.1 (1_1), U24.4 (S1A)
/Shunt Ladder/INN: C75.1, C77.2, U24.9 (DB), U27.1 (-)
/Shunt Ladder/INP: C76.1, C77.1, U24.8 (DA), U27.4 (+)
GND: C1.2, C2.2, C3.2, C4.2, C5.2, C6.2, C7.2, C8.2, C9.2, C10.2, C11.2, C12.2, C13.2, C14.2, C15.2, C16.2, C17.2, C18.2, C20.2, C21.2, C22.1, C24.2, C25.2, C26.2, C27.2, C28.1, C29.2, C30.2, C31.2, C32.2, C33.2, C34.2, C35.2, C36.2, C37.2, C38.2, C39.2, C40.2, C41.2, C42.2, C44.2, C45.2, C46.2, C47.2, C48.1, C49.2, C50.2, C51.2, C53.2, C54.2, C55.2, C56.2, C57.2, C58.2, C59.2, C62.2, C63.2, C64.2, C65.2, C66.2, C67.2, C68.2, C69.1, C70.2, C71.2, C72.1, C73.2, C74.2, C75.2, C76.2, C78.2, C79.2, C80.2, C81.1, C82.1, C83.2, C84.1, C86.2, C87.2, C88.2, C89.2, C90.2, C91.2, C92.2, C93.2, C94.2, C95.2, C96.2, C97.2, C98.2, C99.2, C100.2, C101.2, C102.2, C103.2, C104.2, C105.2, C106.2, C107.2, C108.2, C109.2, C110.2, C111.2, C112.2, C113.2, D2.2 (A2), D5.1 (K), D8.1 (K), D9.2 (A), D12.2 (A), D14.2 (A2), D15.1 (A), D20.1 (A), D21.2 (A), D22.1 (A), D23.1 (A), D24.1 (A), H1.1 (1_1), H2.1 (1_1), H3.1 (1_1), H4.1 (1_1), J1.3, J2.A12 (GND), J2.B12 (GND), J2.SH (SHIELD), J3.1, J3.4, J4.1, J4.4, J5.2, Q2.2 (S), Q3.2 (S), R2.2, R6.2, R7.2, R8.2, R10.2, R11.2, R12.2, R13.2, R15.2, R17.2, R19.2, R22.2, R23.2, R28.2, R33.2, R36.1, R38.2, R40.2, R44.2, R46.2, R50.2, R52.2, R53.2, R56.2, R57.2, R59.2, R62.2, R66.2, R70.2, R71.2, R74.2, R81.2, R82.2, R85.2, R86.2, R88.2, R89.2, R90.2, R91.2, R93.2, R94.2, R95.2, R103.2, R106.2, R109.2, R115.2, R122.2, R124.2, R135.2, R137.2, R149.2, R150.2, R151.2, R152.2, RN2.5 (R4.2), RN2.6 (R3.2), RN2.8 (R1.2), RN3.6 (R3.2), RN3.7 (R2.2), RN3.8 (R1.2), RN6.5 (R4.2), RN6.6 (R3.2), RN6.7 (R2.2), RN6.8 (R1.2), RN7.5 (R4.2), RN7.6 (R3.2), RN7.7 (R2.2), RN7.8 (R1.2), RN10.5 (R4.2), RN10.6 (R3.2), RN10.7 (R2.2), RN10.8 (R1.2), RN11.5 (R4.2), RN11.6 (R3.2), RN11.7 (R2.2), RN11.8 (R1.2), SH1.1 (Shield_1), SW1.1, TP7.1 (1_1), TP8.1 (1_1), TP15.1 (1_1), TP20.1 (1_1), TP25.1 (1_1), TP28.1 (1_1), TP29.1 (1_1), TP39.1 (1_1), U1.3 (GND), U1.8 (GND), U1.13 (GND), U1.18 (GND), U1.23 (GND), U1.28 (GND), U1.38 (GND), U2.2 (VN), U2.4 (IO3), U2.6 (IO4), U3.1 (GND), U3.9 (GND), U4.1 (GND), U4.9 (GND), U5.1 (GND), U6.2 (GND), U7.2 (GND), U8.2 (GND), U9.1 (GND), U10.2 (GND), U11.2 (GND), U11.9 (PAD), U12.4 (GND), U13.5 (ILIM), U13.8 (GND), U13.11 (GND), U14.11 (V-), U15.5 (~LDAC), U15.7 (Vss), U16.2 (GND), U16.15 (PGND), U19.2 (V-), U20.3 (GND), U21.2 (V-), U22.3 (GND), U23.3 (GND), U24.15 (GND), U28.2 (V-), U29.2 (V-), U30.4 (AINN), U30.5 (GND), U31.4 (V-), U32.2 (V-), U33.8 (GND), U33.15 (~CE), U34.8 (GND), U34.15 (~CE), U35.2 (VN), U36.2 (VN), U37.2 (VN), U38.2 (DIR), U38.11 (GND), U38.12 (GND), U38.13 (GND), U38.22 (~OE), U39.3 (GND), U40.9 (DGND), U40.14 (AGND)
unnamed: C5.1, R14.2
unnamed: C9.1, C10.1, R20.2
unnamed: C26.1, R35.2
unnamed: C29.1, R37.2, U13.1 (IN), U13.2 (IN)
unnamed: C42.1, C45.1, C50.1, FB1.1, R62.1, R67.1, TP21.1 (1_1), U16.4 (VOUT), U16.5 (VOUT)
unnamed: C43.2, R59.1
unnamed: C60.2, R81.1
unnamed: C61.2, R82.1
unnamed: C63.1, R87.2
unnamed: C89.1, R131.2
unnamed: D1.1 (K), U1.39 (VSYS)
unnamed: C2.1, C3.1, D2.1 (A1), D4.1 (K), J2.A9 (VBUS), J2.B9 (VBUS), R9.1, TP1.1 (1_1), U4.4 (VIN)
unnamed: C6.1, D3.2 (A), R14.1, R17.1, TP4.1 (1_1), U3.5 (OUT), U5.6 (VIN2)
unnamed: C7.1, D4.2 (A), R18.1, R20.1, TP2.1 (1_1), U4.5 (OUT), U5.3 (VIN1), U5.5 (MODE)
unnamed: D5.2 (A), R26.2
unnamed: D6.2 (A), L1.2, U10.1 (SW)
unnamed: D10.1 (A), R61.2
unnamed: C47.1, D10.2 (K), D10.3 (common), U18.5 (V_{CONTROL})
unnamed: C43.1, C46.1, D11.1 (K), FB1.2, TP22.1 (1_1), U18.7 (IN), U18.8 (IN)
unnamed: C55.1, D13.2 (K), D13.3 (common), R64.1, R65.2
unnamed: C58.1, D15.3 (common), R73.2, R74.1, R76.1, U21.3 (+)
unnamed: C60.1, D16.1 (A), Q4.4 (G), Q6.3 (C), Q8.4 (G), R78.2, R83.1, TP31.1 (1_1)
unnamed: D16.3 (common), R77.2
unnamed: C61.1, D17.1 (A), Q5.4 (G), Q7.3 (C), Q9.4 (G), R80.2, R84.1, TP32.1 (1_1)
unnamed: D17.3 (common), R79.2
unnamed: D18.1 (A), Q4.1 (S), Q4.2 (S), Q4.3 (S), Q6.2 (E), Q8.1 (S), Q8.2 (S), Q8.3 (S), R83.2
unnamed: D18.2 (K), D18.3 (common), Q6.1 (B), R85.1
unnamed: D19.1 (A), Q5.1 (S), Q5.2 (S), Q5.3 (S), Q7.2 (E), Q9.1 (S), Q9.2 (S), Q9.3 (S), R84.2
unnamed: D19.2 (K), D19.3 (common), Q7.1 (B), R86.1
unnamed: D20.2 (K), R116.2
unnamed: C74.1, D20.3 (common), R117.2, R120.1, TP37.1 (1_1)
unnamed: D21.1 (K), J3.3, J4.3, Q16.5 (D), TP38.1 (1_1)
unnamed: C88.1, D22.2 (K), R129.2, TP42.1 (1_1), U29.5 (V+)
unnamed: C85.1, D22.3 (common), R125.2, R128.1
unnamed: D23.3 (common), R136.2, R137.1, U31.3 (+), U31.5 (+), U32.3 (+)
unnamed: J1.1, U1.1 (GPIO0)
unnamed: J1.2, U1.2 (GPIO1)
unnamed: J5.1, R139.1, U35.1 (IO1)
unnamed: J5.3, RN9.4 (R4.1), U37.6 (IO4)
unnamed: J5.4, RN9.3 (R3.1), U37.4 (IO3)
unnamed: J5.5, RN9.2 (R2.1), U37.3 (IO2)
unnamed: J5.6, RN9.1 (R1.1), U37.1 (IO1)
unnamed: J5.7, RN8.4 (R4.1), U36.6 (IO4)
unnamed: J5.8, RN8.3 (R3.1), U36.4 (IO3)
unnamed: J5.9, RN8.2 (R2.1), U36.3 (IO2)
unnamed: J5.10, RN8.1 (R1.1), U36.1 (IO1)
unnamed: JP1.1 (A), U1.40 (VBUS)
unnamed: JP2.3 (B), R139.2
unnamed: C100.1, JP2.2 (C), TP48.1 (1_1), U38.23 (V_{CCB}), U38.24 (V_{CCB})
unnamed: L2.1, U16.8 (L1), U16.9 (L1)
unnamed: L2.2, U16.6 (L2), U16.7 (L2)
unnamed: Q1.2 (S), R53.1, TP18.1 (1_1), U16.12 (EN)
unnamed: Q2.3 (D), Q3.3 (D), R72.2, U20.4 (IN_B)
unnamed: Q10.1 (G), R92.2
unnamed: Q11.1 (G), R100.2
unnamed: Q12.1 (G), R102.2, R103.1, TP34.1 (1_1)
unnamed: Q12.2 (S), R104.1, U24.5 (S2A)
unnamed: Q13.1 (G), R105.2, R106.1, TP35.1 (1_1)
unnamed: Q13.2 (S), R107.1
unnamed: Q14.4 (G), R108.2, R109.1, TP36.1 (1_1)
unnamed: Q14.1 (S), Q14.2 (S), Q14.3 (S), R110.1
unnamed: Q15.4 (G), Q16.4 (G), R120.2
unnamed: Q15.1 (S), Q15.2 (S), Q15.3 (S), Q16.1 (S), Q16.2 (S), Q16.3 (S)
unnamed: R16.2, TP3.1 (1_1)
unnamed: R58.1, R60.1, U17.1
unnamed: R123.1, U27.2 (Rg)
unnamed: R123.2, U27.3 (Rg)
unnamed: R127.1, R129.1, U28.1
unnamed: RN1.1 (R1.1), U1.16 (GPIO12)
unnamed: RN1.2 (R2.1), RN2.2 (R2.1), U1.17 (GPIO13)
unnamed: RN1.3 (R3.1), RN2.3 (R3.1), U1.19 (GPIO14)
unnamed: RN1.4 (R4.1), RN2.4 (R4.1), U1.20 (GPIO15)
unnamed: RN3.1 (R1.1), RN4.1 (R1.1), U1.25 (GPIO19)
unnamed: RN3.2 (R2.1), RN4.2 (R2.1), U1.26 (GPIO20)
unnamed: RN3.3 (R3.1), RN4.3 (R3.1), U1.27 (GPIO21)
unnamed: RN3.4 (R4.1), RN4.4 (R4.1), U1.29 (GPIO22)
unnamed: R3.1, RN4.5 (R4.2)
unnamed: RN5.1 (R1.1), U30.8 (SCLK)
unnamed: RN5.2 (R2.1), U30.7 (DOUT)
unnamed: RN5.3 (R3.1), U30.6 (CONVST)
unnamed: RN9.8 (R1.2), RN10.1 (R1.1), U38.17 (B5)
unnamed: RN9.7 (R2.2), RN10.2 (R2.1), U38.16 (B6)
unnamed: RN9.6 (R3.2), RN10.3 (R3.1), U38.15 (B7)
unnamed: RN9.5 (R4.2), RN10.4 (R4.1), U38.14 (B8)
unnamed: RN8.8 (R1.2), RN11.1 (R1.1), U38.21 (B1)
unnamed: RN8.7 (R2.2), RN11.2 (R2.1), U38.20 (B2)
unnamed: RN8.6 (R3.2), RN11.3 (R3.1), U38.19 (B3)
unnamed: RN8.5 (R4.2), RN11.4 (R4.1), U38.18 (B4)
unnamed: R2.1, U1.33 (AGND)
unnamed: R1.2, U1.15 (GPIO11)
unnamed: R4.2, U1.34 (GPIO28_ADC2)
unnamed: SW1.2, U1.30 (RUN)
unnamed: R5.2, R6.1, U3.3 (EN/UVLO)
unnamed: R13.1, U3.7 (ILM)
unnamed: R8.1, U3.8 (OVLO/OVCSEL)
unnamed: R9.2, R10.1, U4.3 (EN/UVLO)
unnamed: R15.1, R16.1, U4.7 (ILM)
unnamed: R12.1, U4.8 (OVLO/OVCSEL)
unnamed: C4.1, U4.2 (dV/dT)
unnamed: C8.1, R18.2, R19.1, U5.4 (PR1)
unnamed: R24.2, U6.4 (CT)
unnamed: C12.1, R21.2, R22.1, U6.5 (SENSE)
unnamed: R29.2, U9.2 (~RESET), U10.4 (EN)
unnamed: C23.2, R32.2, R33.1, U10.3 (FB)
unnamed: C19.1, U11.8 (C+)
unnamed: C19.2, U11.7 (C-)
unnamed: C22.2, U11.3 (CPOUT)
unnamed: R27.2, R28.1, U11.6 (EN)
unnamed: R34.1, R36.2, U11.5 (VFB)
unnamed: C21.1, R30.2, U11.1 (VIN)
unnamed: C24.1, U12.5 (Trim/NR)
unnamed: C20.1, R31.2, U12.2 (Vin)
unnamed: R39.2, R40.1, U13.6 (PGFB)
unnamed: C30.1, R38.1, U13.7 (SET)
unnamed: R45.2, R46.1, U14.3 (+)
unnamed: C33.1, R43.2, R44.1, U14.2 (-), U14.5 (+), U14.13 (-)
unnamed: C34.1, R47.2, R48.1, U14.6 (-)
unnamed: R42.2, U14.10 (+)
unnamed: C32.1, R41.2, R43.1, U14.9 (-)
unnamed: R49.2, R50.1, U14.12 (+)
unnamed: R54.1, U15.8 (Vout)
unnamed: C38.1, R55.2, R56.1, TP19.1 (1_1), U15.6 (Vref)
unnamed: C52.2, R63.2, TP24.1 (1_1), U16.3 (FB), U19.1
unnamed: C37.1, U16.1 (VINA), U16.13 (PS/SYNC)
unnamed: C41.1, R54.2, U17.3 (+)
unnamed: R57.1, R58.2, U17.4 (-)
unnamed: C49.1, R60.2, TP23.1 (1_1), U18.4 (SET)
unnamed: R66.1, R67.2, R68.2, U19.3 (+)
unnamed: C52.1, R63.1, R64.2, U19.4 (-)
unnamed: R75.2, U20.2 (IN_A)
unnamed: R77.1, R78.1, U20.7 (OUT_A)
unnamed: R79.1, R80.1, U20.5 (OUT_B)
unnamed: R98.2, U22.2 (IN_A)
unnamed: R96.2, U22.4 (IN_B)
unnamed: R108.1, U22.5 (OUT_B)
unnamed: R99.2, U23.2 (IN_A)
unnamed: R97.2, U23.4 (IN_B)
unnamed: R105.1, U23.7 (OUT_A)
unnamed: R102.1, U23.5 (OUT_B)
unnamed: R112.2, U24.1 (A0)
unnamed: R111.2, U24.16 (A1)
unnamed: R113.2, U24.2 (EN)
unnamed: R107.2, U24.6 (S3A)
unnamed: R107.3, U24.11 (S3B)
unnamed: R110.2, U24.7 (S4A)
unnamed: R110.3, U24.10 (S4B)
unnamed: R114.2, U25.3 (+)
unnamed: R118.1, R119.1, U25.1, U25.4 (-)
unnamed: C78.1, R121.2, R122.1, U26.3 (+)
unnamed: TP41.1 (1_1), U26.1, U26.4 (-), U27.6 (Ref)
unnamed: R126.2, U28.3 (+)
unnamed: R124.1, R127.2, U28.4 (-)
unnamed: C87.1, R128.2, U29.3 (+)
unnamed: C85.2, R130.1, U29.1, U29.4 (-)
unnamed: C90.1, R130.2, TP43.1 (1_1), U30.3 (AINP)
unnamed: C93.1, R132.2, R133.1, U31.2 (-)
unnamed: C94.1, R133.2, R134.1, U31.6 (-)
unnamed: C95.1, R134.2, R135.1, U32.4 (-)
unnamed: U33.9 (Q7), U34.10 (DS)
unnamed: R138.1, U34.9 (Q7)
unnamed: R146.1, U39.2 (V_{OUT})
unnamed: C103.1, R140.2, R149.1, U40.1 (CH0)
unnamed: C104.1, R141.2, R150.1, U40.2 (CH1)
unnamed: C105.1, R142.2, R143.1, R151.1, U40.3 (CH2)
unnamed: C106.1, R144.2, U40.4 (CH3)
unnamed: C107.1, R145.2, U40.5 (CH4)
unnamed: C108.1, R146.2, U40.6 (CH5)
unnamed: C109.1, R147.2, R152.1, U40.7 (CH6)
unnamed: C110.1, R148.2, R153.1, U40.8 (CH7)
VREF: C113.1, D7.2 (A), R35.1, R49.1, R55.1, R68.1, R121.1, R126.1, R131.1, R132.1, R148.1, TP14.1 (1_1), U12.6 (Vout), U21.4 (-), U30.1 (REF), U40.15 (Vref)
