Guiimartinho/open-power-profiler/(commit log)

2026-10-12 feat(hardware): draw decisions D-95, D-97 and D-98
    The three decisions that follow the circuit simulations and need no
    copper are drawn in the schematic and on the board as changes of
    values, part numbers, fitted flags and texts:
    - D-95: C32, C33 and C34 of the rail monitor are 10 nF C0G
    (GRM1885C1H103JA01D), not 1 nF.
    - D-98: the damper on the input from the controller module is fitted,
    R14 at 0.33 ohm (ERJ-6RQFR33V) and C5 at 10 uF (CL21A106KAYNNNE).
    - D-97: the position U9 stays without a part, and its text no longer
    names the detector with the time-out of 0.24 s.
    No track, via, zone or footprint position changed. The electrical
    rules check and the design rules check with schemati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
    [analog_rails.kicad_sch, bom.csv, power-profiler-carrier.kicad_pcb, power_input.kicad_sch, rail_monitor.kicad_sch]
2026-10-12 feat(simulation): follow the drawn decisions in the netlist snapshot
    The snapshot of the netlist is written again from the schematic that
    holds decisions D-95, D-97 and D-98. Six parts changed: C32 to C34 are
    10 nF, R14 and C5 are fitted with their part numbers, and U9 has its
    new value text.
    The benches were not run again. The results on file are those of the
    circuit before the three changes, and the benches of the power input
    still leave R14 and C5 out.
2026-10-12 chore(simulation): license the netlist and the results as hardware
    The snapshot of the netlist and the results are derived from the
    schematic, so they carry the license of the hardware, CERN-OHL-P v2
    (D-102). Each folder gets its license file, and the source
    distribution of the package is limited to the package and its tests,
    which stay under MIT.
2026-10-12 feat(protocol)!: version 2 of the host protocol
    Draft A2 of the carrier reports more than version 1 held. Version 2
    adds it in one step, while no instrument and no capture exist (D-103):
    - Sample word: marks for over-range and under-range and the request
    of the output switch, in three of the reserved bits.
    - Fault flags: fifteen, one for each cause of section 6.4 of the
    specification, where version 1 had four.
    - GET_STATUS returns 25 bytes and GET_INFO 48: mode, locked range,
    set-point, readings, the supply in use with its CC class and its
    budget as a current, trips, notices, the state of the calibration,
    identity and zero offsets.
    - Events "supply changed" and "notice" replace "p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
2026-10-12 feat(firmware): extend the hardware-independent core
    More of the logic that needs no hardware, each part with unit tests on
    the PC. The rule numbers are those of section 6.6 of the
    specification.
    - acq: the raw word of the capture split into conversion result and
    side bits, with the over-range mark of F-35 and the output bit; the
    under-range rule of F-22.
    - base: the pin table with direction, drive strength and pad pull of
    every pin, and the checks of F-4 and F-5.
    - smu: the DAC frame of F-6 and the nominal set-point code of F-30.
    - monitor: the scale of the eight monitor channels, the source of the
    5 V rail (F-11) and the rails test (F-12).
    - app: the fifteen fault causes of sectio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
2026-10-12 build(firmware)!: replace the ESP-IDF project by a Pico SDK project
    The controller is a Raspberry Pi Pico 2 since D-39, and the firmware
    directory still held the build of the first plan, for the ESP32-S3.
    It is a project of the Pico SDK now:
    - CMakeLists.txt and the preset pico2 build an image for the RP2350
    with SDK 2.3.1, warnings as errors. PICO_SDK_PATH and
    PICO_TOOLCHAIN_PATH come from the environment.
    - Every hardware-independent component is compiled for the target
    from the manifests that the unit tests use.
    - main.c is the composition root: it starts the console on UART0 and
    the device state machine. It drives the console output and no other
    pin: no adapter and no PIO prog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
    [gcovr.cfg]
2026-10-13 docs: add the firmware design
    A design of the firmware, one level below section 6 of the
    specification:
    - README: what exists, the work cut into five packages, the points
    decided on 2026-10-12 and the seven that are still open.
    - Architecture: layers, components, ports, what runs on each core and
    in each interrupt, the data path, design patterns, builds and tests.
    - State machines: the device states, the start, the self-test, DUT
    power on and off in both modes, the fault causes, the supervision
    cycle and the range rules of core 1.
    - PIO programs: capture, range sequencer, output and trip, as sketches
    with their timing counted in clocks. The assembler of the Pico SDK
    accepts them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
2026-10-13 docs(spec): record D-99 to D-104 and follow the simulations
    One file holds two bodies of work, which could not be staged apart.
    After the circuit simulations of 2026-10-10:
    - Twelve of the fourteen places where the text and the simulations
    differed carry the simulated figure, marked as such. Two wait for a
    new run of the benches, and seven questions are open in section 16.
    - D-99: rule F-18 counts the time of the over-current trip with R3
    selected only. D-100: the advice on a capacitor at the VIN terminals
    is limited to what was simulated. D-101: a logic input is specified
    for 0 V to 5.5 V. D-102: the netlist snapshot and the results of the
    simulations carry the license of the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
2026-10-13 docs(spec): describe D-95 and D-98 as drawn in five more places
    Sections 3 and 4.1, the risk register and the item of the rail monitor
    in section 16 still spoke of drawings with 1 nF and of a damper
    without parts. The drawings hold both decisions since 2026-10-10; what
    stays open is the run of the benches with them.
2026-10-13 docs: bring the guides to the state of 2026-10-12
    The README, the guides of every area, the indexes under docs/, the
    contributing guide, the bug report form and the changelog describe
    the project as it stands:
    - Firmware: the design in docs/firmware/, the grown core with its 22
    tests, the build for the Pico 2 with its commands, and what is not
    written (adapters, PIO programs, USB link, command handlers).
    - Protocol and host: version 2 on both sides, what it added, and what
    is still open (the calibration record is a layout only; the
    statistics do not yet fill flagged samples as section 9 asks).
    - Hardware: decisions D-95, D-97 and D-98 are drawn and checked by the
    rules checks; D-9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
2026-10-14 chore(hardware): keep KiCad's settings blocks, ignore its history
    KiCad 10 wrote its default `erc` and `schematic` blocks into the
    project file when the project was opened in the editor on 2026-10-13:
    334 lines added, no setting changed, the rule severities of the board
    and the net classes are the same. It also keeps a local `.history/`
    folder beside the project, which is ignored from now on.
2026-10-14 fix(hardware): apply review findings and frame the blocks on silk
    The review of footprints and placement of 2026-10-13 found five
    points on the carrier board (draft A2). This commit corrects them and
    adds the frames of the placement blocks to the silkscreen. Nothing
    was routed again: every track, 683 of the 694 vias, the place of
    every footprint and the outline of every copper zone are unchanged.
    - U16 (TPS63020DSJR) stood on the land pattern of another maker's
    package of the same body. It has the land pattern of the TI DSJ
    package now, a new project footprint: thermal land 1.58 mm x
    2.85 mm, lands 0.60 mm x 0.24 mm, eight paste openings. The sheet,
    the project symbol and one line o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
    [bom.csv, power-profiler-carrier.kicad_pcb, source_meter.kicad_sch]
2026-10-14 docs(hardware): plot the board pictures and the schematic PDF again
    The six pictures of the board follow the changed copper and the new
    silkscreen. The PDF of the schematic carries the footprint name of
    U16 in its symbol data; its fifteen pages show what they showed.
2026-10-14 feat(hardware): add the fabrication outputs of draft A2
    Outputs for a first order of proof-of-concept boards, exported from
    the board file of this branch: eleven Gerber files of the four-layer
    board and two drill files, the same as an archive for upload, and a
    bill of materials and a placement file in the column layout of
    JLCPCB (360 surface-mount placements in 142 lines). A page in the
    folder gives the order data and what is fitted by hand.
    The drill file holds 787 plated holes, the 694 vias and the 93 pad
    holes of the board. Every layer, the drill file and the placement
    file lie in one coordinate frame. No Gerber viewer has read the files
    back, no manufacturer has reviewed them, the colum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
    [jlcpcb-bom.csv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]
2026-10-14 docs(spec): record D-105 and the state of the board on 2026-10-13
    D-105: the fabrication outputs of draft A2 are filed for an order of
    proof-of-concept boards while the items of section 16 under "Before
    the board is ordered" are open; such boards are draft A2, not
    revision A, and the items stay open. Decided by the project owner.
    Sections 10, 13, 14 and 16 and the head of the document describe the
    board after the review of footprints and placement and its
    corrections. No requirement and no section number changed.
2026-10-14 docs: bring the guides to the state after the board review
    The README, the documentation index, the hardware guide, the guide of
    its pictures, the contributing guide, the indexes of the checks and
    of the reports, the page of the board figures and the changelog say
    what is true after 2026-10-13: the project owner looked at the project
    in the KiCad editor, the footprints and the placement were reviewed
    on renderings, by measurement and against datasheets, five findings
    were corrected, the blocks are framed on the silkscreen, and the
    fabrication outputs of draft A2 are filed (D-105). An item-by-item
    review in the editor, 95 hidden reference texts, two vias at pads and
    the open items of section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
