Guiimartinho/open-power-profiler/(notices)

Notices in the files:
docs/specification.md:
D-13 | MIT for firmware and host software, CERN-OHL-P v2 for hardware | Permissive licenses, chosen by the project owner
snapshot of the netlist in `simulation/netlist/` and everything in `simulation/results/`, the decks, the records, the graphs and the pages, are under CERN-OHL-P v2, with a copy of that license in each of the two folders (decided by the project owner on 2026-10-10, who left the split to this record)
README.md:
Hardware license: CERN-OHL-P v2
